uccross/open-source-autonomous-vehicle-controller/README.md

# Open Source Autonomous Vehicle Controller
