uccross/open-source-autonomous-vehicle-controller/path-finding/Readme.md

## <div align="center">Path Finding</div>

Detection of the course markers to help an autonomous vehicle find an optimal trajectory to complete the circuit. For detection of course markers(coloured cones), ML(object detection) and CV algorithms will be used.
