uccross/open-source-autonomous-vehicle-controller/documentation/docs/index.md

---
layout: home

hero:
  name: "OSAVC"
  text: "Open Source Autonomous Vehicle Controller"
  tagline:
  image:
    src: https://i.ibb.co/3Tjw3gv/OSAVC-BOARD.png
    alt: OSAVC
  actions:
    - theme: brand
      text: Getting Started
      link: /guide/introduction
    - theme: alt
      text: View on Github
      link: 'https://github.com/uccross/open-source-autonomous-vehicle-controller'

features:

  - title: Real Time Control
    details: Provides the link between real-time control and intelligent decision making.
    
  - title: OpenSource
    details: Not only an open source software project but also utilizes open source hardware solutions and technologies.

  - title: Multi-pin
    details: Convenient multi-pin wire-to-board connectors to support a wide variety of peripheral devices
---
