uccross/open-source-autonomous-vehicle-controller/documentation/docs/blog/posts/post1.md

---

date: 2023-06-28
title: 'Setting Up Hardware'
category: Tutorial
tags:
  - Hardware
  - Connections
---
> Getting Trouble Setting up the Hardware ?

---

## Connection Failure?

- Unplug PICkit from computer
- Quit MPLAB X and reopen

## PICkit configuration

## Voltage not Detected ?

J2 ICSP pins are connected incorrectly with the PICkit in-circuit debugger's pins
