uccross/open-source-autonomous-vehicle-controller/documentation/docs/projects/posts/balancingBot.md

---
Author: Carlos Espinosa
Updated: 2023-07-30
image: 
---

# Balancing Bot

> A setup with two motors ....

<!-- more -->

## Concept

it works by calculating .........
