uccross/open-source-autonomous-vehicle-controller/documentation/docs/assets/images/first_project/2.png

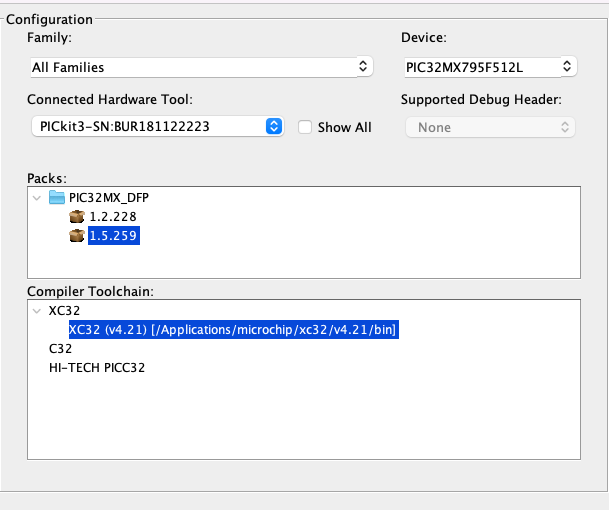
documentation/docs/assets/images/first_project/2.png
