uccross/open-source-autonomous-vehicle-controller/documentation/docs/assets/images/Hardware/OSAVC_BOARD.png

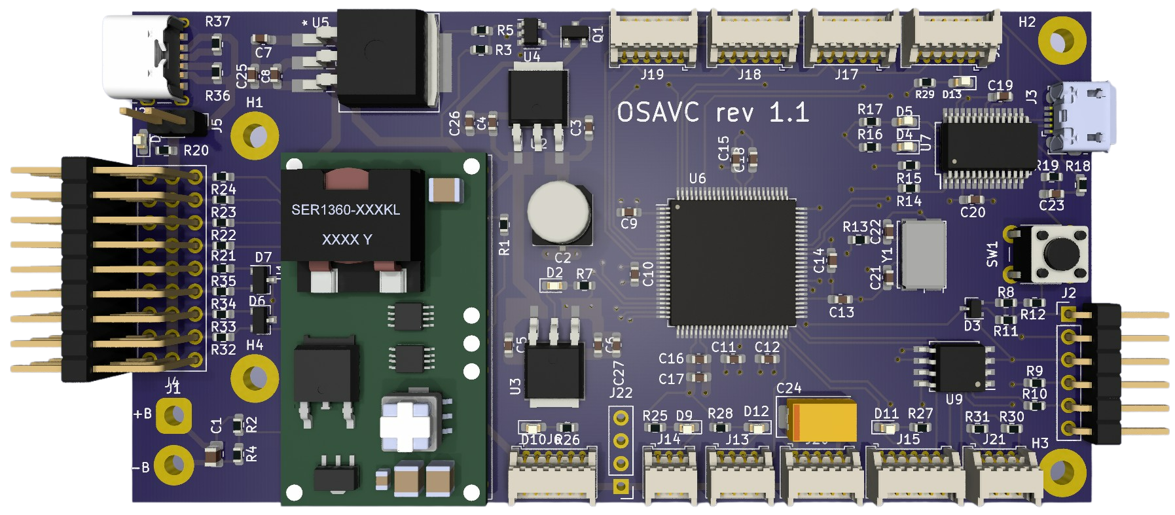
documentation/docs/assets/images/Hardware/OSAVC_BOARD.png
