uccross/open-source-autonomous-vehicle-controller/Hardware/OSAVC/OSAVC.png

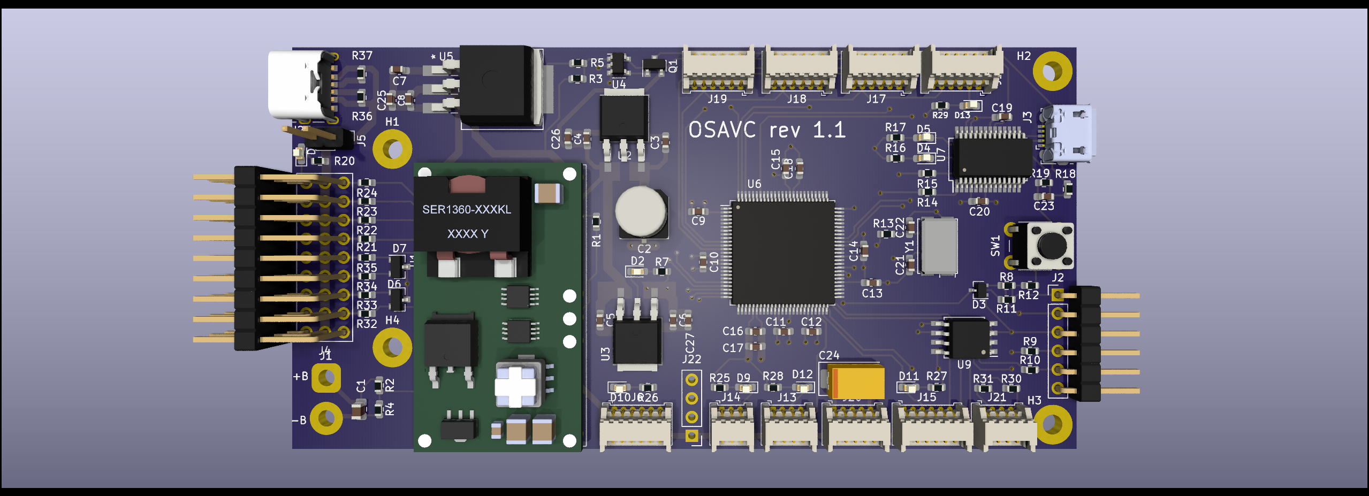
Hardware/OSAVC/OSAVC.png
