uccross/open-source-autonomous-vehicle-controller/Hardware/OSAVC/OSAVC_bottom.png

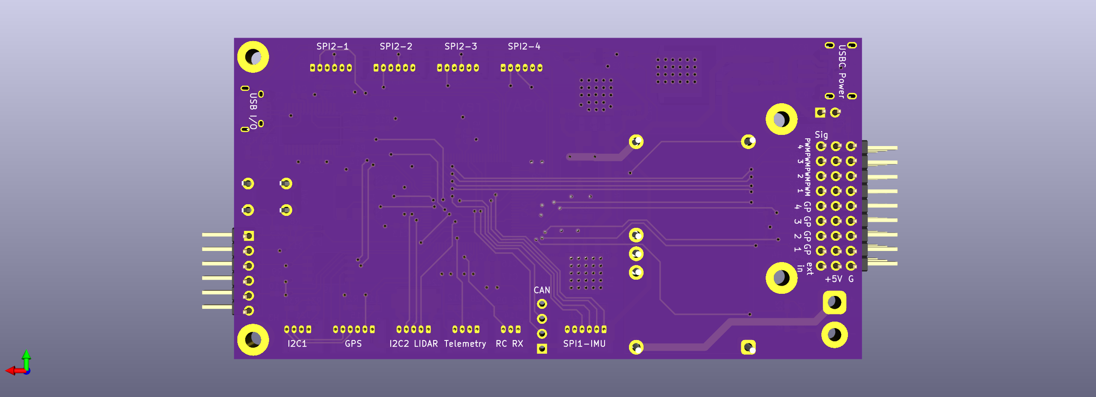
Hardware/OSAVC/OSAVC_bottom.png
