uccross/open-source-autonomous-vehicle-controller/Hardware/OSAVC/OSAVC_Iso.png

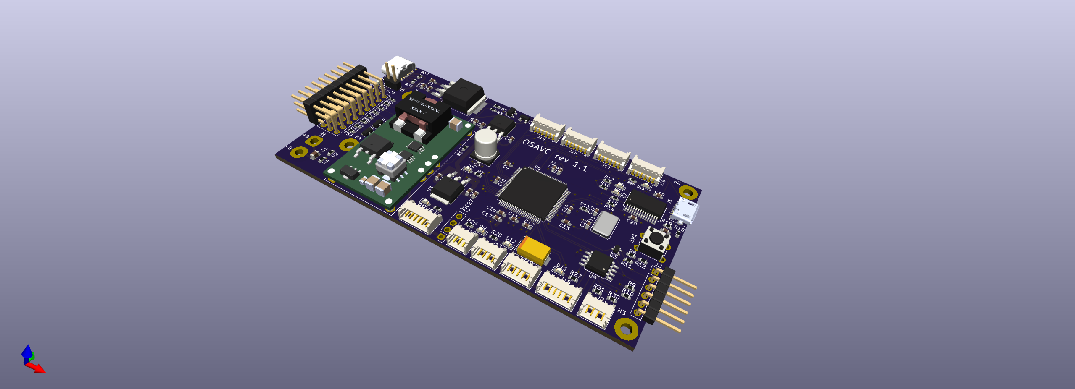
Hardware/OSAVC/OSAVC_Iso.png
