uccross/open-source-autonomous-vehicle-controller/path-finding/yolov5-coral/images/2.jpg

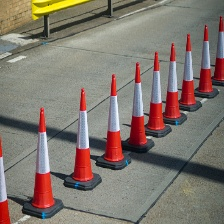
path-finding/yolov5-coral/images/2.jpg
