uccross/open-source-autonomous-vehicle-controller/path-finding/yolov5-coral/images/4.jpg

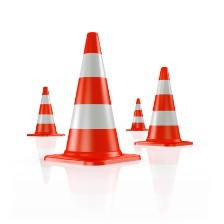
path-finding/yolov5-coral/images/4.jpg
