uccross/open-source-autonomous-vehicle-controller/python/images/bicycle_model.png

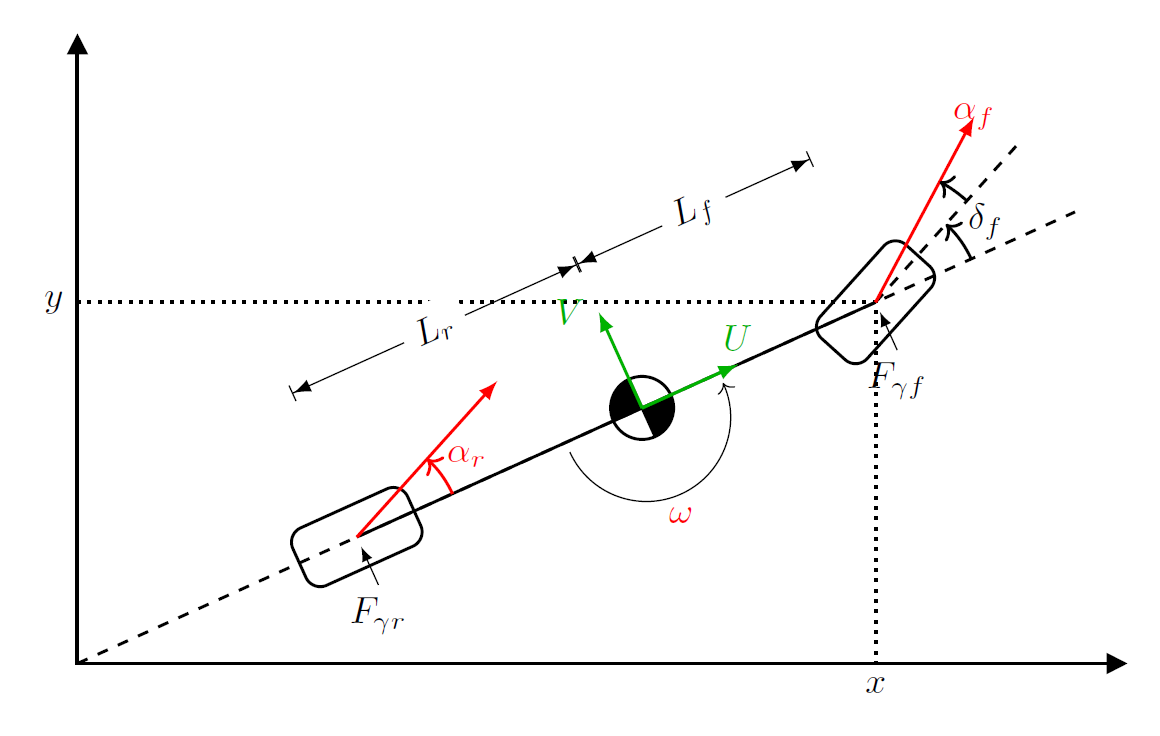
python/images/bicycle_model.png
