uccross/open-source-autonomous-vehicle-controller/Quadcopter/Mechanical/Autopilot/Daughter_Board.SLDASM

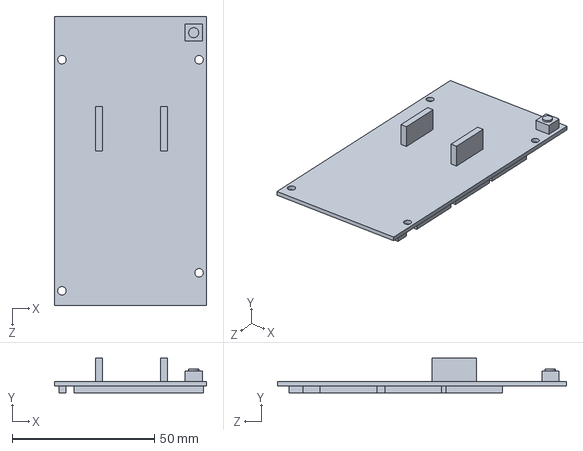
[picture p36: CAD file, 2022-08-05]
Quadcopter/Mechanical/Autopilot/Daughter_Board.SLDASM
53.5 x 12.3 x 101.7 mm
