uccross/open-source-autonomous-vehicle-controller/Quadcopter/Mechanical/Quadcopter_DJI_Flame_Wheel_F450_OSAVC_rev1.1.SLDASM

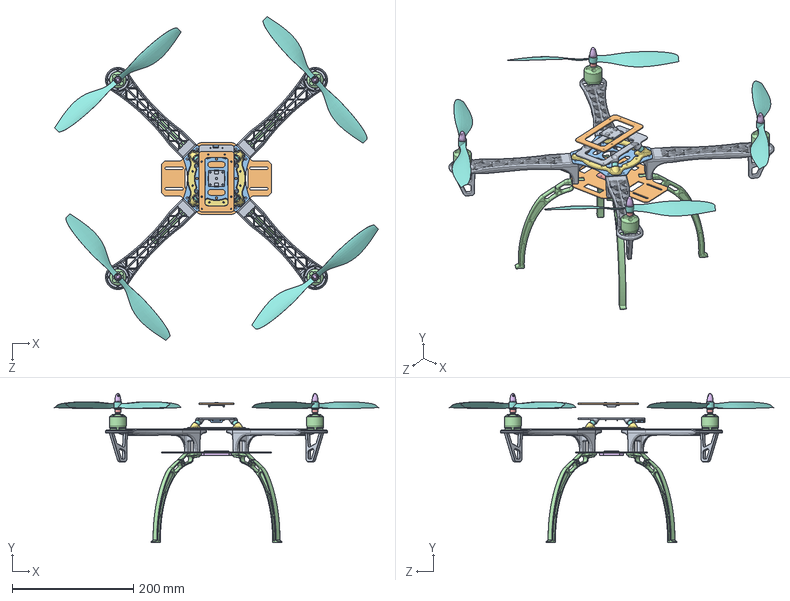
[picture p37: CAD file, 2022-12-21]
Quadcopter/Mechanical/Quadcopter_DJI_Flame_Wheel_F450_OSAVC_rev1.1.SLDASM
534.5 x 246.2 x 534.5 mm
DJI_Flame_Wheel_F450_PowerDistribution
DJI_Flame_Wheel_F450_Arm x 4
DJI_Flame_Wheel_F450_TopPCB
DJI_Flame_Wheel_F450_High_Landing_Gear x 4
Mount_Lidar_V1_fixture
Mount_Lidar_V1_base
Mount_autopilot_vibration_suppression
Rubber_vibration_isolation x 4
Mount_Controller
Mount_autopilot_fixture
Mount_FrSky_R-XSR_Tiny_16
BLDC_A2212_13T_1000KV x 4
BLDC_A2212_13T_1000KV_PropCollar x 4
BLDC_A2212_13T_1000KV_PropNut x 4
BLDC_A2212_13T_1000KV_PropThread x 4
Prop-10x4_5 x 4
Qwiic_9DoF_IMU_Sparkfun
Mount_Raspberry_Pi
