uccross/open-source-autonomous-vehicle-controller/Rover/Mechanical/Frame/MG996R SERVO/MG996R SBORKA.SLDASM

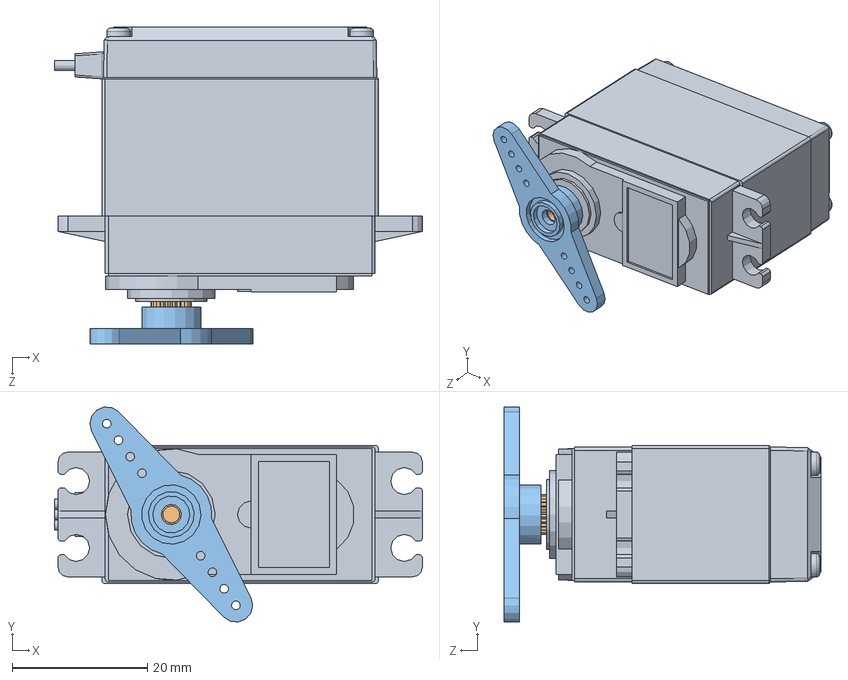
[picture p38: CAD file, 2022-12-21]
Rover/Mechanical/Frame/MG996R SERVO/MG996R SBORKA.SLDASM
54.5 x 31.8 x 47.0 mm
Servo MG996R
Servo MG996R Shaft
Servo MG996R arm01
