uccross/open-source-autonomous-vehicle-controller/Rover/Mechanical/Frame/Wheel/Wheel_RC.SLDASM

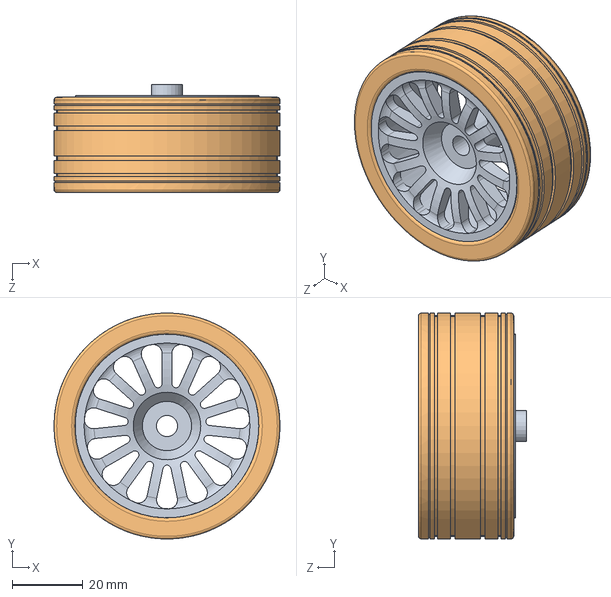
[picture p39: CAD file, 2022-12-21]
Rover/Mechanical/Frame/Wheel/Wheel_RC.SLDASM
64.0 x 64.0 x 30.6 mm
wheel_rin
Wheel
