uccross/open-source-autonomous-vehicle-controller/Rover/Mechanical/Rover_V1.SLDASM

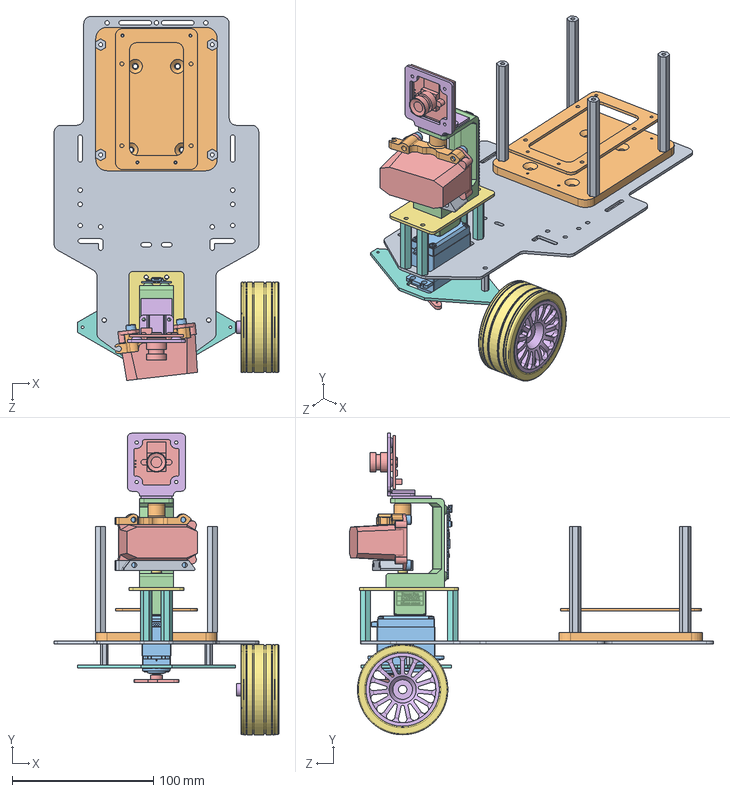
[picture p40: CAD file, 2022-12-21]
Rover/Mechanical/Rover_V1.SLDASM
159.2 x 213.5 x 257.7 mm
Chassis_upper
micro_holder
Servo MG996R
Servo MG996R Shaft
Servo MG996R arm01
wheel_rin
Wheel
Mount_Wheel_axis-Stearing_servo
Standoff_15mm x 2
Mount_Raspberry_Pi
RaspberryPi_Pico
Tower-Pro-MG90S
LIDAR-Lite_V3HP_Garmin
Board_AS5047D
Servo_lever
Magnet_AS5047D
Mount_Lidar-Servo
Mount_Lidar-Magnet
Screw_M4_Hexhead x 4
Mount_Hybrid_sensor
Arducam_B0332
Mount_Hybrid_sensor-Camera
Hybrid_sensor_Rover_mount
Hex_Standoffs x 4
Hex_standoff_75mm x 4
