uccross/open-source-autonomous-vehicle-controller/Quadcopter/Mechanical/Autopilot/Max32.SLDASM

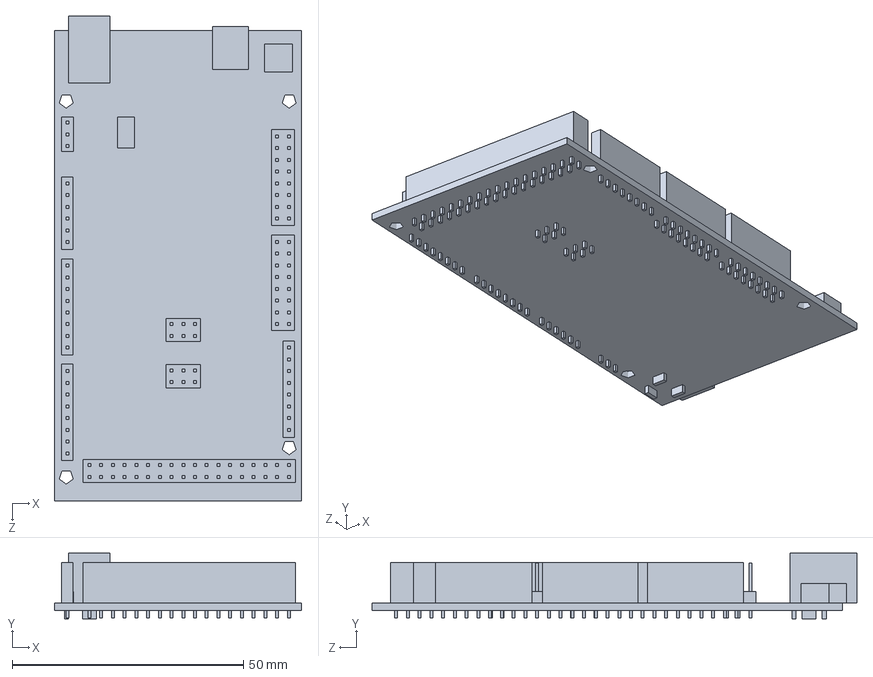
[picture p41: CAD file, 2022-08-05]
Quadcopter/Mechanical/Autopilot/Max32.SLDASM
53.5 x 14.2 x 105.0 mm
