uccross/open-source-autonomous-vehicle-controller/Quadcopter/Mechanical/Frame/DJI_Flame_Wheel_F450.SLDASM

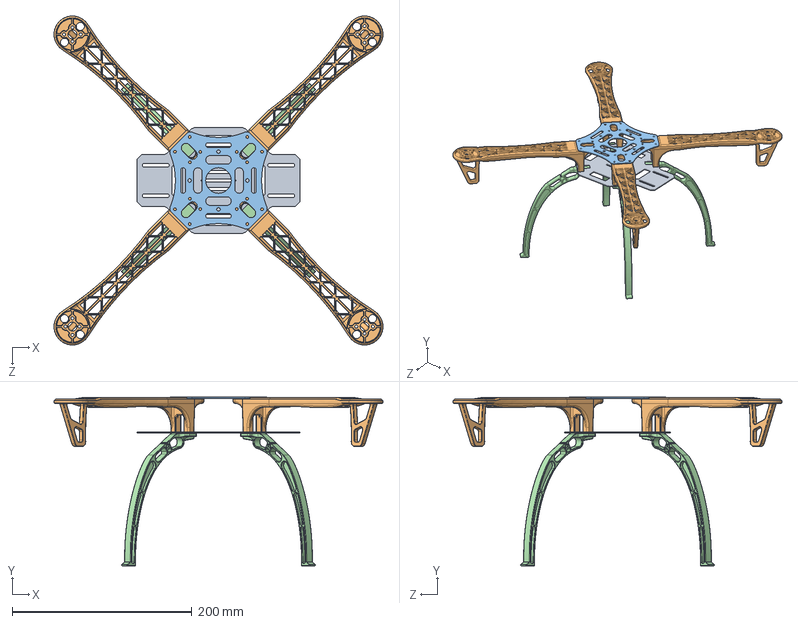
[picture p42: CAD file, 2022-08-05]
Quadcopter/Mechanical/Frame/DJI_Flame_Wheel_F450.SLDASM
366.4 x 188.2 x 366.4 mm
DJI_Flame_Wheel_F450_PowerDistribution
DJI_Flame_Wheel_F450_Arm x 4
DJI_Flame_Wheel_F450_TopPCB
DJI_Flame_Wheel_F450_High_Landing_Gear x 4
