uccross/open-source-autonomous-vehicle-controller/Self-balancing_bot/Mechanical/Main_support_front.SLDPRT

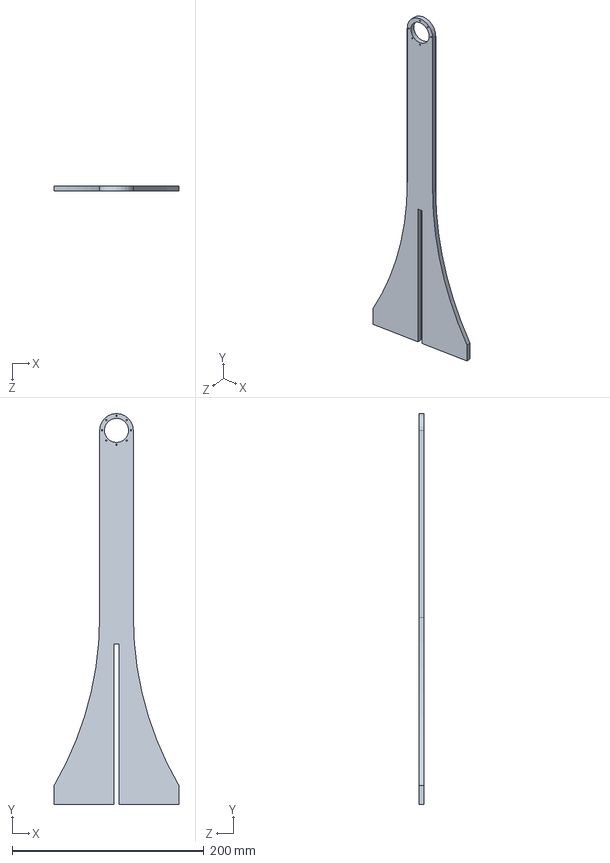
[picture p44: CAD file, 2023-08-13]
Self-balancing_bot/Mechanical/Main_support_front.SLDPRT
130.0 x 407.6 x 5.40 mm
