uccross/open-source-autonomous-vehicle-controller/Quadcopter/Mechanical/Motor/BLDC_A2212_13T_1000KV_Assemly.SLDASM

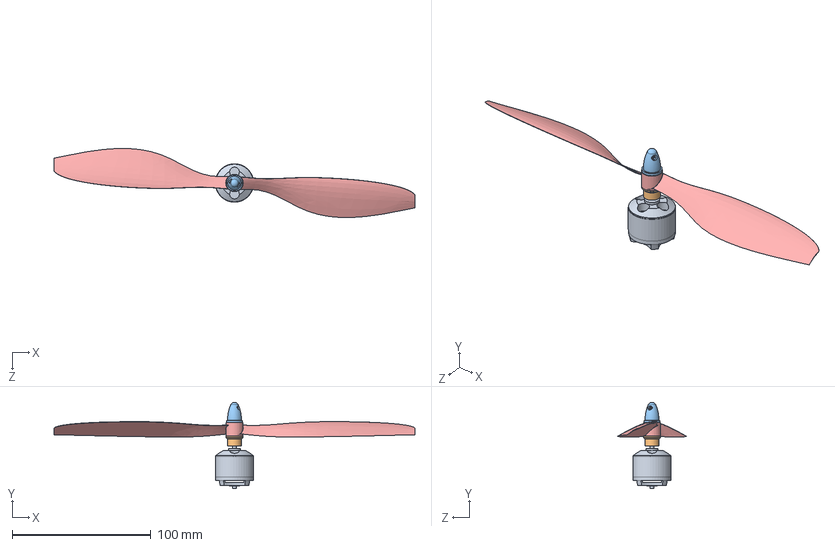
[picture p45: CAD file, 2022-08-05]
Quadcopter/Mechanical/Motor/BLDC_A2212_13T_1000KV_Assemly.SLDASM
260.0 x 62.3 x 49.7 mm
BLDC_A2212_13T_1000KV
BLDC_A2212_13T_1000KV_PropCollar
BLDC_A2212_13T_1000KV_PropNut
BLDC_A2212_13T_1000KV_PropThread
Prop-10x4_5
