uccross/open-source-autonomous-vehicle-controller/Rover/Mechanical/Frame/Rover_frame.SLDASM

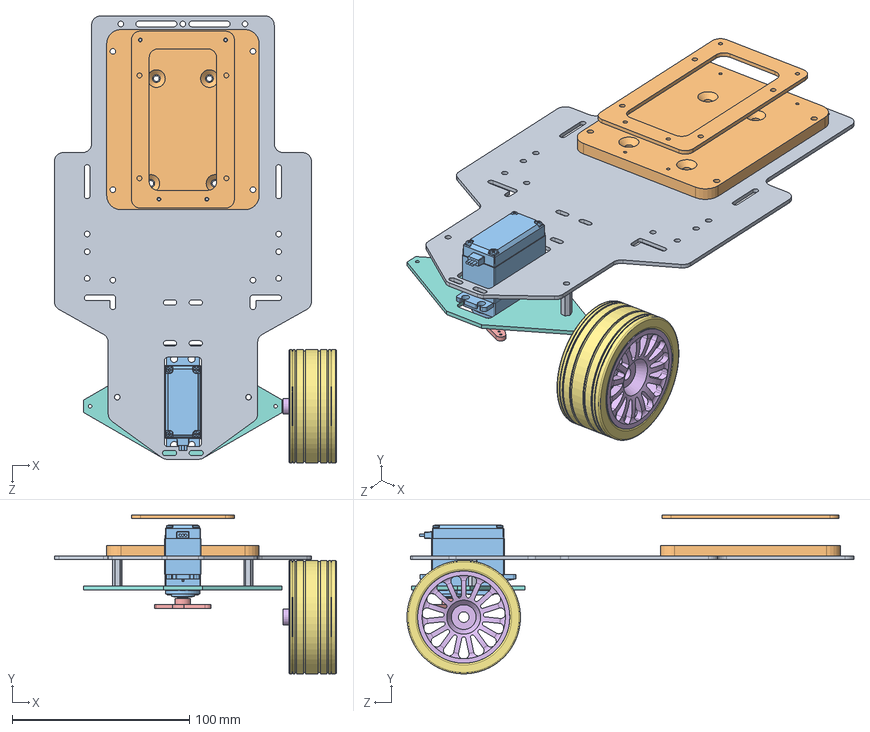
[picture p46: CAD file, 2022-12-21]
Rover/Mechanical/Frame/Rover_frame.SLDASM
159.2 x 89.5 x 252.1 mm
Chassis_upper
micro_holder
Servo MG996R
Servo MG996R Shaft
Servo MG996R arm01
wheel_rin
Wheel
Mount_Wheel_axis-Stearing_servo
Standoff_15mm x 2
Mount_Raspberry_Pi
