uccross/open-source-autonomous-vehicle-controller/Quadcopter/Mechanical/Stabilization_test/Stabilization_test_platform_T-joint_assembly.SLDASM

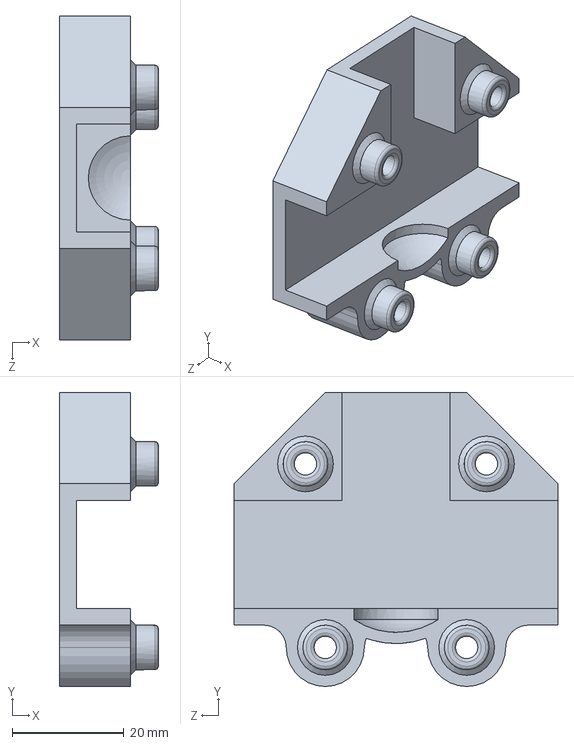
[picture p47: CAD file, 2022-12-21]
Quadcopter/Mechanical/Stabilization_test/Stabilization_test_platform_T-joint_assembly.SLDASM
17.7 x 52.7 x 58.0 mm
