uccross/open-source-autonomous-vehicle-controller/Rover/Mechanical/Hybrid_sensor/Hybrid_sensor.SLDASM

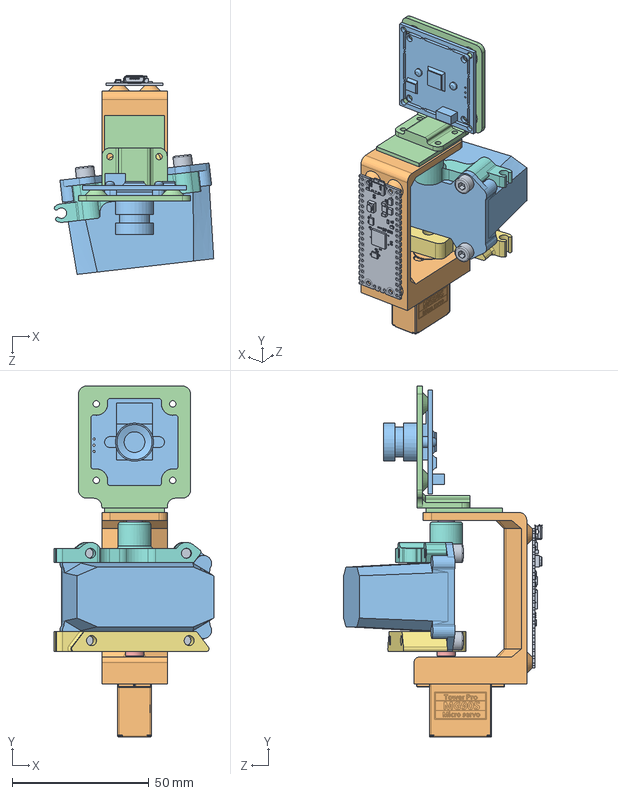
[picture p48: CAD file, 2022-12-21]
Rover/Mechanical/Hybrid_sensor/Hybrid_sensor.SLDASM
58.4 x 128.6 x 72.8 mm
RaspberryPi_Pico
Tower-Pro-MG90S
LIDAR-Lite_V3HP_Garmin
Board_AS5047D
Servo_lever
Magnet_AS5047D
Mount_Lidar-Servo
Mount_Lidar-Magnet
Screw_M4_Hexhead x 4
Mount_Hybrid_sensor
Arducam_B0332
Mount_Hybrid_sensor-Camera
