uccross/open-source-autonomous-vehicle-controller/Self-balancing_bot/Mechanical/Encoder_AS5047D.SLDASM

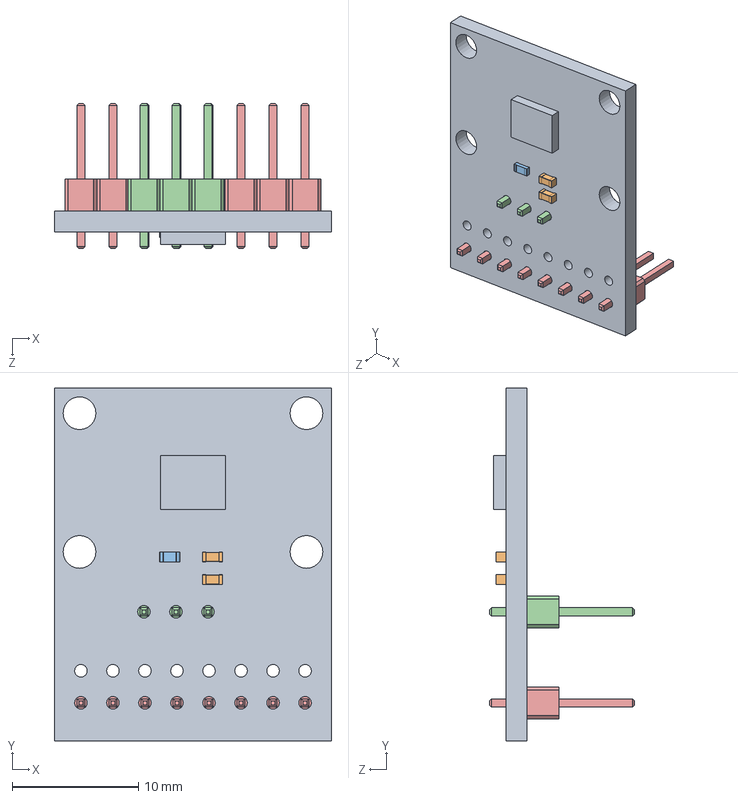
[picture p49: CAD file, 2023-08-13]
Self-balancing_bot/Mechanical/Encoder_AS5047D.SLDASM
22.0 x 28.0 x 11.5 mm
PCB_AS5047D^Encoder_AS5047D
C_0603_1608^Encoder_AS5047D x 2
R_0603_1608^Encoder_AS5047D
Header_1x03_P2.54mm_Vertical^Encoder_AS5047D
Header_1x08_P2.54mm_Vertical^Encoder_AS5047D
