uccross/open-source-autonomous-vehicle-controller/Self-balancing_bot/Mechanical/Propeller_Assembly.SLDASM

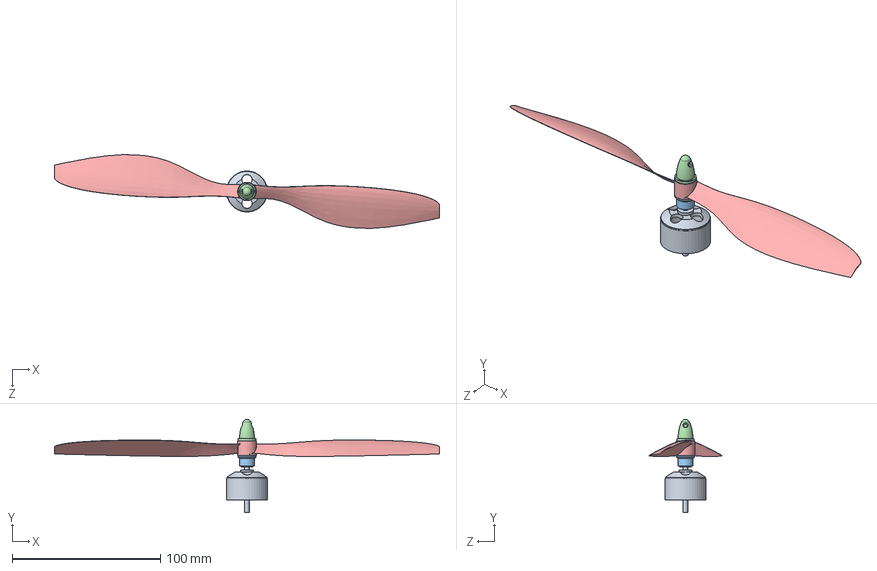
[picture p50: CAD file, 2023-08-13]
Self-balancing_bot/Mechanical/Propeller_Assembly.SLDASM
260.0 x 63.0 x 49.7 mm
BLDC_A2212_13T_1000KV_MotorRotator^Propeller_Assembly
BLDC_A2212_13T_1000KV_PropellerThread^Propeller_Assembly
BLDC_A2212_13T_1000KV_PropellerCollar^Propeller_Assembly
BLDC_A2212_13T_1000KV_PropellerNut^Propeller_Assembly
Propeller-10x4_5^Propeller_Assembly
