uccross/open-source-autonomous-vehicle-controller/Self-balancing_bot/Mechanical/Sparkfun_Qwiic_9DoF_IMU.SLDASM

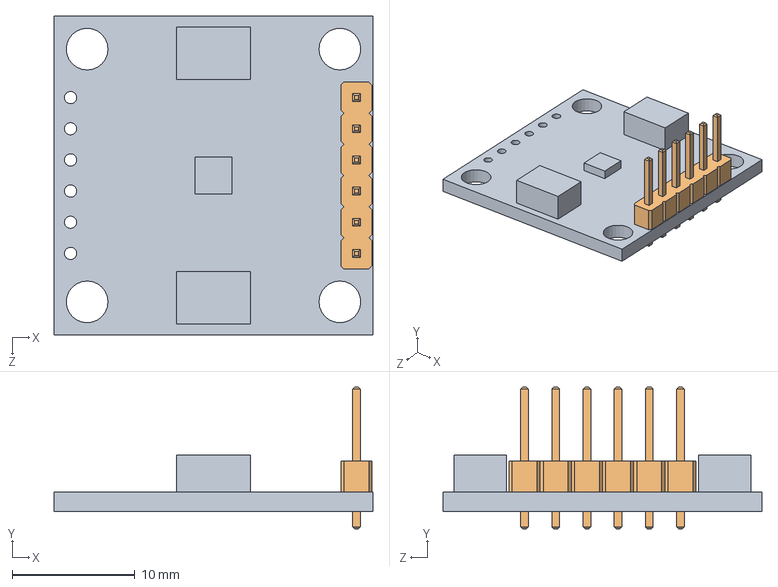
[picture p51: CAD file, 2023-08-13]
Self-balancing_bot/Mechanical/Sparkfun_Qwiic_9DoF_IMU.SLDASM
26.0 x 11.5 x 26.0 mm
Sparkfun_IMU_Qwiic_9DoF^Sparkfun_Qwiic_9DoF_IMU
Header_1x06_P2.54mm_Vertical^Sparkfun_Qwiic_9DoF_IMU
