uccross/open-source-autonomous-vehicle-controller/Self-balancing_bot/Mechanical/Main_support_back.SLDPRT

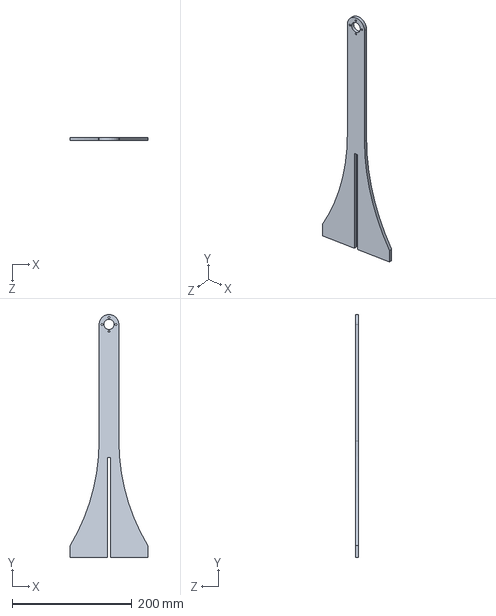
[picture p52: CAD file, 2023-08-13]
Self-balancing_bot/Mechanical/Main_support_back.SLDPRT
130.0 x 406.6 x 5.40 mm
