uccross/open-source-autonomous-vehicle-controller/Self-balancing_bot/Mechanical/Main_support_middle_stand.SLDPRT

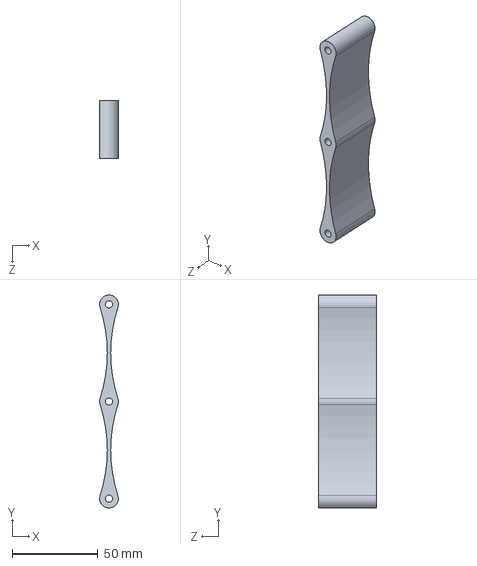
[picture p53: CAD file, 2023-08-13]
Self-balancing_bot/Mechanical/Main_support_middle_stand.SLDPRT
11.0 x 124.1 x 33.9 mm
