uccross/open-source-autonomous-vehicle-controller/Self-balancing_bot/Mechanical/Balancing_bot-Base.SLDASM

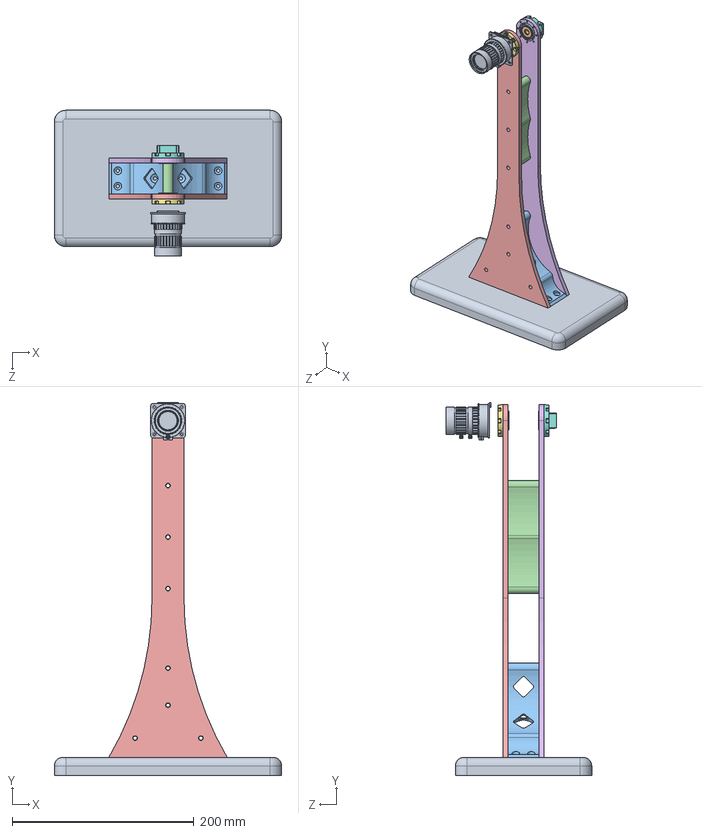
[picture p54: CAD file, 2023-08-13]
Self-balancing_bot/Mechanical/Balancing_bot-Base.SLDASM
250.0 x 410.0 x 160.0 mm
MDF_Base
Bearing_6mm x 2
Main_support_middle_holder
Main_support_middle_stand
Main_support_front
Main_support_back
Bearing_holder_front
Bearing_holder_back
PPi_HQ_Camera_with_lens
