uccross/open-source-autonomous-vehicle-controller/Self-balancing_bot/Mechanical/Main_support_middle_holder.SLDPRT

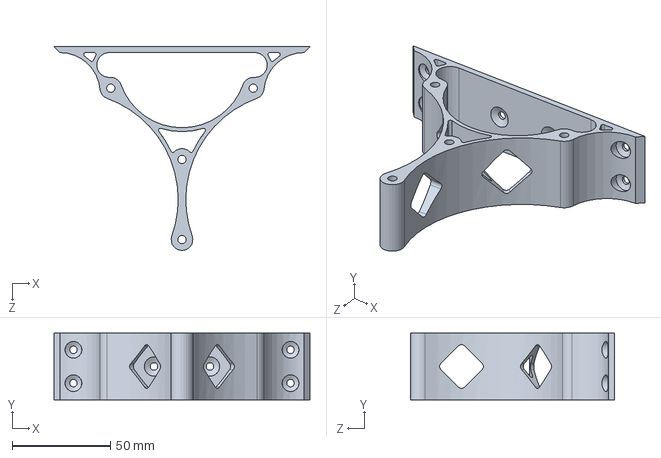
[picture p55: CAD file, 2023-08-13]
Self-balancing_bot/Mechanical/Main_support_middle_holder.SLDPRT
130.0 x 33.9 x 103.4 mm
