uccross/open-source-autonomous-vehicle-controller/Quadcopter/Mechanical/3D_Printable/Mount_IMU_CM4-IO-BASE-B.SLDPRT

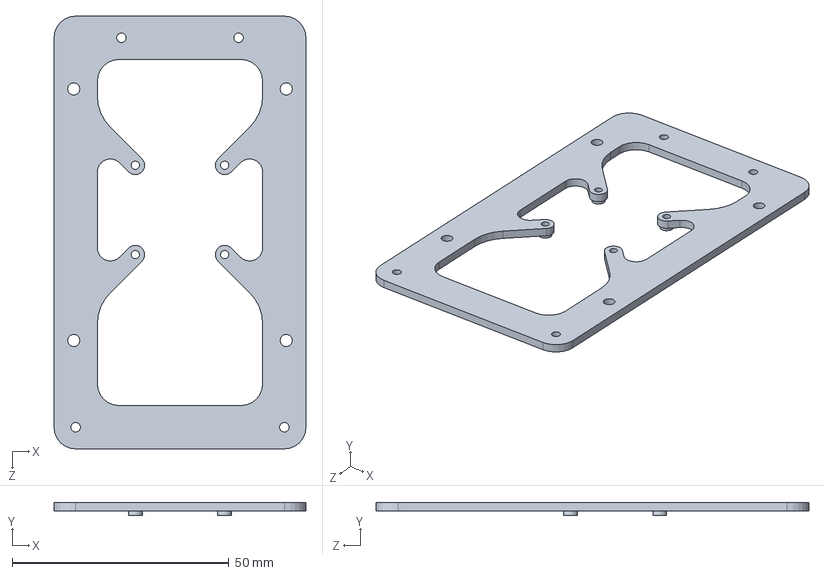
[picture p56: CAD file, 2022-12-21]
Quadcopter/Mechanical/3D_Printable/Mount_IMU_CM4-IO-BASE-B.SLDPRT
58.1 x 3.00 x 99.8 mm
