uccross/open-source-autonomous-vehicle-controller/Quadcopter/Mechanical/Frame/DJI_Flame_Wheel_F450_TopPCB.SLDPRT

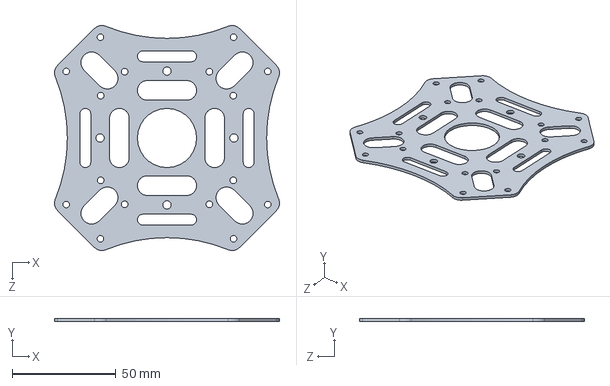
[picture p57: CAD file, 2022-08-05]
Quadcopter/Mechanical/Frame/DJI_Flame_Wheel_F450_TopPCB.SLDPRT
108.4 x 1.50 x 108.4 mm
