uccross/open-source-autonomous-vehicle-controller/Quadcopter/Mechanical/Hardware/Rubber_vibration_isolation.SLDPRT

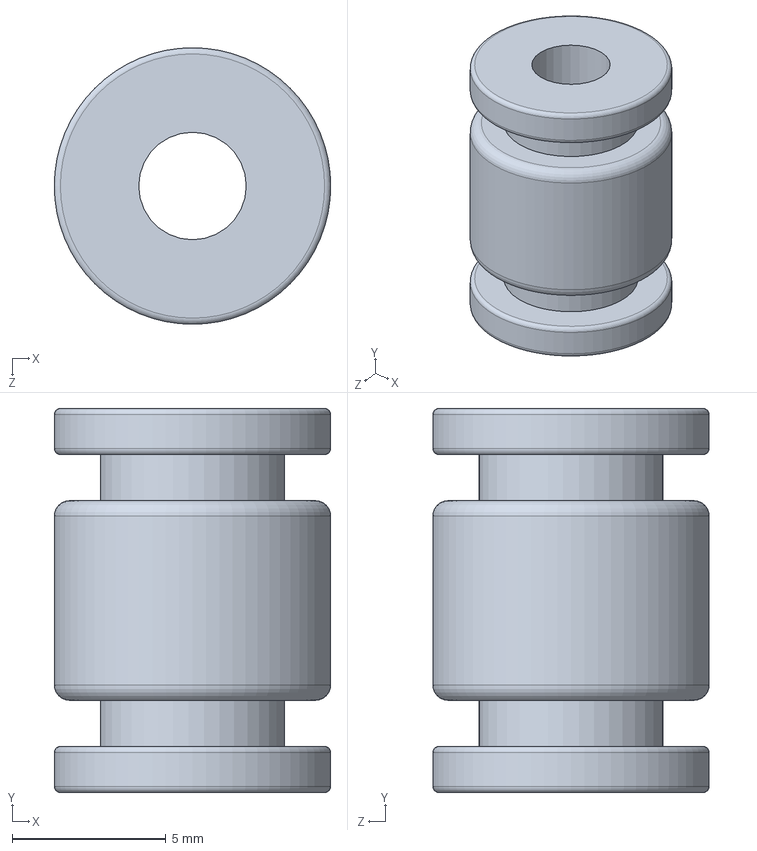
[picture p58: CAD file, 2022-08-05]
Quadcopter/Mechanical/Hardware/Rubber_vibration_isolation.SLDPRT
9.00 x 12.5 x 9.00 mm
