uccross/open-source-autonomous-vehicle-controller/Quadcopter/Mechanical/Motor/Prop-10x4_5.SLDPRT

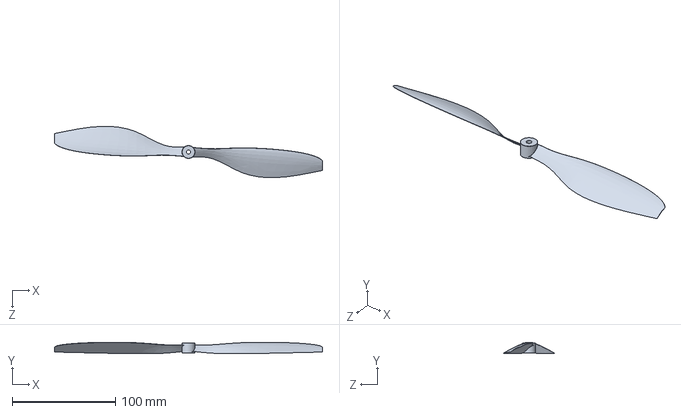
[picture p59: CAD file, 2022-08-05]
Quadcopter/Mechanical/Motor/Prop-10x4_5.SLDPRT
260.0 x 11.1 x 49.7 mm
