uccross/open-source-autonomous-vehicle-controller/Quadcopter/Mechanical/Sensors/mRo_GPS_u-Blox_Neo-M8N.sldprt

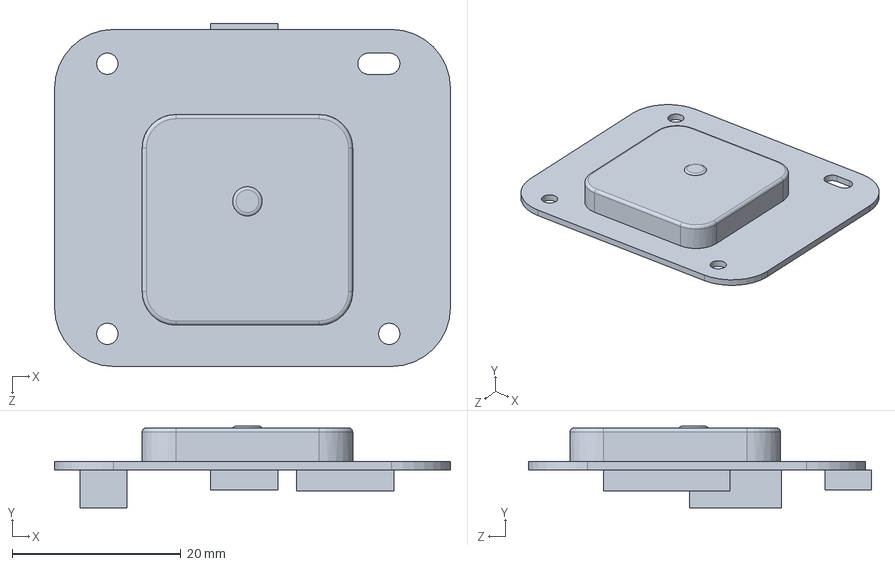
[picture p60: CAD file, 2022-08-05]
Quadcopter/Mechanical/Sensors/mRo_GPS_u-Blox_Neo-M8N.sldprt
47.0 x 9.70 x 40.7 mm
