uccross/open-source-autonomous-vehicle-controller/Quadcopter/Mechanical/Stabilization_test/Stabilization_test_mount.SLDPRT

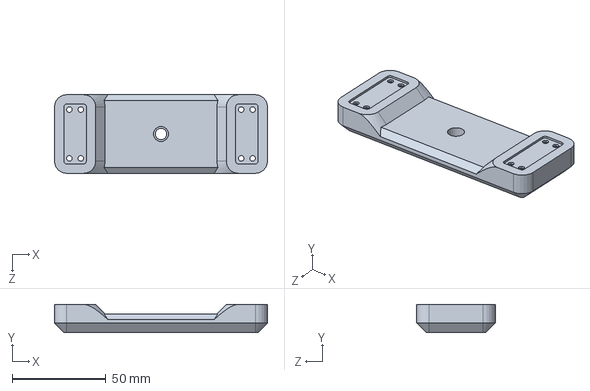
[picture p61: CAD file, 2022-12-21]
Quadcopter/Mechanical/Stabilization_test/Stabilization_test_mount.SLDPRT
113.8 x 15.0 x 42.0 mm
