uccross/open-source-autonomous-vehicle-controller/Rover/Mechanical/3D_Print/Mount_Lidar-Magnet.STEP

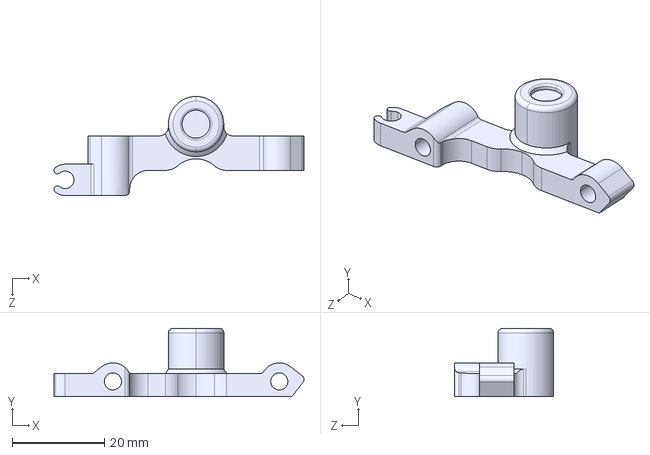
[picture p62: CAD file, 2022-12-21]
Rover/Mechanical/3D_Print/Mount_Lidar-Magnet.STEP
54.1 x 14.8 x 21.5 mm
