uccross/open-source-autonomous-vehicle-controller/Rover/Mechanical/Frame/Mount_Raspberry_Pi.SLDPRT

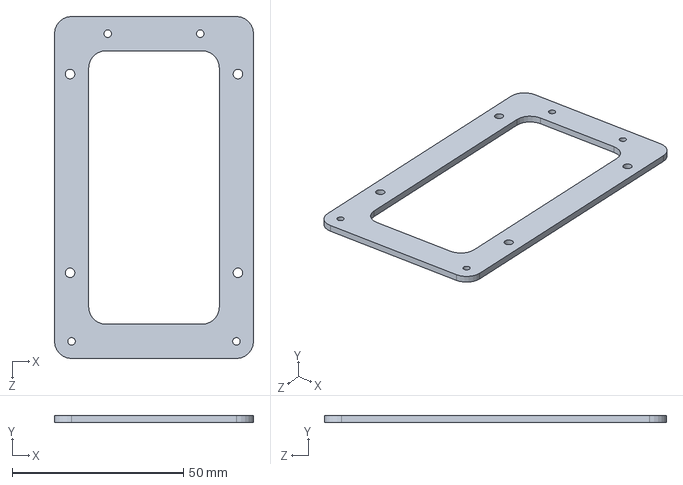
[picture p63: CAD file, 2022-12-21]
Rover/Mechanical/Frame/Mount_Raspberry_Pi.SLDPRT
58.1 x 2.00 x 99.8 mm
