uccross/open-source-autonomous-vehicle-controller/Rover/Mechanical/Hybrid_sensor/Magnet_AS5047D.SLDPRT

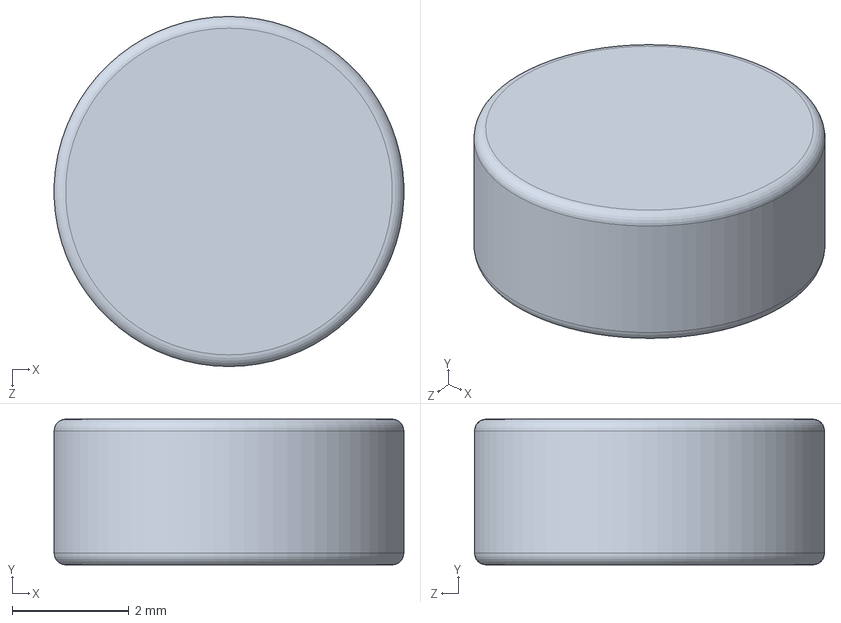
[picture p64: CAD file, 2022-12-21]
Rover/Mechanical/Hybrid_sensor/Magnet_AS5047D.SLDPRT
5.99 x 2.50 x 6.00 mm
