uccross/open-source-autonomous-vehicle-controller/Self-balancing_bot/Mechanical/MDF_Base.SLDPRT

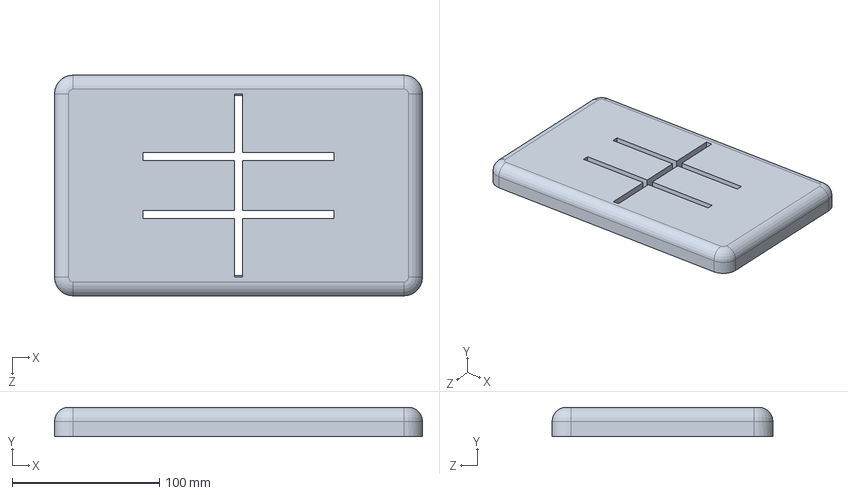
[picture p65: CAD file, 2023-08-13]
Self-balancing_bot/Mechanical/MDF_Base.SLDPRT
250.0 x 20.0 x 150.0 mm
