uccross/open-source-autonomous-vehicle-controller/Quadcopter/Mechanical/3D_Printable/Mount_autopilot_vibration_suppression.sldprt

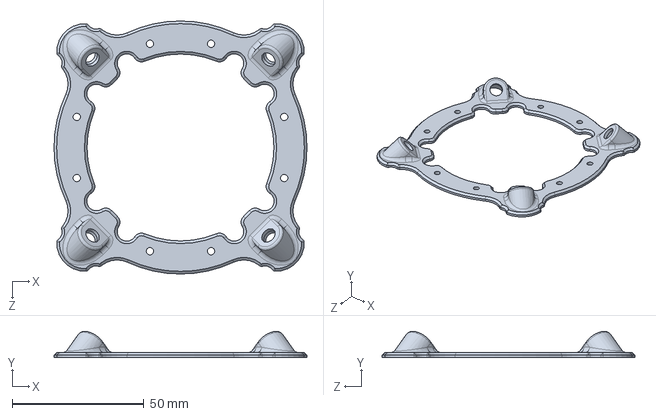
[picture p66: CAD file, 2022-08-05]
Quadcopter/Mechanical/3D_Printable/Mount_autopilot_vibration_suppression.sldprt
96.0 x 10.0 x 96.0 mm
