uccross/open-source-autonomous-vehicle-controller/Quadcopter/Mechanical/Motor/BLDC_A2212_13T_1000KV_PropThread.SLDPRT

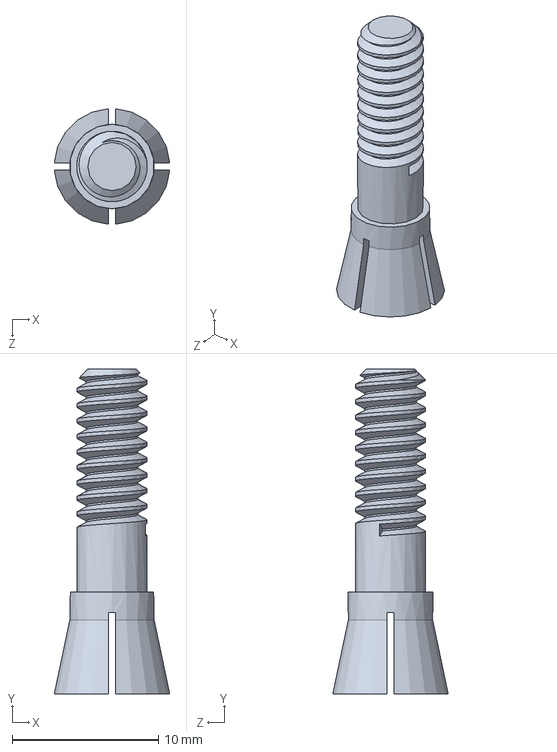
[picture p67: CAD file, 2022-08-05]
Quadcopter/Mechanical/Motor/BLDC_A2212_13T_1000KV_PropThread.SLDPRT
7.91 x 22.3 x 7.91 mm
