uccross/open-source-autonomous-vehicle-controller/Quadcopter/Mechanical/Sensors/Qwiic_9DoF_IMU_Sparkfun.SLDPRT

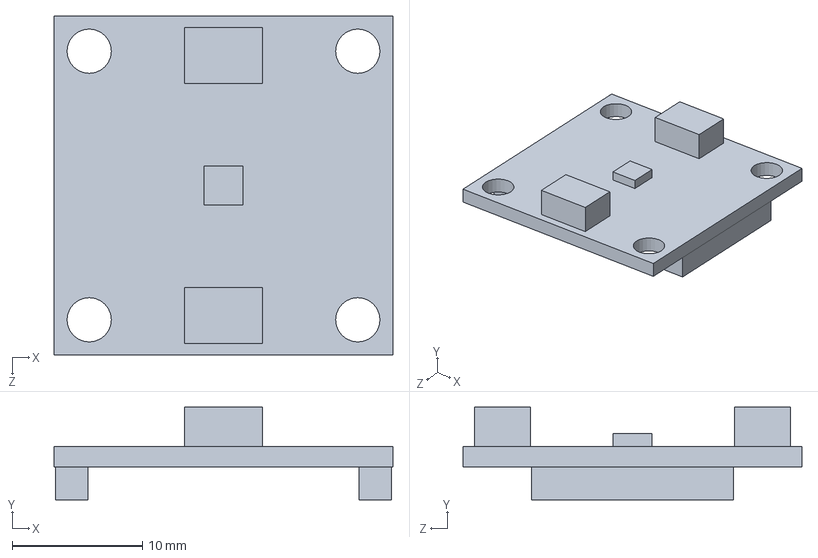
[picture p68: CAD file, 2022-08-05]
Quadcopter/Mechanical/Sensors/Qwiic_9DoF_IMU_Sparkfun.SLDPRT
26.0 x 7.10 x 26.0 mm
