uccross/open-source-autonomous-vehicle-controller/Quadcopter/Mechanical/Stabilization_test/Stabilization_test_angle_limit_ring.SLDPRT

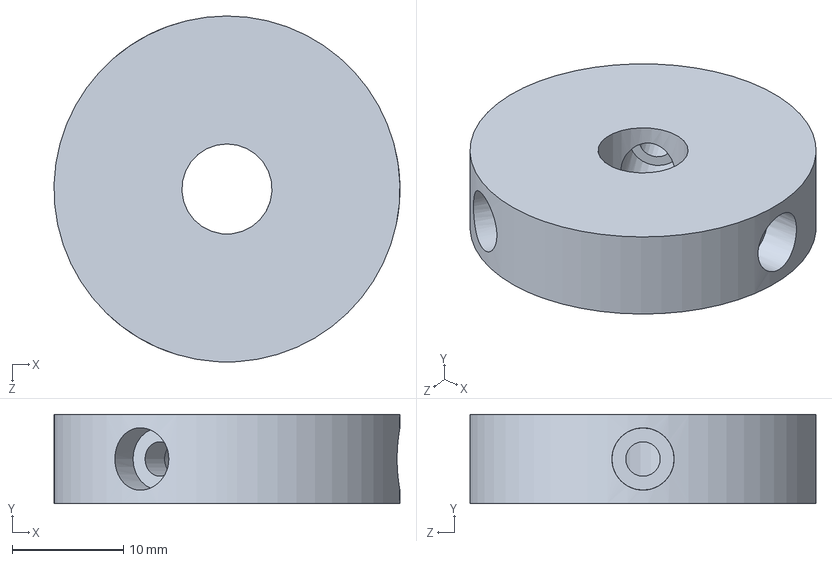
[picture p69: CAD file, 2022-12-21]
Quadcopter/Mechanical/Stabilization_test/Stabilization_test_angle_limit_ring.SLDPRT
31.1 x 8.00 x 31.1 mm
