uccross/open-source-autonomous-vehicle-controller/Rover/Mechanical/3D_Print/Mount_Lidar-Servo.STEP

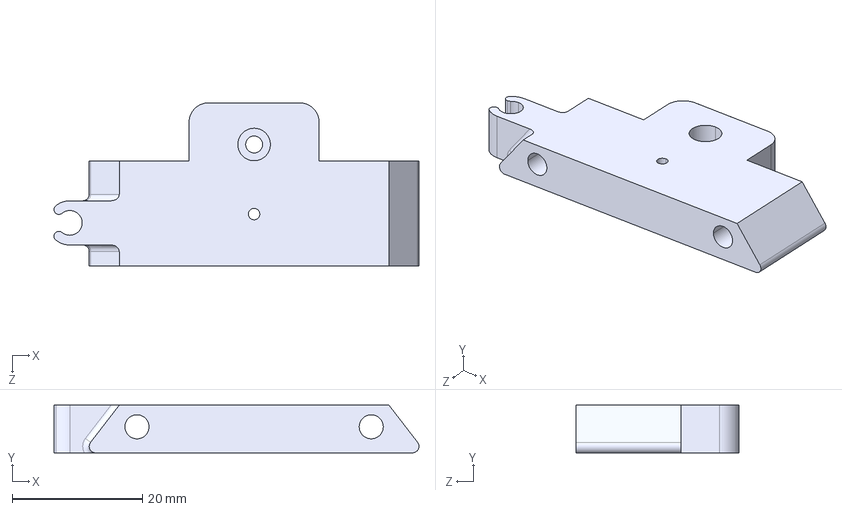
[picture p70: CAD file, 2022-12-21]
Rover/Mechanical/3D_Print/Mount_Lidar-Servo.STEP
56.1 x 7.33 x 25.1 mm
