uccross/open-source-autonomous-vehicle-controller/Rover/Mechanical/Frame/MG996R SERVO/Servo MG996R.SLDPRT

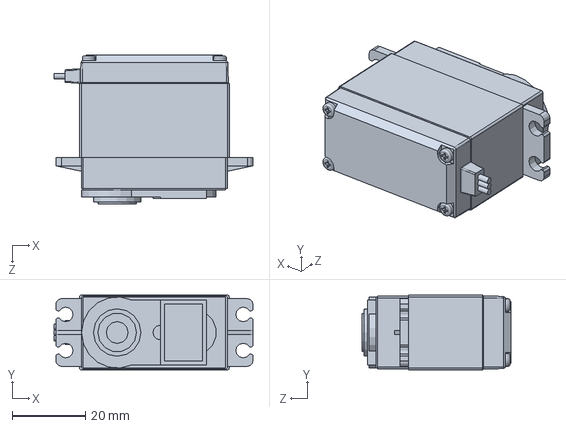
[picture p71: CAD file, 2022-12-21]
Rover/Mechanical/Frame/MG996R SERVO/Servo MG996R.SLDPRT
54.5 x 20.5 x 40.7 mm
