uccross/open-source-autonomous-vehicle-controller/Rover/Mechanical/Frame/Wheel/Wheel.SLDPRT

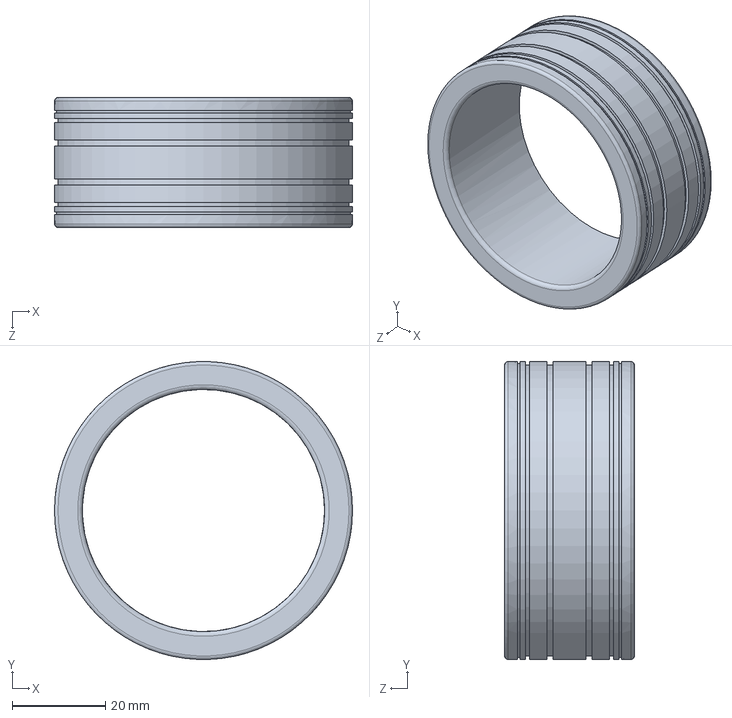
[picture p72: CAD file, 2022-12-21]
Rover/Mechanical/Frame/Wheel/Wheel.SLDPRT
64.0 x 64.0 x 27.9 mm
