uccross/open-source-autonomous-vehicle-controller/Rover/Mechanical/Hybrid_sensor/Hex_Standoffs.SLDPRT

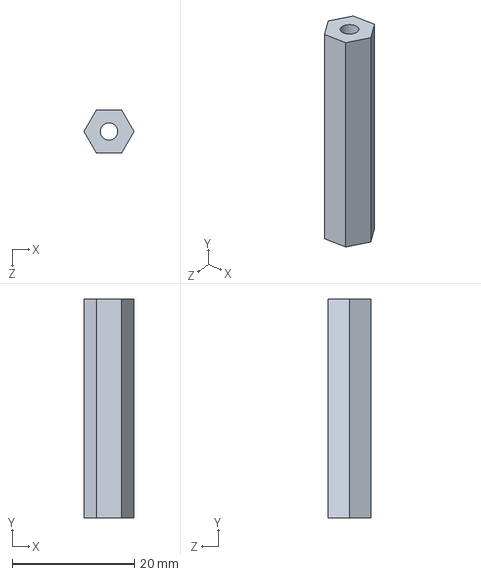
[picture p73: CAD file, 2022-12-21]
Rover/Mechanical/Hybrid_sensor/Hex_Standoffs.SLDPRT
8.21 x 35.8 x 7.11 mm
