uccross/open-source-autonomous-vehicle-controller/Quadcopter/Mechanical/3D_Printable/Mount_Controller.SLDPRT

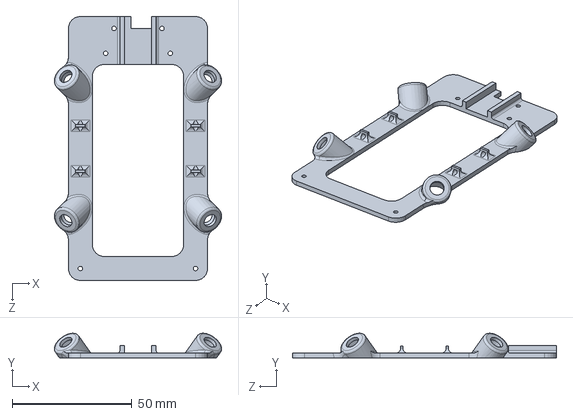
[picture p74: CAD file, 2022-08-05]
Quadcopter/Mechanical/3D_Printable/Mount_Controller.SLDPRT
69.8 x 10.3 x 110.2 mm
