uccross/open-source-autonomous-vehicle-controller/Quadcopter/Mechanical/Frame/DJI_Flame_Wheel_F450_PowerDistribution.SLDPRT

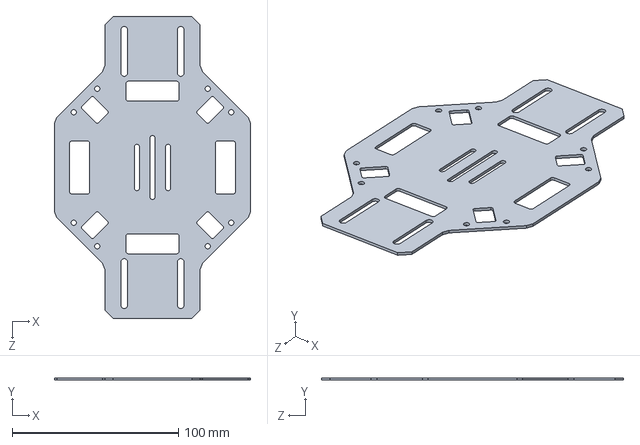
[picture p75: CAD file, 2022-08-05]
Quadcopter/Mechanical/Frame/DJI_Flame_Wheel_F450_PowerDistribution.SLDPRT
118.0 x 1.50 x 181.6 mm
