uccross/open-source-autonomous-vehicle-controller/Quadcopter/Mechanical/Stabilization_test/Stabilization_test_fixture.SLDPRT

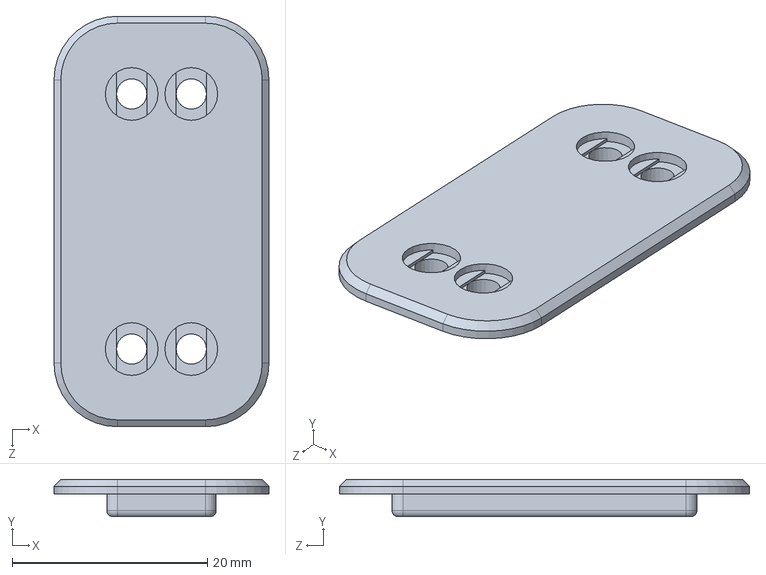
[picture p76: CAD file, 2022-12-21]
Quadcopter/Mechanical/Stabilization_test/Stabilization_test_fixture.SLDPRT
22.0 x 3.80 x 42.0 mm
