uccross/open-source-autonomous-vehicle-controller/Rover/Mechanical/3D_Print/Mount_Hybrid_sensor-Camera.STEP

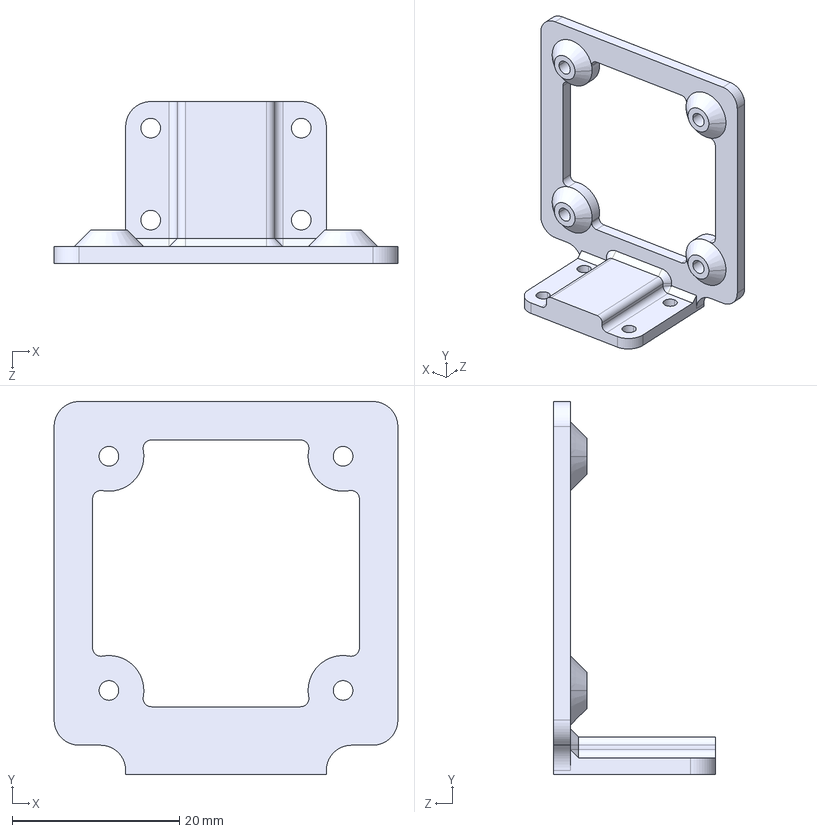
[picture p77: CAD file, 2022-12-21]
Rover/Mechanical/3D_Print/Mount_Hybrid_sensor-Camera.STEP
41.1 x 44.6 x 19.3 mm
