uccross/open-source-autonomous-vehicle-controller/Rover/Mechanical/Frame/MG996R SERVO/Servo MG996R arm01.SLDPRT

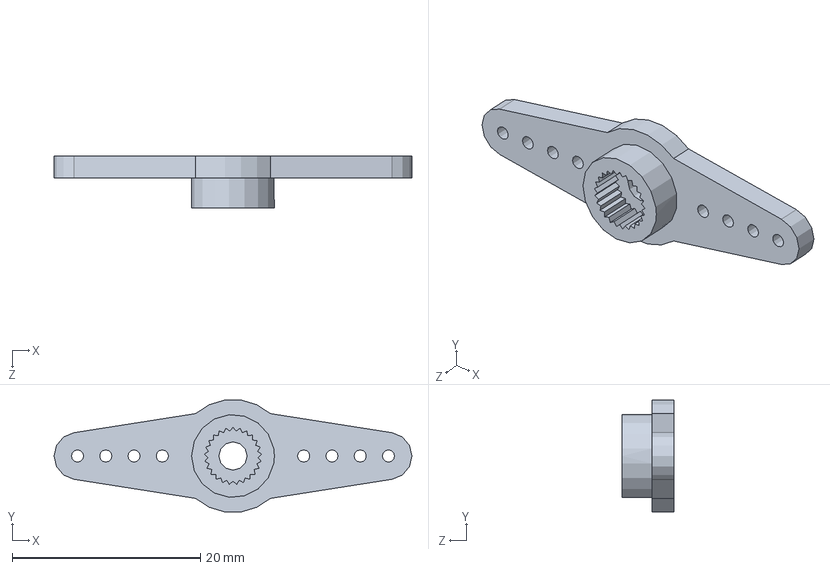
[picture p78: CAD file, 2022-12-21]
Rover/Mechanical/Frame/MG996R SERVO/Servo MG996R arm01.SLDPRT
38.0 x 11.9 x 5.50 mm
