uccross/open-source-autonomous-vehicle-controller/Rover/Mechanical/Frame/Pi_tray.stp

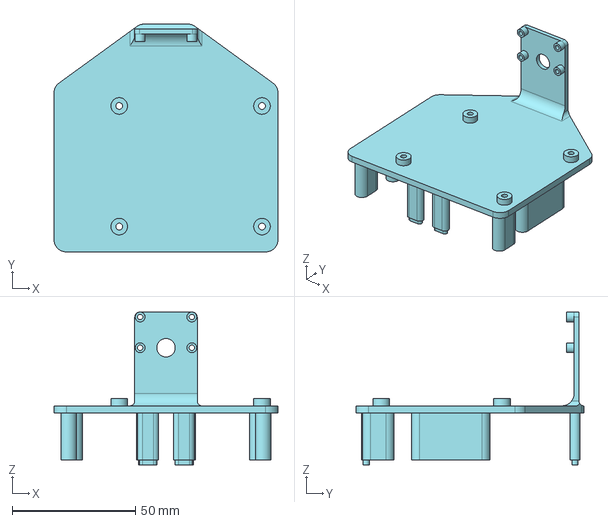
[picture p79: CAD file, 2022-12-21]
Rover/Mechanical/Frame/Pi_tray.stp
91.0 x 92.6 x 62.1 mm
