uccross/open-source-autonomous-vehicle-controller/Rover/Mechanical/Frame/Wheel/wheel_rin.SLDPRT

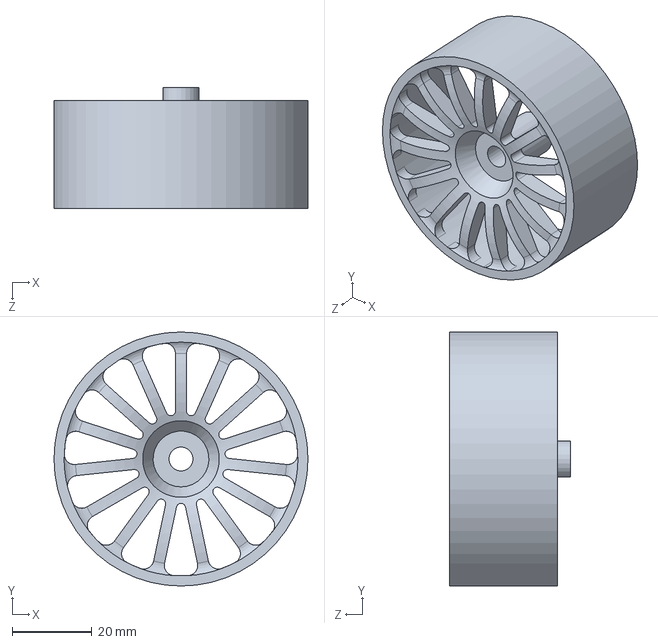
[picture p80: CAD file, 2022-12-21]
Rover/Mechanical/Frame/Wheel/wheel_rin.SLDPRT
63.5 x 63.5 x 30.2 mm
