uccross/open-source-autonomous-vehicle-controller/Rover/Mechanical/Hybrid_sensor/Hybrid_sensor_Rover_mount.SLDPRT

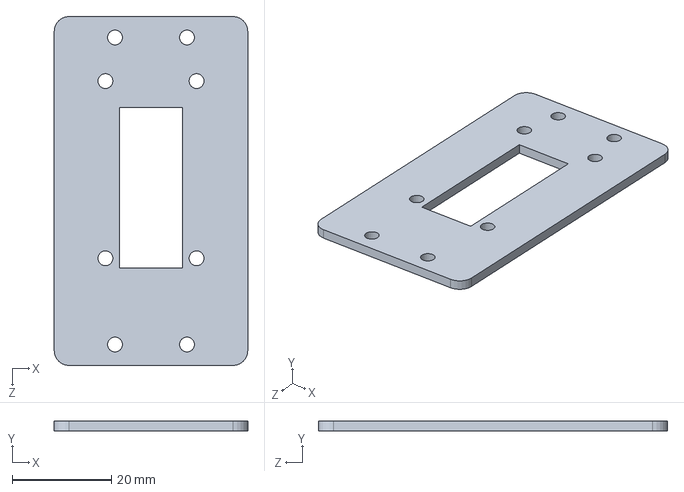
[picture p81: CAD file, 2022-12-21]
Rover/Mechanical/Hybrid_sensor/Hybrid_sensor_Rover_mount.SLDPRT
39.0 x 2.00 x 70.3 mm
