uccross/open-source-autonomous-vehicle-controller/Self-balancing_bot/Mechanical/BLDC_A2212_13T_1000KV_MountPlate.SLDPRT

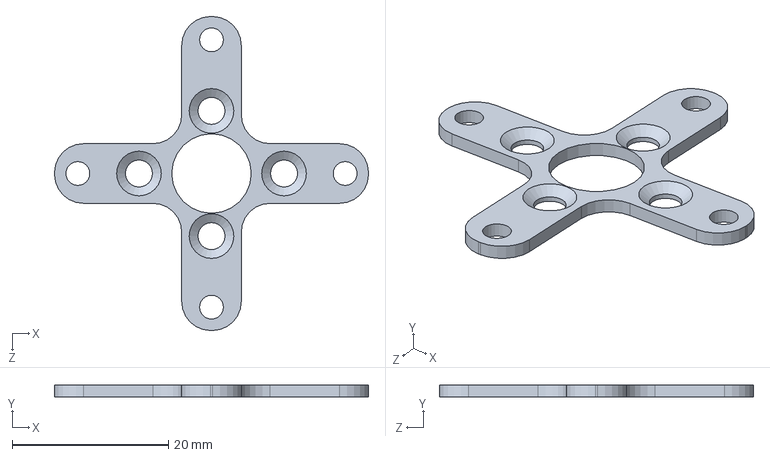
[picture p82: CAD file, 2023-08-13]
Self-balancing_bot/Mechanical/BLDC_A2212_13T_1000KV_MountPlate.SLDPRT
40.1 x 1.47 x 40.1 mm
