uccross/open-source-autonomous-vehicle-controller/Quadcopter/Mechanical/3D_Printable/Mount_Lidar_V1_fixture.sldprt

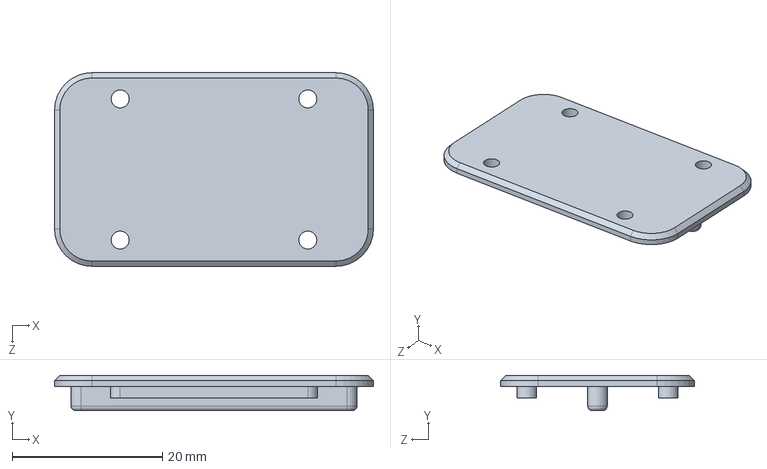
[picture p83: CAD file, 2022-08-05]
Quadcopter/Mechanical/3D_Printable/Mount_Lidar_V1_fixture.sldprt
42.5 x 4.70 x 25.8 mm
