uccross/open-source-autonomous-vehicle-controller/Quadcopter/Mechanical/Frame/DJI_Flame_Wheel_F450_Arm.SLDPRT

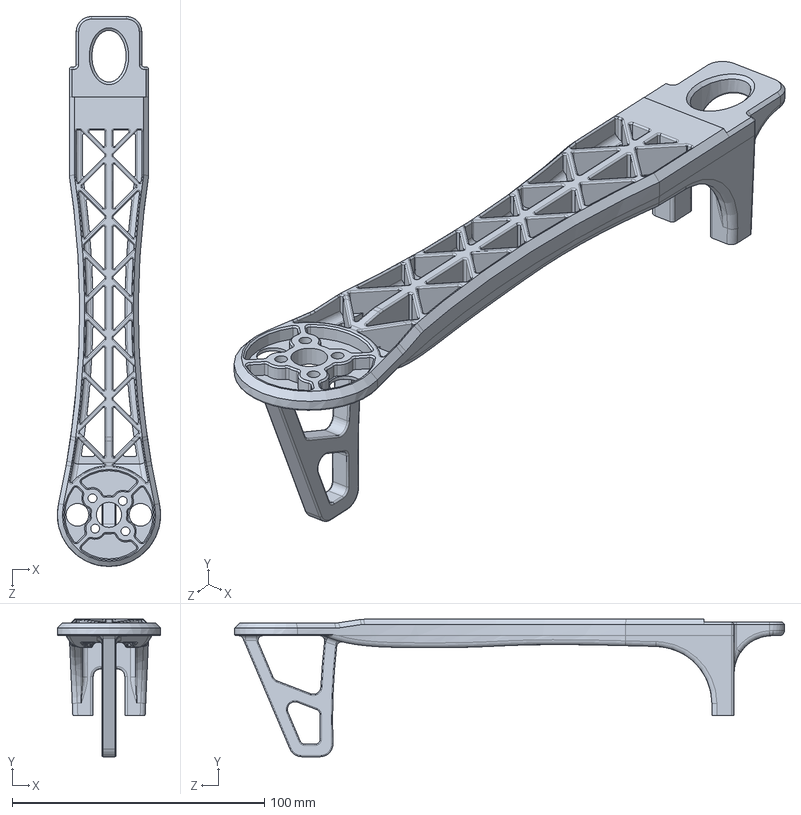
[picture p84: CAD file, 2022-08-05]
Quadcopter/Mechanical/Frame/DJI_Flame_Wheel_F450_Arm.SLDPRT
41.0 x 54.5 x 218.0 mm
