uccross/open-source-autonomous-vehicle-controller/Quadcopter/Mechanical/Motor/BLDC_A2212_13T_1000KV.SLDPRT

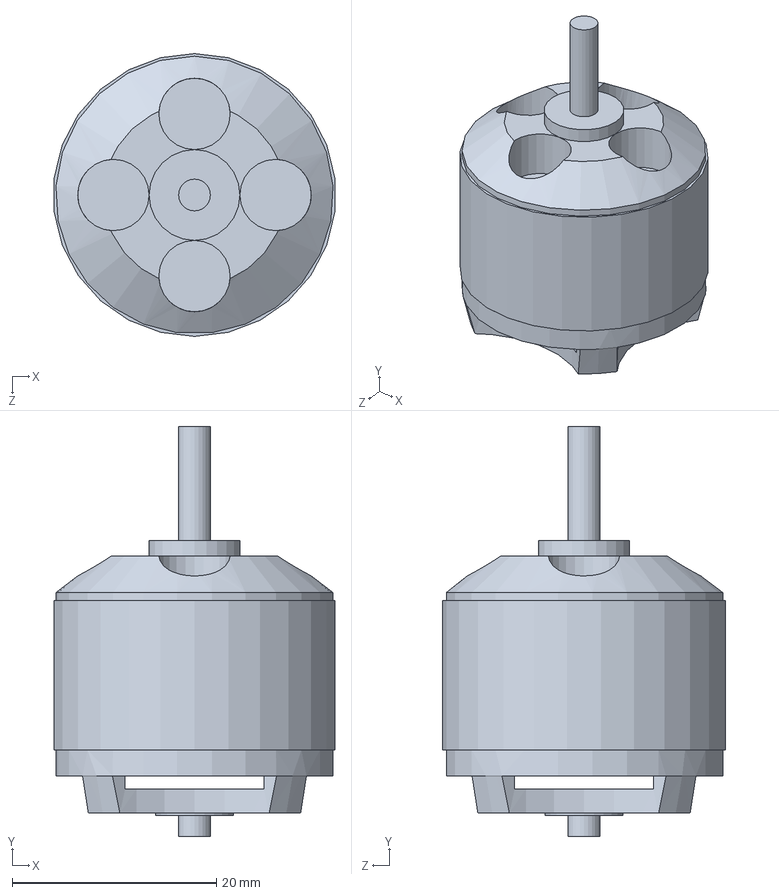
[picture p85: CAD file, 2022-08-05]
Quadcopter/Mechanical/Motor/BLDC_A2212_13T_1000KV.SLDPRT
27.5 x 40.1 x 27.7 mm
