uccross/open-source-autonomous-vehicle-controller/Rover/Mechanical/3D_Print/Mount_Hybrid_sensor.STEP

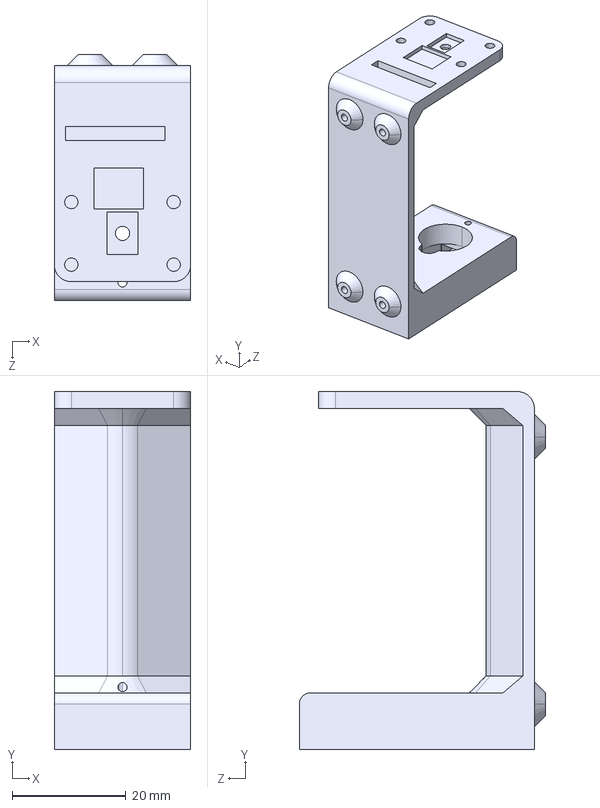
[picture p86: CAD file, 2022-12-21]
Rover/Mechanical/3D_Print/Mount_Hybrid_sensor.STEP
24.0 x 63.0 x 43.4 mm
