uccross/open-source-autonomous-vehicle-controller/Rover/Mechanical/Frame/MG996R SERVO/Servo MG996R Shaft.SLDPRT

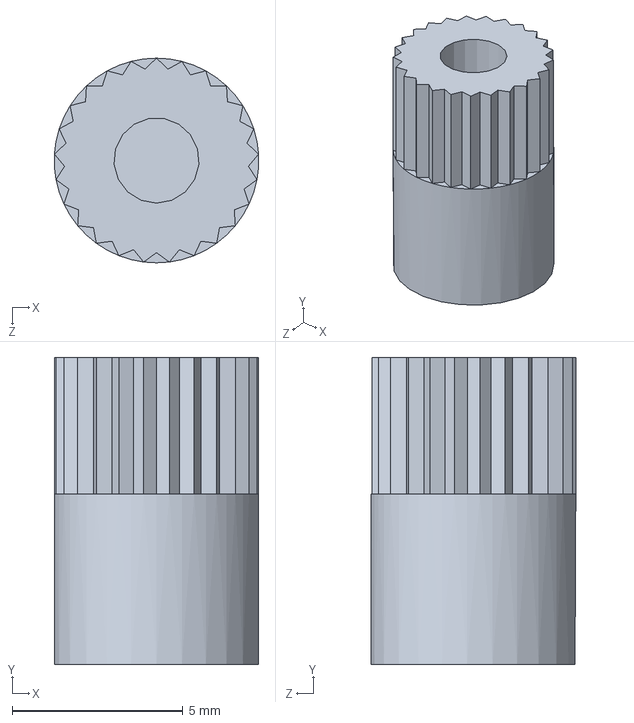
[picture p87: CAD file, 2022-12-21]
Rover/Mechanical/Frame/MG996R SERVO/Servo MG996R Shaft.SLDPRT
5.99 x 9.00 x 6.00 mm
