uccross/open-source-autonomous-vehicle-controller/Self-balancing_bot/Mechanical/Top_plate_electronics.SLDPRT

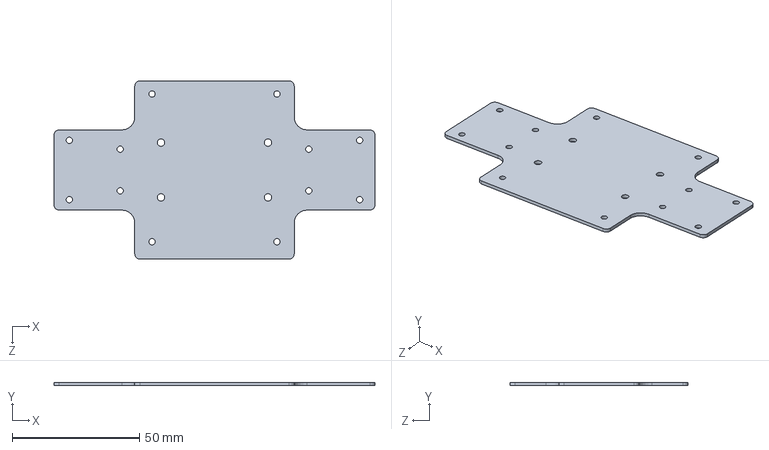
[picture p88: CAD file, 2023-08-13]
Self-balancing_bot/Mechanical/Top_plate_electronics.SLDPRT
126.0 x 1.35 x 69.9 mm
