uccross/open-source-autonomous-vehicle-controller/Quadcopter/Mechanical/3D_Printable/Mount_GPS.sldprt

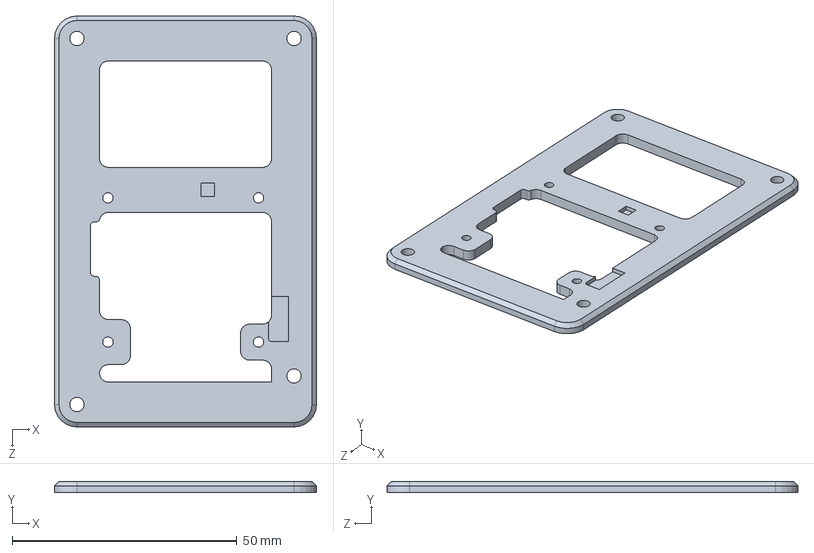
[picture p89: CAD file, 2022-08-05]
Quadcopter/Mechanical/3D_Printable/Mount_GPS.sldprt
58.2 x 2.50 x 91.3 mm
