uccross/open-source-autonomous-vehicle-controller/Quadcopter/Mechanical/Frame/DJI_Flame_Wheel_F450_High_Landing_Gear.SLDPRT

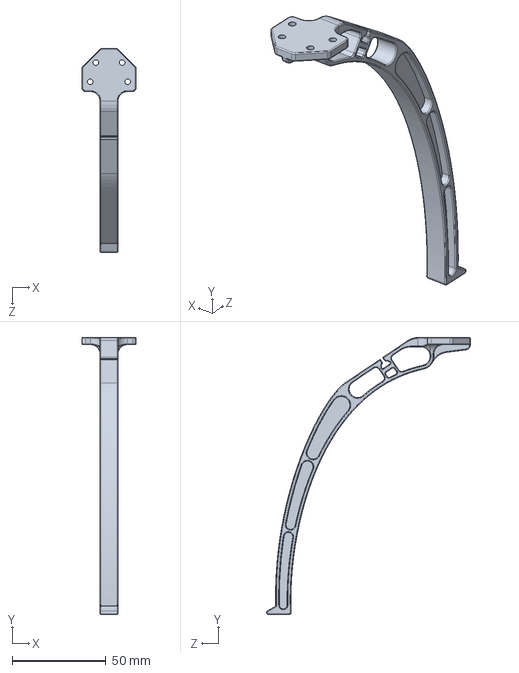
[picture p90: CAD file, 2022-08-05]
Quadcopter/Mechanical/Frame/DJI_Flame_Wheel_F450_High_Landing_Gear.SLDPRT
29.0 x 148.0 x 109.0 mm
