uccross/open-source-autonomous-vehicle-controller/Quadcopter/Mechanical/Motor/BLDC_A2212_13T_1000KV_PropCollar.SLDPRT

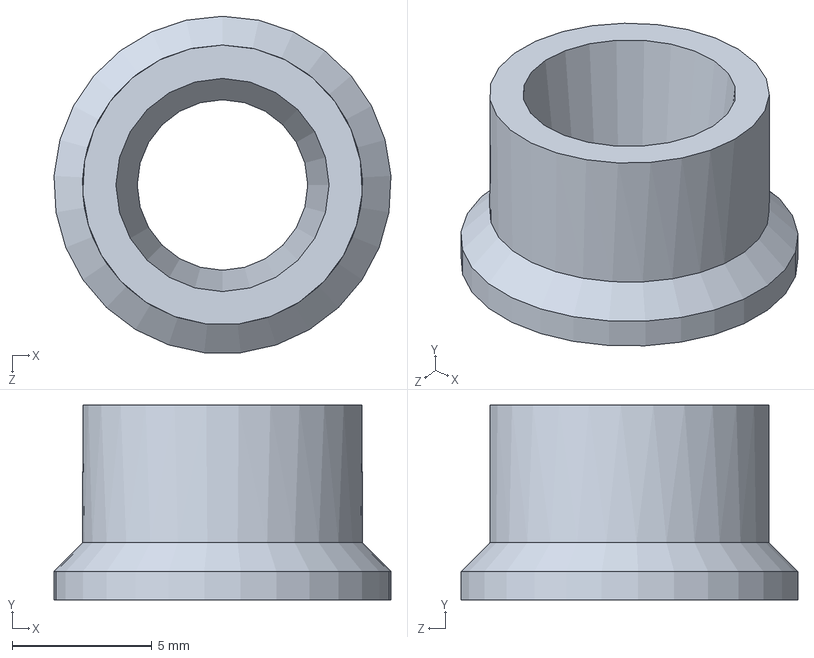
[picture p91: CAD file, 2022-08-05]
Quadcopter/Mechanical/Motor/BLDC_A2212_13T_1000KV_PropCollar.SLDPRT
12.0 x 6.96 x 12.0 mm
