uccross/open-source-autonomous-vehicle-controller/Rover/Mechanical/Frame/Hex_standoff_75mm.SLDPRT

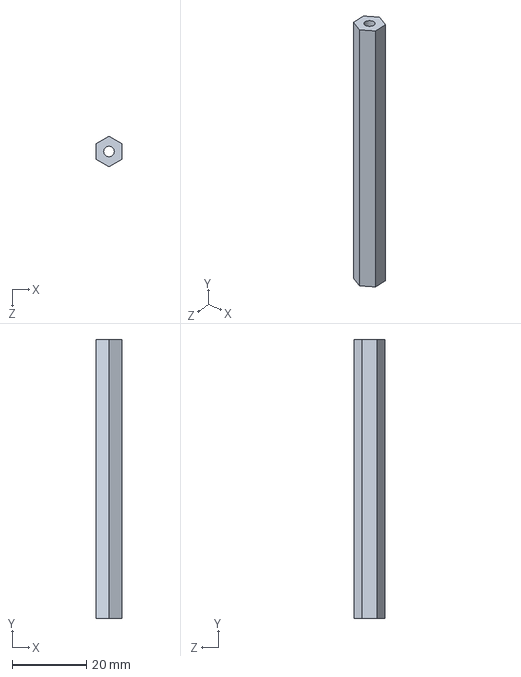
[picture p92: CAD file, 2022-12-21]
Rover/Mechanical/Frame/Hex_standoff_75mm.SLDPRT
7.11 x 75.0 x 8.21 mm
