uccross/open-source-autonomous-vehicle-controller/Rover/Mechanical/Hybrid_sensor/Arducam B0332.stp

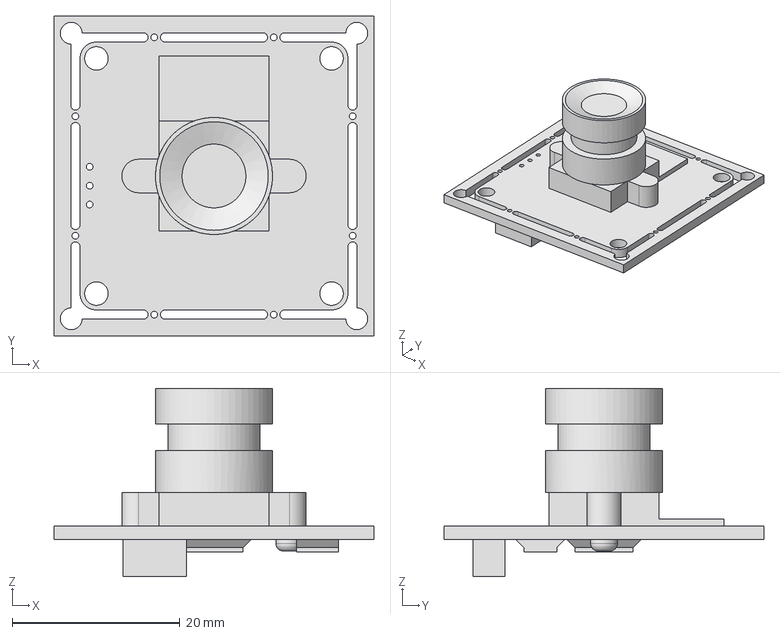
[picture p93: CAD file, 2022-12-21]
Rover/Mechanical/Hybrid_sensor/Arducam B0332.stp
38.1 x 38.1 x 22.4 mm
