uccross/open-source-autonomous-vehicle-controller/Self-balancing_bot/Mechanical/Bearing_holder_front.SLDPRT

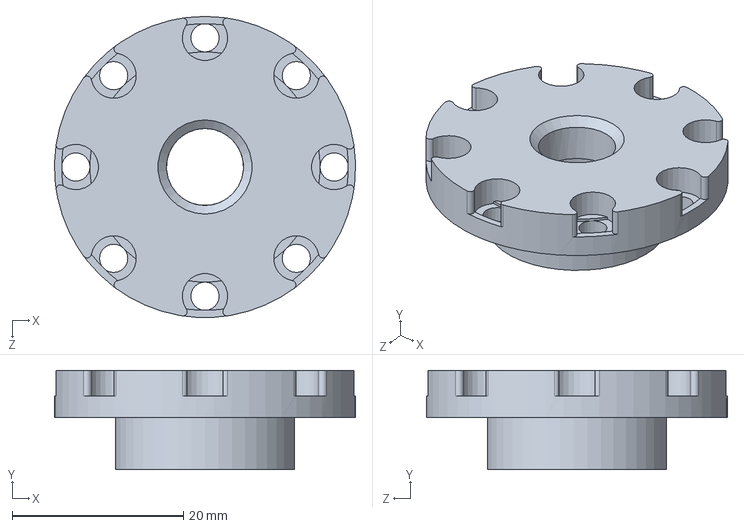
[picture p94: CAD file, 2023-08-13]
Self-balancing_bot/Mechanical/Bearing_holder_front.SLDPRT
35.2 x 11.6 x 35.2 mm
