uccross/open-source-autonomous-vehicle-controller/Quadcopter/Mechanical/3D_Printable/Mount_autopilot_fixture.sldprt

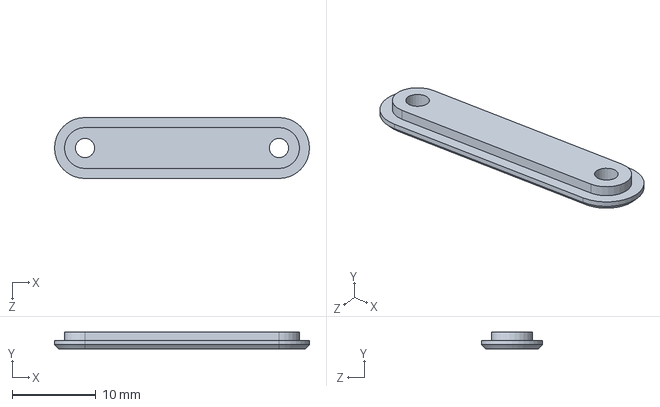
[picture p95: CAD file, 2022-08-05]
Quadcopter/Mechanical/3D_Printable/Mount_autopilot_fixture.sldprt
30.5 x 2.00 x 7.30 mm
