uccross/open-source-autonomous-vehicle-controller/Quadcopter/Mechanical/Motor/BLDC_A2212_13T_1000KV_PropNut.SLDPRT

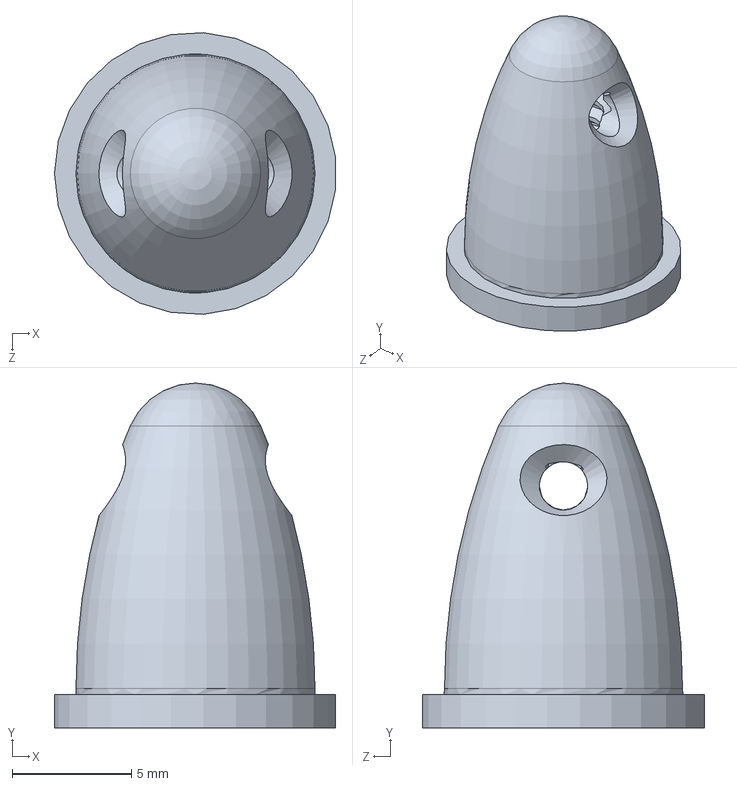
[picture p96: CAD file, 2022-08-05]
Quadcopter/Mechanical/Motor/BLDC_A2212_13T_1000KV_PropNut.SLDPRT
11.8 x 14.5 x 11.8 mm
