uccross/open-source-autonomous-vehicle-controller/Quadcopter/Mechanical/Stabilization_test/Stabilization_test_platform_T-joint_a.SLDPRT

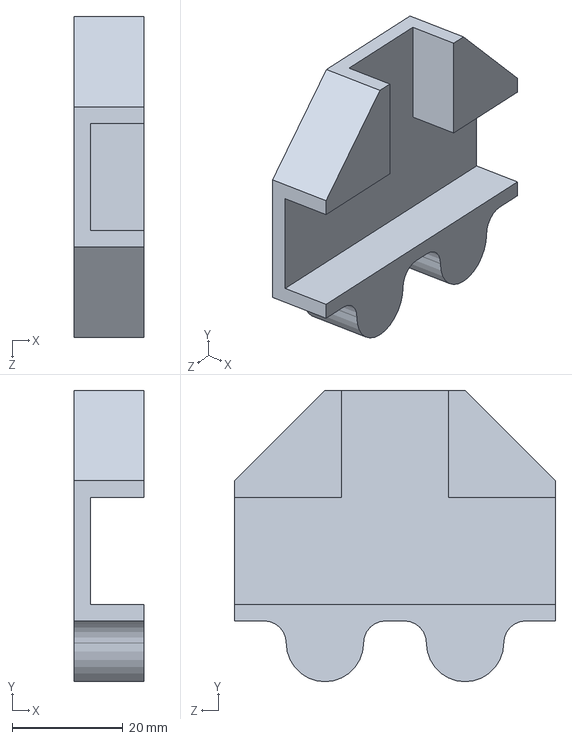
[picture p97: CAD file, 2022-12-21]
Quadcopter/Mechanical/Stabilization_test/Stabilization_test_platform_T-joint_a.SLDPRT
12.7 x 52.7 x 58.0 mm
