uccross/open-source-autonomous-vehicle-controller/Rover/Mechanical/Frame/sensor_shelf.stp

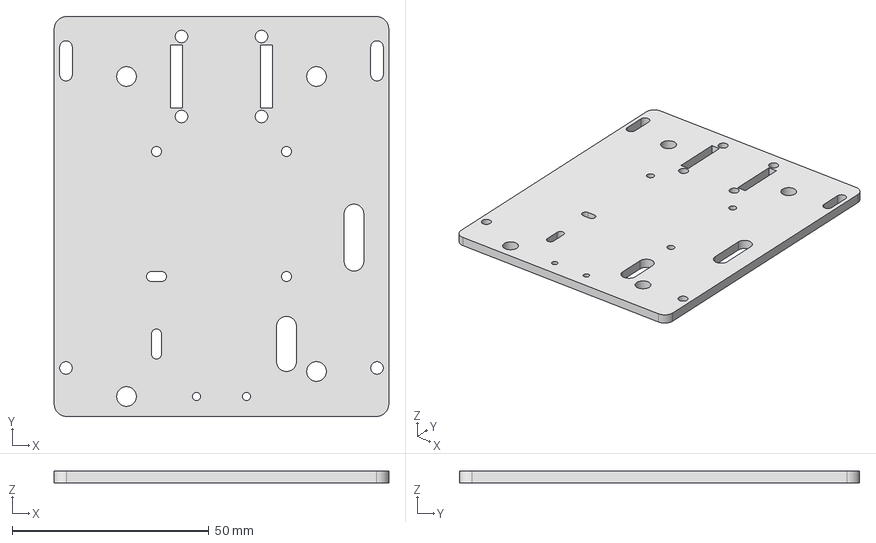
[picture p98: CAD file, 2022-12-21]
Rover/Mechanical/Frame/sensor_shelf.stp
85.0 x 101.6 x 3.00 mm
