uccross/open-source-autonomous-vehicle-controller/Quadcopter/Mechanical/3D_Printable/Mount_Lidar_V1_base.sldprt

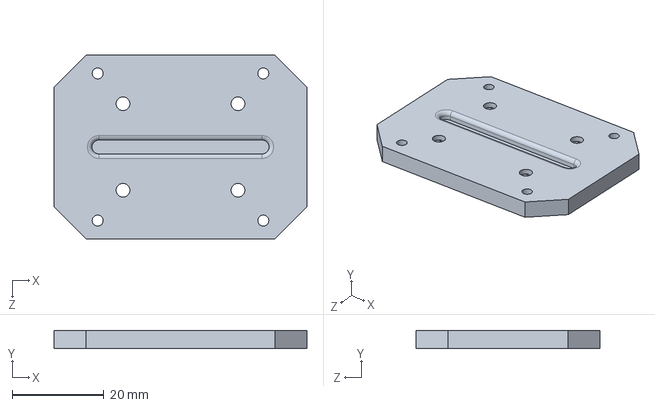
[picture p99: CAD file, 2022-08-05]
Quadcopter/Mechanical/3D_Printable/Mount_Lidar_V1_base.sldprt
55.0 x 4.00 x 40.0 mm
