uccross/open-source-autonomous-vehicle-controller/Rover/Mechanical/Frame/Chassis_upper.stp

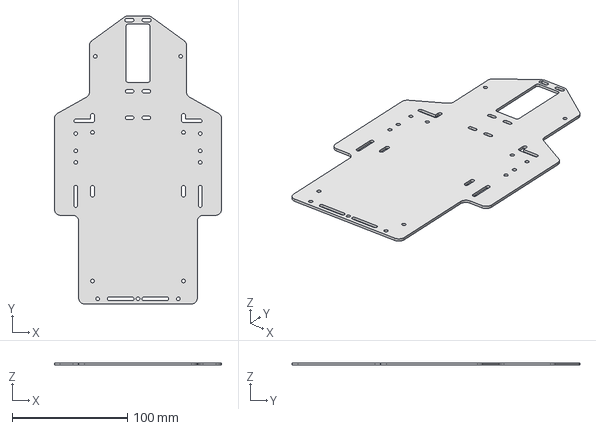
[picture p100: CAD file, 2022-12-21]
Rover/Mechanical/Frame/Chassis_upper.stp
145.0 x 250.0 x 2.00 mm
