uccross/open-source-autonomous-vehicle-controller/Rover/Mechanical/Hybrid_sensor/RaspberryPi_Pico.SLDPRT

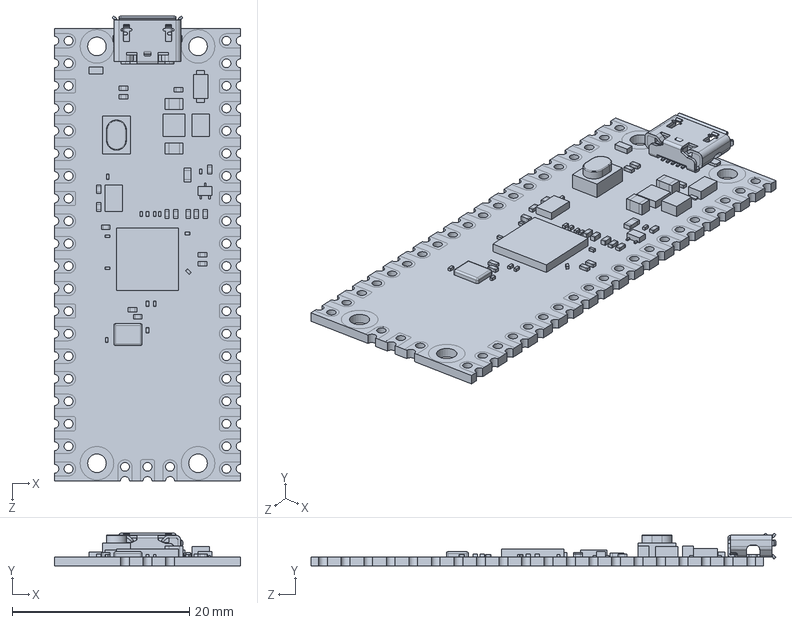
[picture p101: CAD file, 2022-12-21]
Rover/Mechanical/Hybrid_sensor/RaspberryPi_Pico.SLDPRT
21.0 x 3.69 x 52.4 mm
