uccross/open-source-autonomous-vehicle-controller/Self-balancing_bot/Mechanical/Bottom_plate.SLDPRT

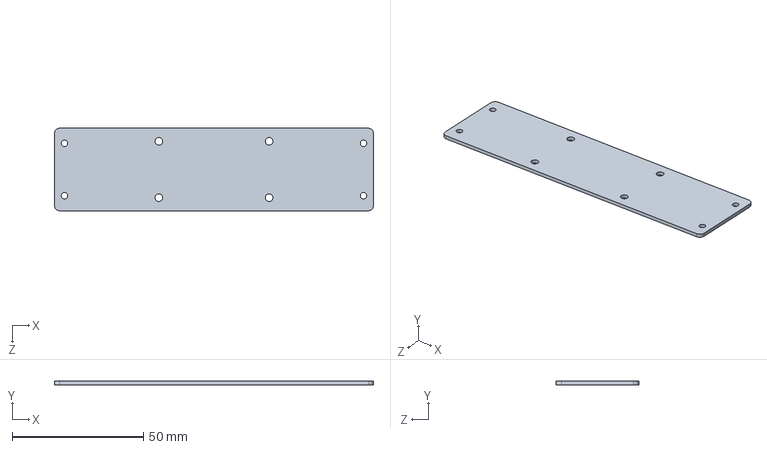
[picture p102: CAD file, 2023-08-13]
Self-balancing_bot/Mechanical/Bottom_plate.SLDPRT
121.6 x 1.35 x 31.5 mm
