uccross/open-source-autonomous-vehicle-controller/Quadcopter/Mechanical/3D_Printable/Mount_FrSky_R-XSR_Tiny_16.sldprt

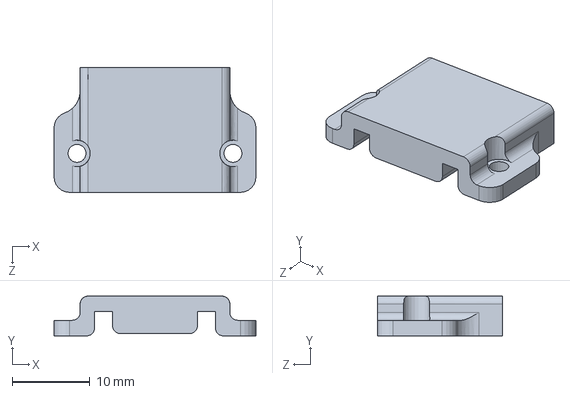
[picture p103: CAD file, 2022-08-05]
Quadcopter/Mechanical/3D_Printable/Mount_FrSky_R-XSR_Tiny_16.sldprt
25.9 x 5.10 x 16.0 mm
