uccross/open-source-autonomous-vehicle-controller/Rover/Mechanical/Frame/Standoff_15mm.SLDPRT

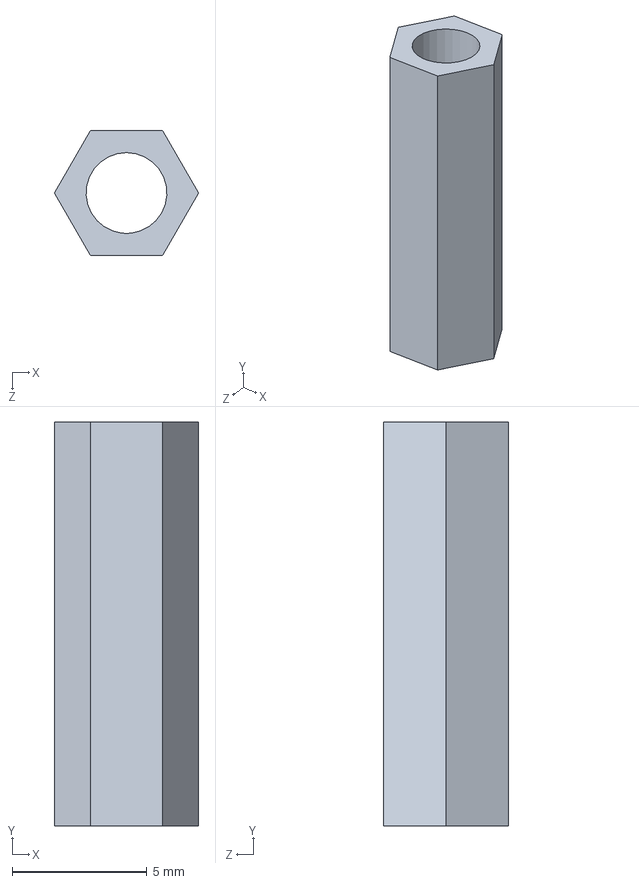
[picture p104: CAD file, 2022-12-21]
Rover/Mechanical/Frame/Standoff_15mm.SLDPRT
5.36 x 15.0 x 4.64 mm
