uccross/open-source-autonomous-vehicle-controller/Rover/Mechanical/Hybrid_sensor/Board_AS5047D.SLDPRT

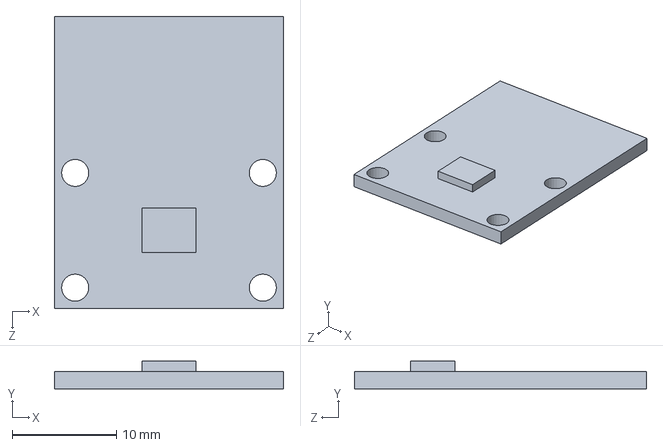
[picture p105: CAD file, 2022-12-21]
Rover/Mechanical/Hybrid_sensor/Board_AS5047D.SLDPRT
22.0 x 2.66 x 28.0 mm
