uccross/open-source-autonomous-vehicle-controller/Self-balancing_bot/Mechanical/00_Lasercut_MDF.DXF

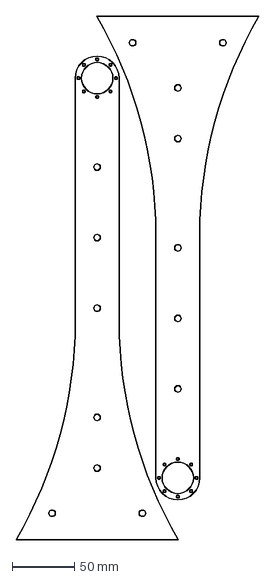
[picture p106: CAD file, 2023-08-13]
Self-balancing_bot/Mechanical/00_Lasercut_MDF.DXF
194.6 x 419.5 mm
