uccross/open-source-autonomous-vehicle-controller/Quadcopter/Mechanical/3D_Printable/Mount_Max32.sldprt

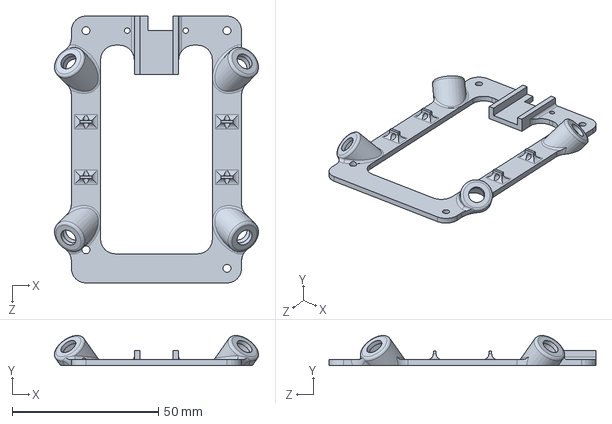
[picture p107: CAD file, 2022-08-05]
Quadcopter/Mechanical/3D_Printable/Mount_Max32.sldprt
69.8 x 10.3 x 91.3 mm
