uccross/open-source-autonomous-vehicle-controller/Rover/Mechanical/Frame/micro_holder.stp

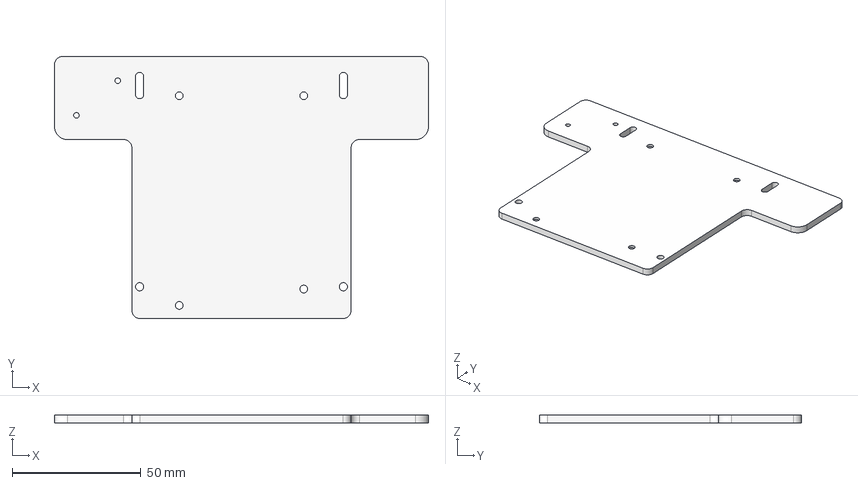
[picture p108: CAD file, 2022-12-21]
Rover/Mechanical/Frame/micro_holder.stp
145.0 x 101.6 x 3.00 mm
