uccross/open-source-autonomous-vehicle-controller/Rover/Mechanical/Frame/gps_shelf_leg.stp

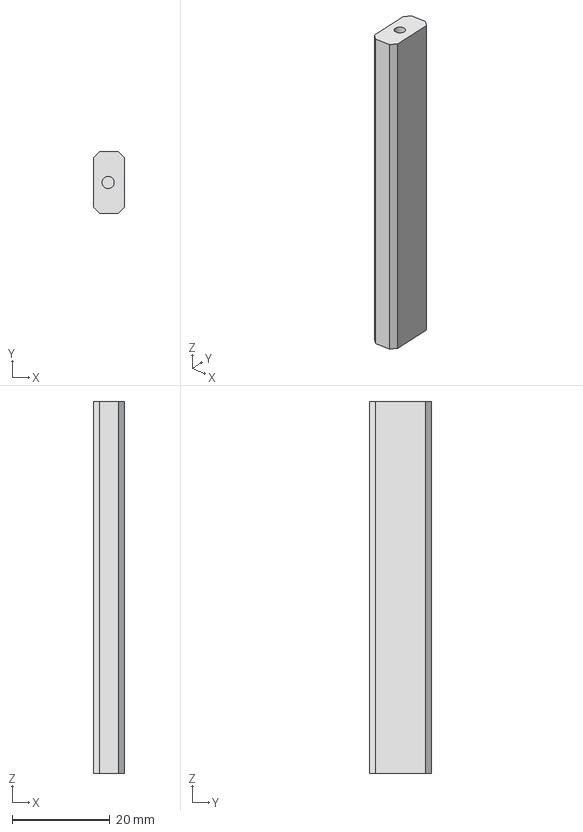
[picture p109: CAD file, 2022-12-21]
Rover/Mechanical/Frame/gps_shelf_leg.stp
6.35 x 12.7 x 76.2 mm
