uccross/open-source-autonomous-vehicle-controller/Self-balancing_bot/Mechanical/Hex_stand_20mm.SLDPRT

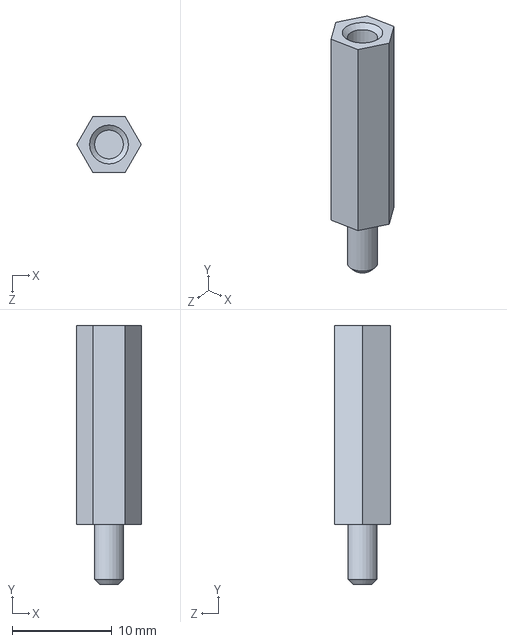
[picture p110: CAD file, 2023-08-13]
Self-balancing_bot/Mechanical/Hex_stand_20mm.SLDPRT
6.49 x 26.0 x 5.62 mm
