uccross/open-source-autonomous-vehicle-controller/Rover/Mechanical/Hybrid_sensor/Tower-Pro-MG90S.SLDPRT

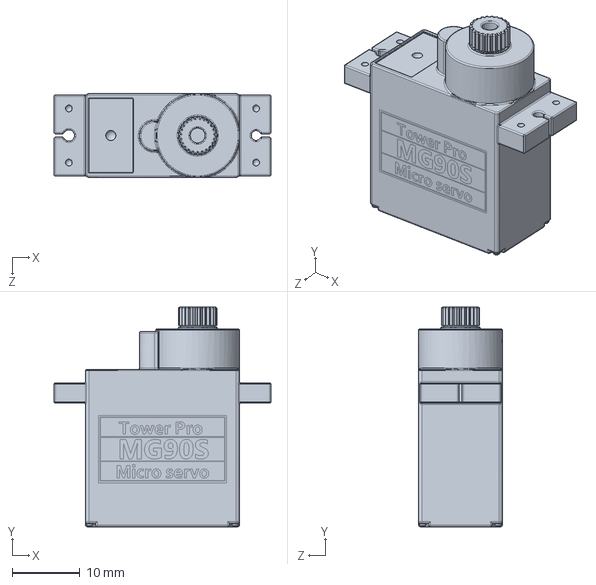
[picture p111: CAD file, 2022-12-21]
Rover/Mechanical/Hybrid_sensor/Tower-Pro-MG90S.SLDPRT
32.1 x 32.5 x 12.4 mm
