uccross/open-source-autonomous-vehicle-controller/Self-balancing_bot/Mechanical/Mount_control_stack.SLDPRT

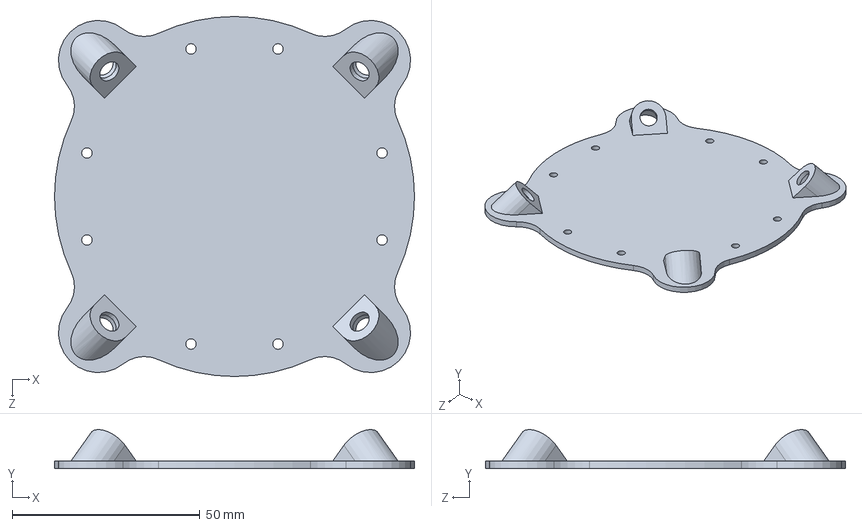
[picture p112: CAD file, 2023-08-13]
Self-balancing_bot/Mechanical/Mount_control_stack.SLDPRT
96.0 x 10.4 x 96.0 mm
