uccross/open-source-autonomous-vehicle-controller/Rover/Mechanical/Hybrid_sensor/LIDAR-Lite_V3HP_Garmin.SLDPRT

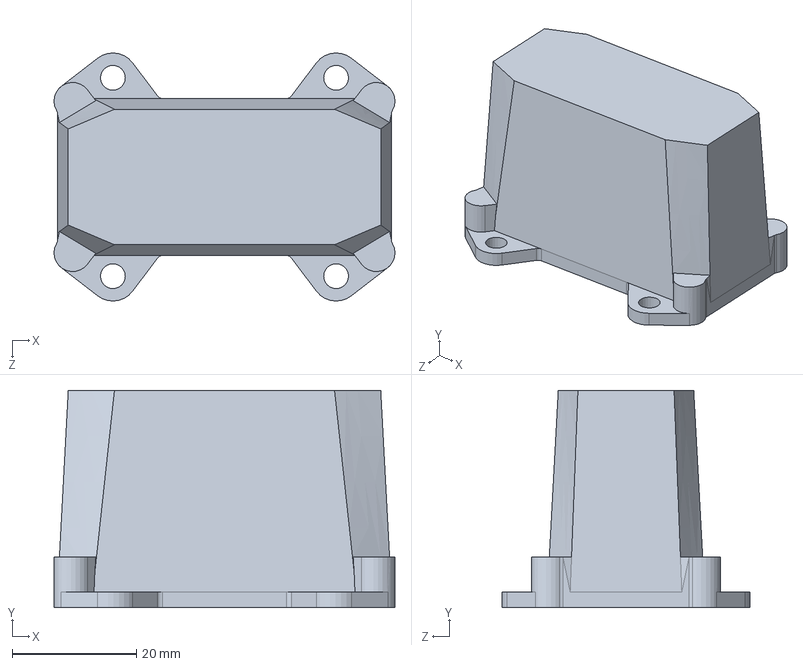
[picture p113: CAD file, 2022-12-21]
Rover/Mechanical/Hybrid_sensor/LIDAR-Lite_V3HP_Garmin.SLDPRT
55.0 x 35.0 x 40.0 mm
