uccross/open-source-autonomous-vehicle-controller/Self-balancing_bot/Mechanical/01_Lasercut_MDF.DXF

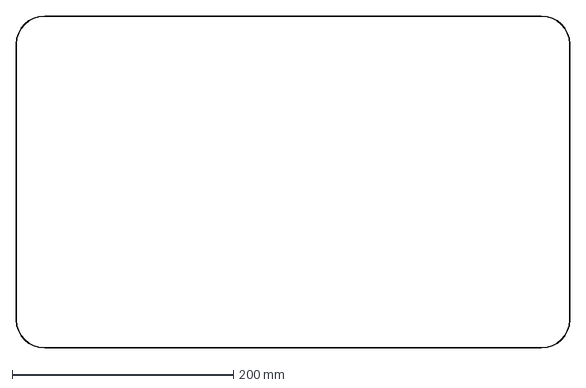
[picture p114: CAD file, 2023-08-13]
Self-balancing_bot/Mechanical/01_Lasercut_MDF.DXF
500.0 x 300.0 mm
