uccross/open-source-autonomous-vehicle-controller/Self-balancing_bot/Mechanical/M2.5_hex_stand_20mm_f-f.SLDPRT

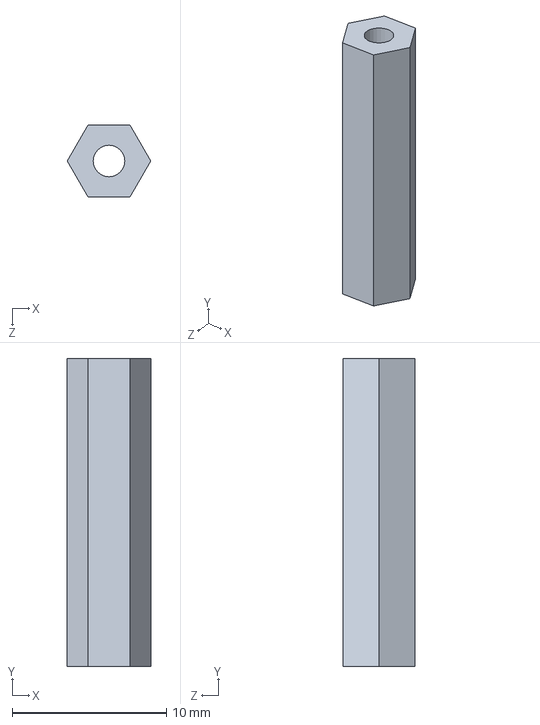
[picture p115: CAD file, 2023-08-13]
Self-balancing_bot/Mechanical/M2.5_hex_stand_20mm_f-f.SLDPRT
5.43 x 20.0 x 4.70 mm
