uccross/open-source-autonomous-vehicle-controller/Rover/Mechanical/Hybrid_sensor/Mount_Lidar-Servo.SLDPRT

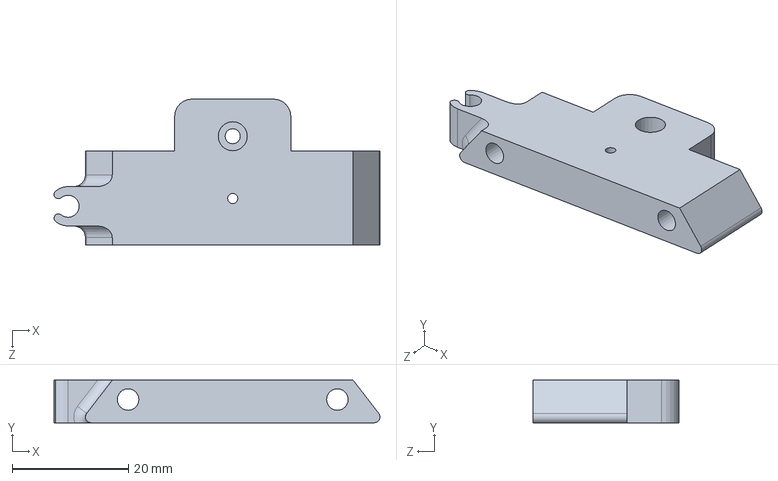
[picture p116: CAD file, 2022-12-21]
Rover/Mechanical/Hybrid_sensor/Mount_Lidar-Servo.SLDPRT
56.1 x 7.32 x 25.1 mm
