uccross/open-source-autonomous-vehicle-controller/Self-balancing_bot/Mechanical/Magnet_holder.SLDPRT

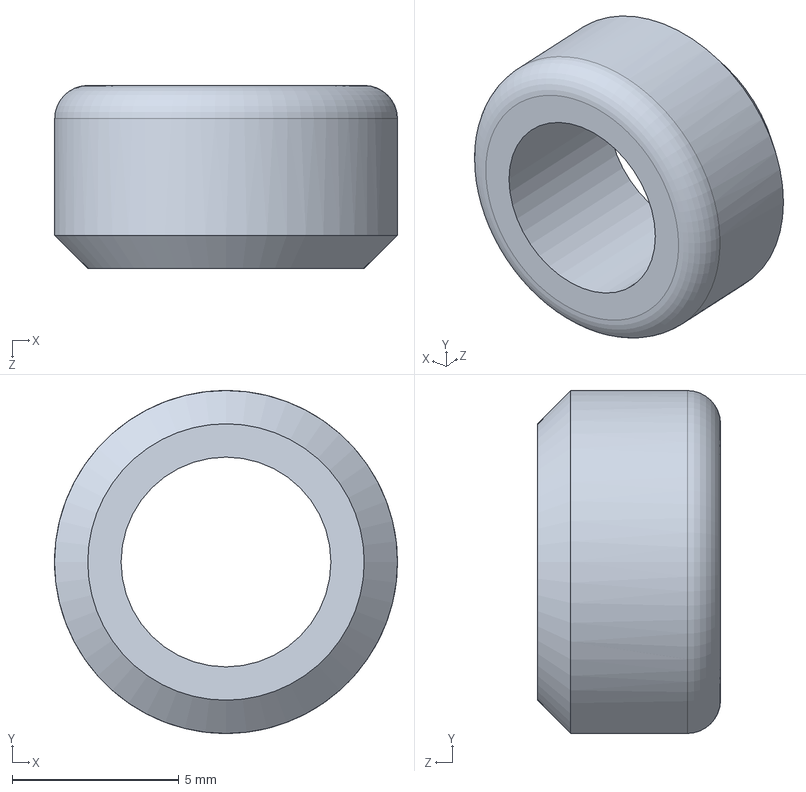
[picture p117: CAD file, 2023-08-13]
Self-balancing_bot/Mechanical/Magnet_holder.SLDPRT
10.3 x 10.3 x 5.50 mm
