uccross/open-source-autonomous-vehicle-controller/Rover/Mechanical/Hybrid_sensor/Servo_lever.SLDPRT

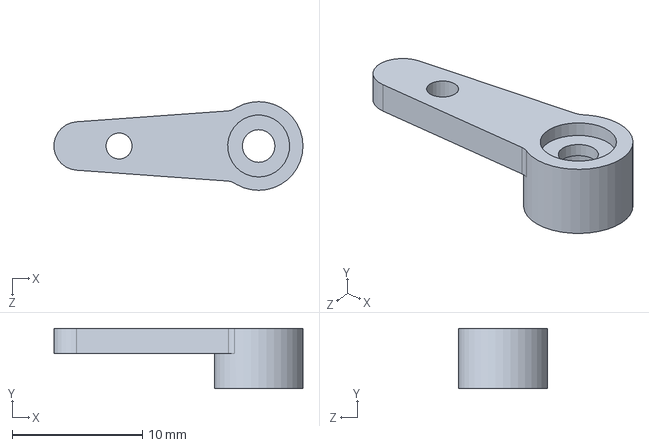
[picture p118: CAD file, 2022-12-21]
Rover/Mechanical/Hybrid_sensor/Servo_lever.SLDPRT
19.1 x 4.60 x 6.80 mm
