uccross/open-source-autonomous-vehicle-controller/Self-balancing_bot/Mechanical/Hex_stand_6mm.SLDPRT

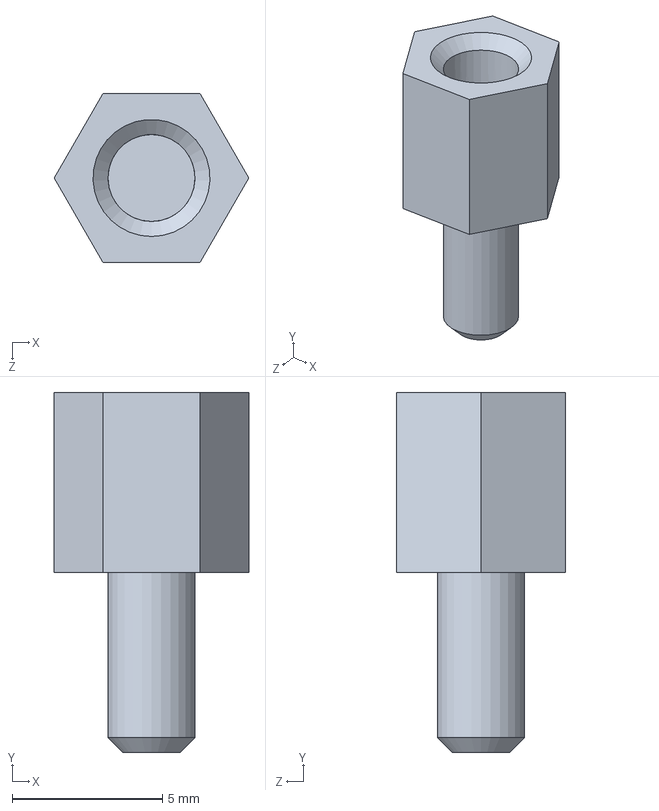
[picture p119: CAD file, 2023-08-13]
Self-balancing_bot/Mechanical/Hex_stand_6mm.SLDPRT
6.49 x 12.0 x 5.62 mm
