uccross/open-source-autonomous-vehicle-controller/Self-balancing_bot/Mechanical/M2.5_hex_stand_6mm.SLDPRT

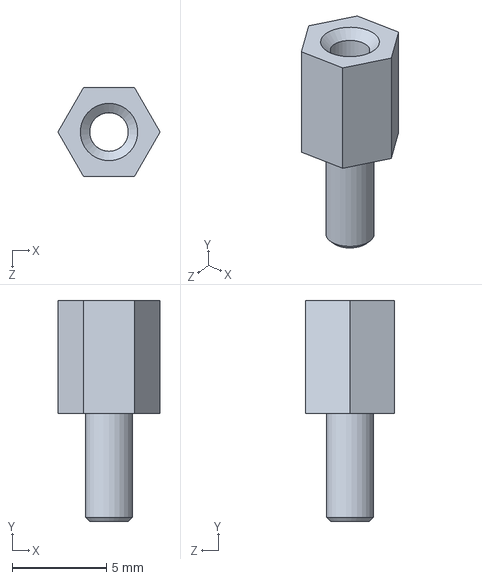
[picture p120: CAD file, 2023-08-13]
Self-balancing_bot/Mechanical/M2.5_hex_stand_6mm.SLDPRT
5.43 x 11.7 x 4.70 mm
