uccross/open-source-autonomous-vehicle-controller/Self-balancing_bot/Mechanical/Stack_plate_osavc_pi.SLDPRT

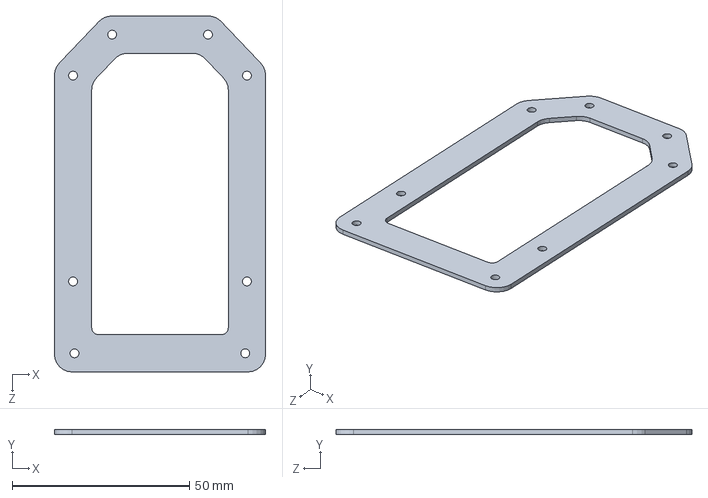
[picture p121: CAD file, 2023-08-13]
Self-balancing_bot/Mechanical/Stack_plate_osavc_pi.SLDPRT
59.5 x 1.35 x 100.3 mm
