uccross/open-source-autonomous-vehicle-controller/Self-balancing_bot/Mechanical/Stack_plate_osavc_coral.SLDPRT

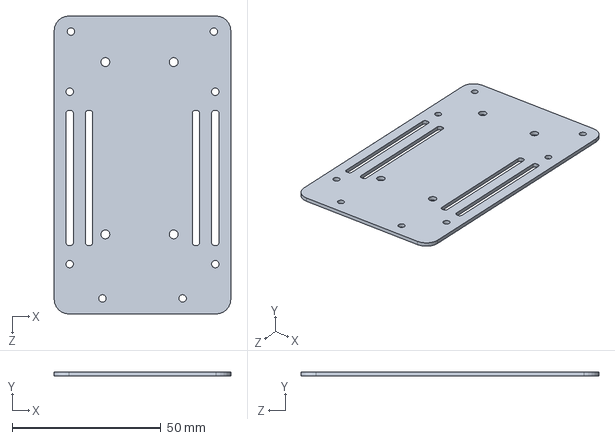
[picture p122: CAD file, 2023-08-13]
Self-balancing_bot/Mechanical/Stack_plate_osavc_coral.SLDPRT
59.5 x 1.35 x 100.3 mm
