uccross/open-source-autonomous-vehicle-controller/Self-balancing_bot/Mechanical/Lasercut_acrylic_.DXF

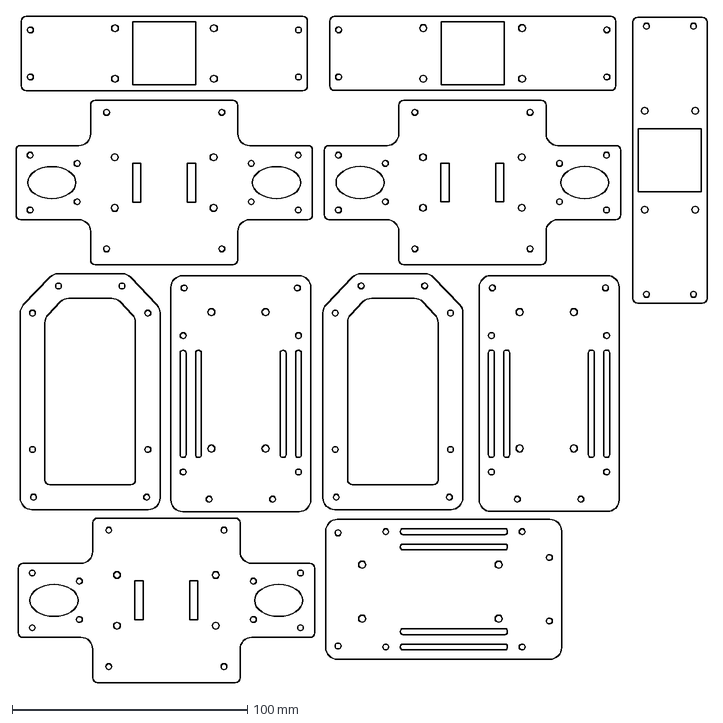
[picture p123: CAD file, 2023-08-13]
Self-balancing_bot/Mechanical/Lasercut_acrylic_.DXF
293.8 x 283.2 mm
