uccross/open-source-autonomous-vehicle-controller/Self-balancing_bot/Mechanical/Bearing_holder_back.SLDPRT

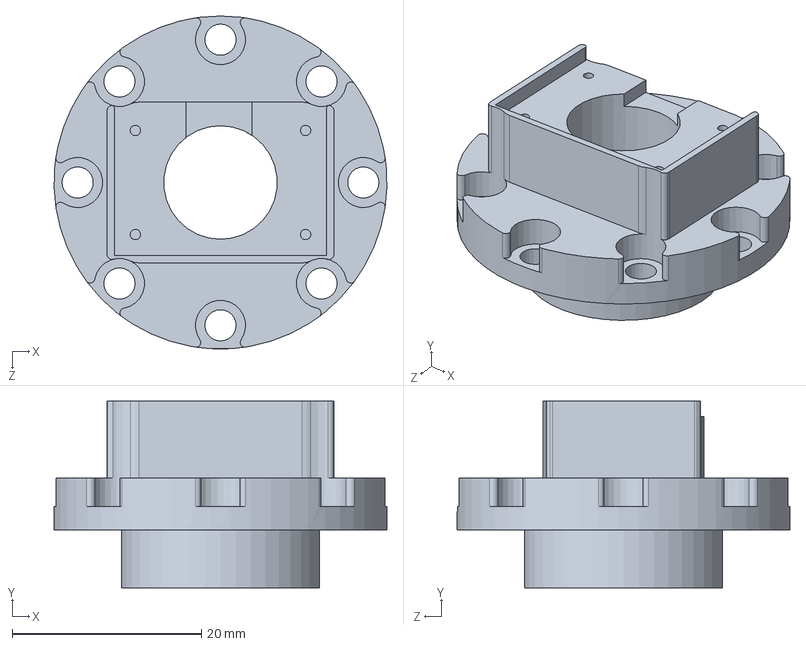
[picture p124: CAD file, 2023-08-13]
Self-balancing_bot/Mechanical/Bearing_holder_back.SLDPRT
35.2 x 19.8 x 35.2 mm
