uccross/open-source-autonomous-vehicle-controller/Self-balancing_bot/Mechanical/Middle_support.SLDPRT

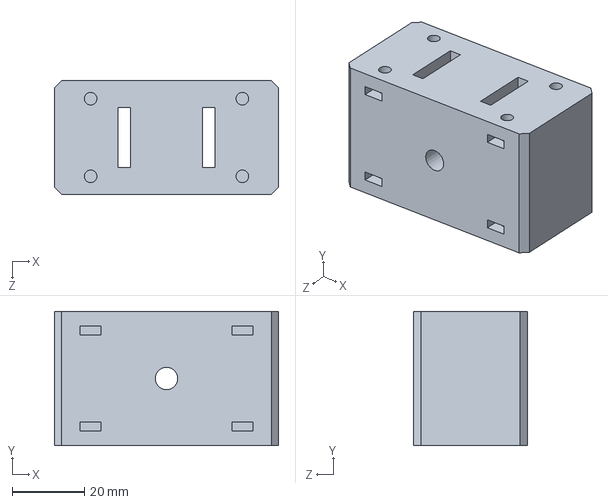
[picture p125: CAD file, 2023-08-13]
Self-balancing_bot/Mechanical/Middle_support.SLDPRT
62.0 x 37.2 x 31.5 mm
