uccross/open-source-autonomous-vehicle-controller/Self-balancing_bot/Mechanical/Axis_bar.SLDPRT

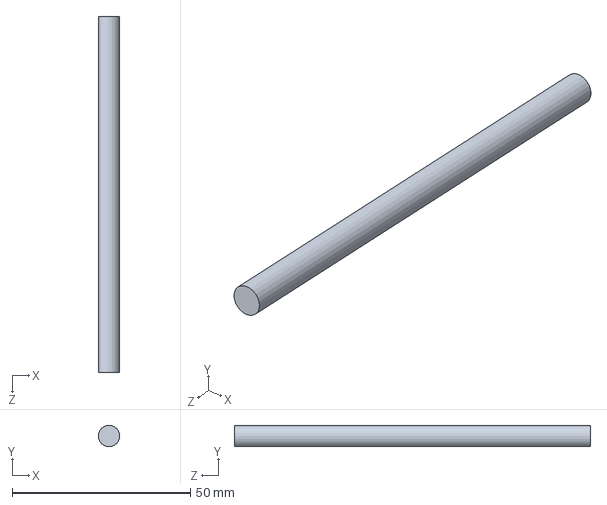
[picture p126: CAD file, 2023-08-13]
Self-balancing_bot/Mechanical/Axis_bar.SLDPRT
6.00 x 6.00 x 100.0 mm
