uccross/open-source-autonomous-vehicle-controller/Self-balancing_bot/Mechanical/M2.5_hex_stand_20mm.SLDPRT

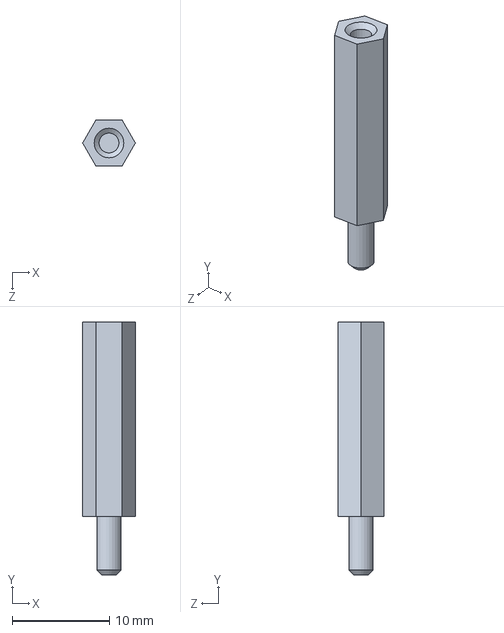
[picture p127: CAD file, 2023-08-13]
Self-balancing_bot/Mechanical/M2.5_hex_stand_20mm.SLDPRT
5.43 x 26.0 x 4.70 mm
