uccross/open-source-autonomous-vehicle-controller/Self-balancing_bot/Mechanical/M2.5_hex_stand_6mm_f-f.SLDPRT

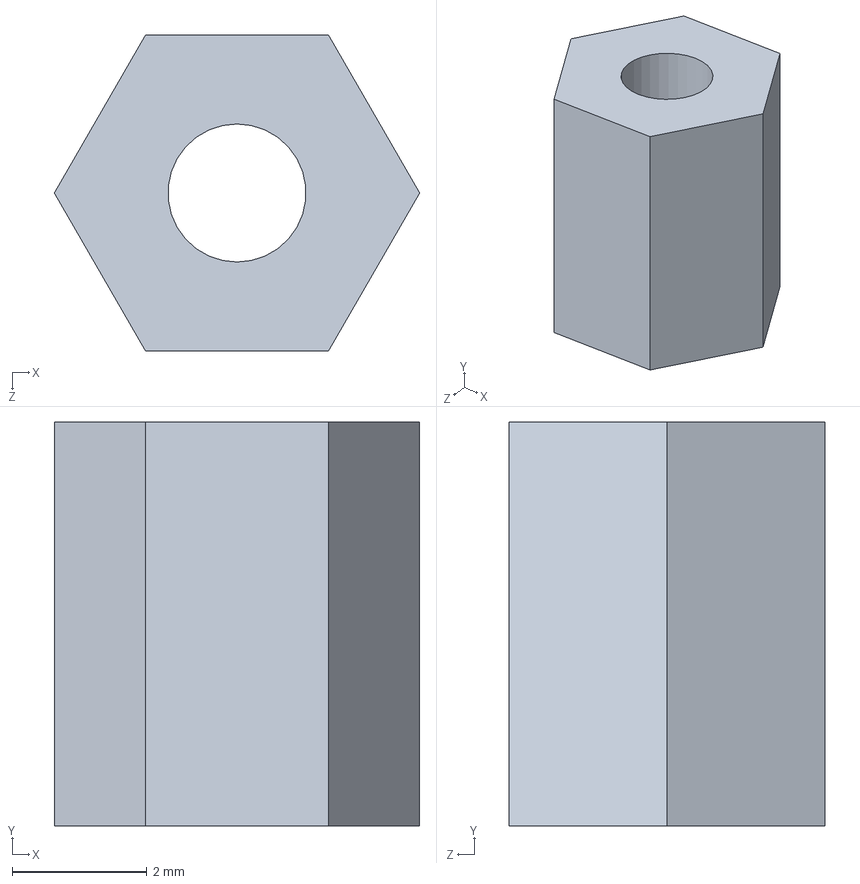
[picture p128: CAD file, 2023-08-13]
Self-balancing_bot/Mechanical/M2.5_hex_stand_6mm_f-f.SLDPRT
5.43 x 6.00 x 4.70 mm
