uccross/open-source-autonomous-vehicle-controller/Self-balancing_bot/Mechanical/Encoder_support.SLDPRT

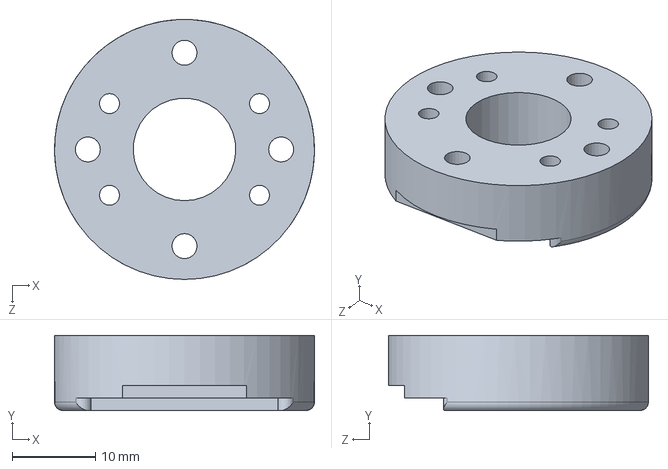
[picture p129: CAD file, 2023-08-13]
Self-balancing_bot/Mechanical/Encoder_support.SLDPRT
31.2 x 9.00 x 31.2 mm
