uccross/open-source-autonomous-vehicle-controller/Self-balancing_bot/Mechanical/Bearing_6mm.SLDPRT

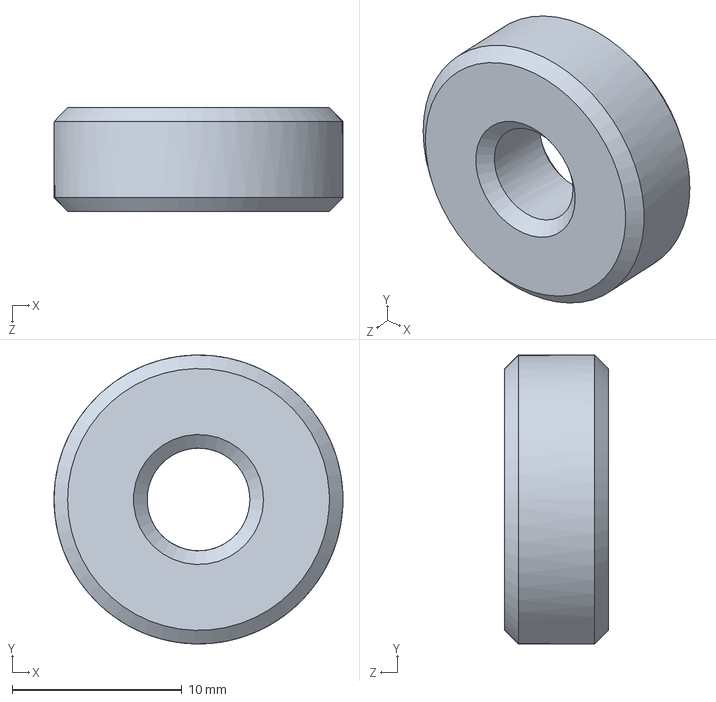
[picture p130: CAD file, 2023-08-13]
Self-balancing_bot/Mechanical/Bearing_6mm.SLDPRT
17.0 x 17.0 x 6.10 mm
