uccross/open-source-autonomous-vehicle-controller/Self-balancing_bot/Mechanical/Coral_USB_accelerator.SLDPRT

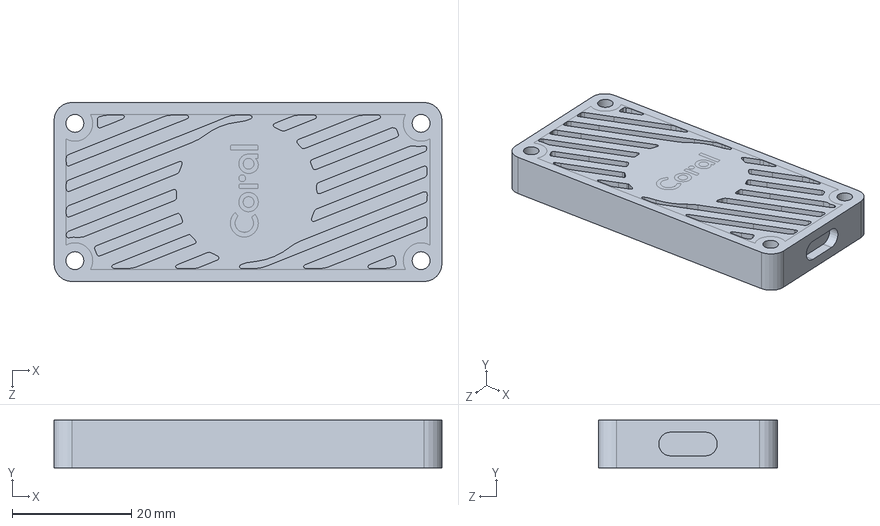
[picture p131: CAD file, 2023-08-13]
Self-balancing_bot/Mechanical/Coral_USB_accelerator.SLDPRT
65.0 x 8.00 x 30.0 mm
