uccross/open-source-autonomous-vehicle-controller/(list of files, cad)

Other CAD files:
Rover/Mechanical/Frame/Mount_Wheel_axis-Stearing_servo.SLDPRT
Quadcopter/Mechanical/Autopilot/PCB.SLDPRT
Quadcopter/Mechanical/Autopilot/Digilent-chipKitMax32.SLDPRT
Quadcopter/Mechanical/Stabilization_test/Stabilization_test_platform_T-joint.SLDPRT
Rover/Mechanical/Hybrid_sensor/Mount_Lidar-Magnet.SLDPRT
Rover/Mechanical/Hybrid_sensor/Mount_Hybrid_sensor.SLDPRT
Rover/Mechanical/Hybrid_sensor/Mount_Hybrid_sensor-Camera.SLDPRT
Self-balancing_bot/Mechanical/Magnet_AS5047D.SLDPRT
Quadcopter/Mechanical/3D_Printable/Mount_FrSky_R-XSR_Tiny_16.STL
Quadcopter/Mechanical/3D_Printable/Mount_GPS.STL
Quadcopter/Mechanical/3D_Printable/Mount_Max32.STL
Quadcopter/Mechanical/3D_Printable/Mount_autopilot_fixture.STL
Quadcopter/Mechanical/3D_Printable/Mount_autopilot_vibration_suppression.STL
Quadcopter/Mechanical/Hardware/Hex_stand_20mm.SLDPRT
Quadcopter/Mechanical/Hardware/Hex_stand_6mm.SLDPRT
Rover/Mechanical/Frame/Chassis_upper.SLDPRT
Rover/Mechanical/Frame/Pi_tray.SLDPRT
Rover/Mechanical/Frame/gps_shelf_leg.SLDPRT
Rover/Mechanical/Frame/micro_holder.SLDPRT
Rover/Mechanical/Frame/sensor_shelf.SLDPRT
Rover/Mechanical/Hybrid_sensor/Arducam_B0332.SLDPRT
Rover/Mechanical/Hybrid_sensor/Screw_M4_Hexhead.SLDPRT
Self-balancing_bot/Mechanical/Lasercut_MDF.SLDDRW
Self-balancing_bot/Mechanical/Lasercut_acrylic_.SLDDRW
