uccross/open-source-autonomous-vehicle-controller/path-finding/install-tf-on-pi.txt

$ sudo apt-get install -y libhdf5-dev libc-ares-dev libeigen3-dev gcc gfortran libgfortran5 \
                          libatlas3-base libatlas-base-dev libopenblas-dev libopenblas-base libblas-dev \
                          liblapack-dev cython3 libatlas-base-dev openmpi-bin libopenmpi-dev python3-dev
$ sudo pip3 install pip --upgrade
$ sudo pip3 install keras_applications==1.0.8 --no-deps
$ sudo pip3 install keras_preprocessing==1.1.0 --no-deps
$ sudo pip3 install numpy==1.20.3
$ sudo pip3 install h5py==3.1.0
$ sudo pip3 install pybind11
$ pip3 install -U --user six wheel mock
$ wget "https://github.com/lhelontra/tensorflow-on-arm/releases/download/v2.4.0/tensorflow-2.4.0-cp37-none-linux_armv7l.whl"
$ ./tensorflow-2.4.0-cp37-none-linux_armv7l_download.sh
$ sudo pip3 uninstall tensorflow
$ sudo -H pip3 install tensorflow-2.4.0-cp37-none-linux_armv7l.whl

【Required】 Restart the terminal.
