uccross/open-source-autonomous-vehicle-controller/documentation/docs/guide/FirstProject.md

# Building Your First Project

## Cloning the Repository

To clone the Repo just execute the following command on Gitbash or your terminal prompt.
We are making the project folder in Desktop you can clone it into directory you want.
Navigate to your desired directory

```bash
cd Desktop
```

```bash
git clone https://github.com/uccross/open-source-autonomous-vehicle-controller.git
```

Now navigate to the modules directory in the Cloned Repo

```bash
cd open-source-autonomous-vehicle-controller/modules
```

Clone the submodules in this directory

```bash
git clone https://github.com/mavlink/c_library_v2
```

## Setting up Hardware

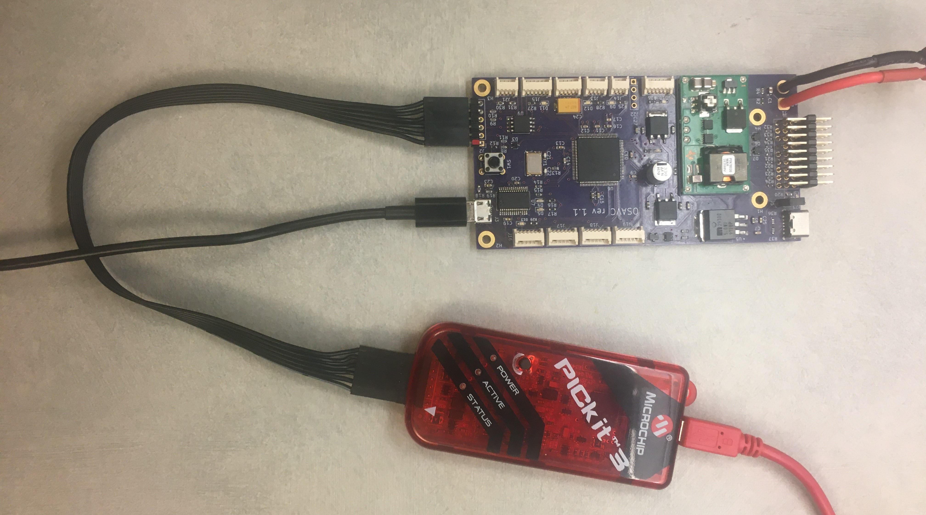
[picture p155: documentation/docs/assets/images/first_project/connection.jpg]
Connection


- Connect ICSP (in circuit serial programming) of PICKIT 3 to the OSAVC
  - Use a mini USB-b cable to connect the PICKIT 3 to your computer
- Use a micro USB cable to connect the OSAVC to your computer for power and a communications port

## Setting up Serial Terminal (CoolTerm / mobaxterm / putty)

- Open CoolTerm after connecting your PC to the OSAVC
- Choose the port at the bottom left of the application as usbserial
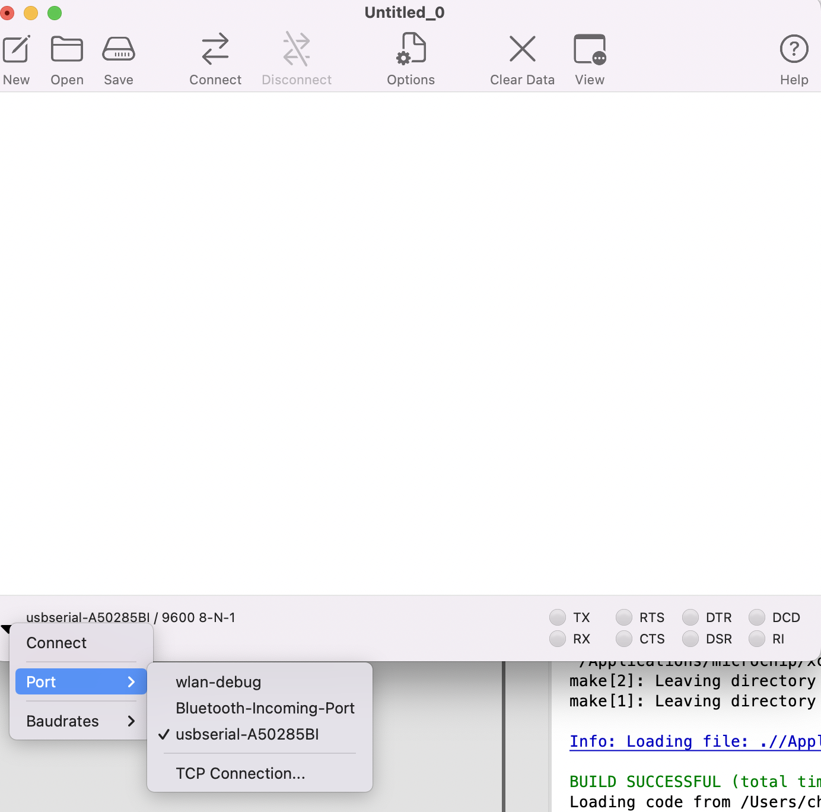
[picture p156: documentation/docs/assets/images/first_project/usbSerial.png]
usbSerial


- Click Options -> Select 115200 as the baud rate -> Click OK to save
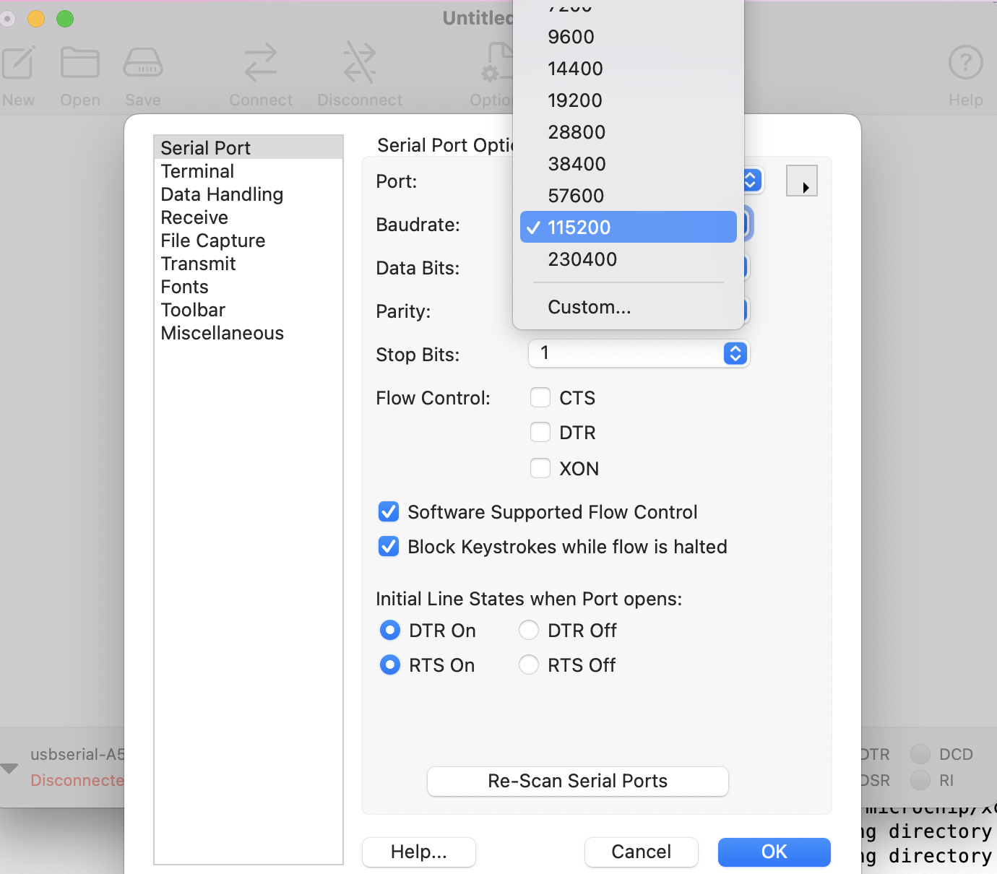
[picture p157: documentation/docs/assets/images/first_project/baudRate.png]
baudrate


- Click Connect at the top of the application

## Setting up the MPLAB X

### Follow the below given setps for running Serial.X

- File -> Open Project
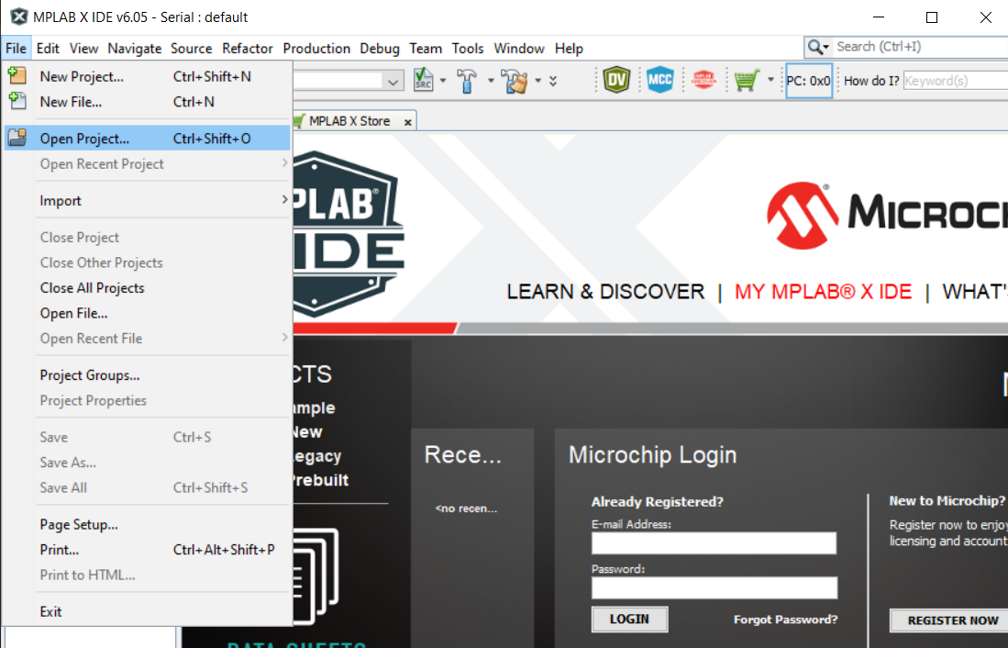
[picture p158: documentation/docs/assets/images/first_project/openProject.png]
Open Project


- Now navigate to -> open-source-autonomous-vehicle-controller -> lib -> Serial.X
you would be able to see the below window with the serial project open
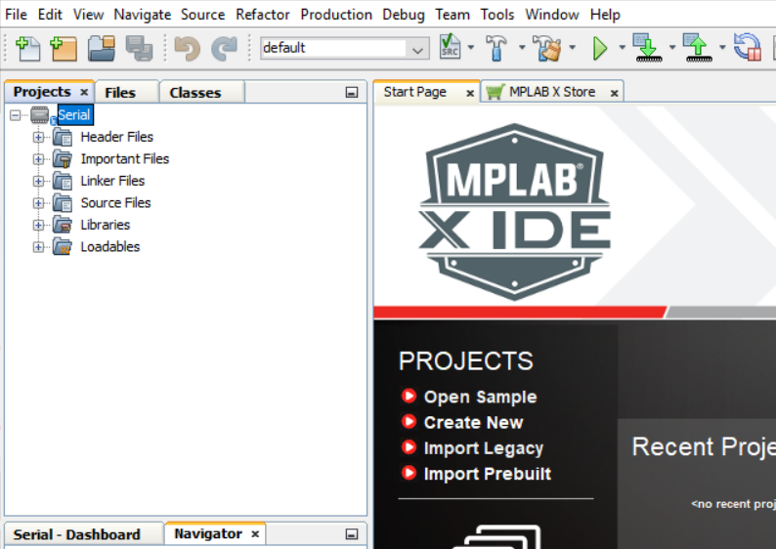
[picture p159: documentation/docs/assets/images/first_project/serial.png]
Serial Project window


- Now Open Serial.X Project Properties (File -> Project Properties)
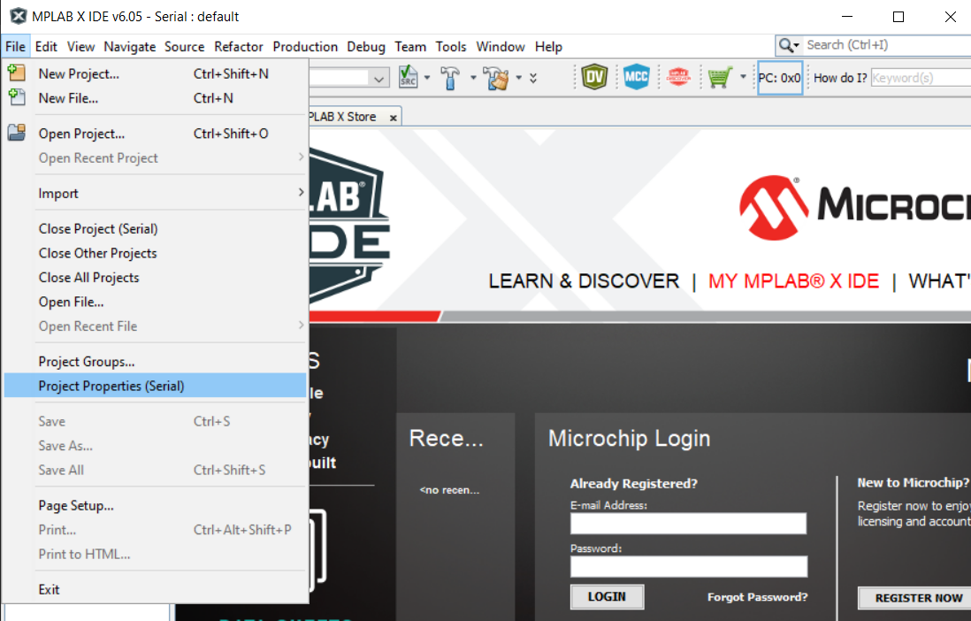
[picture p160: documentation/docs/assets/images/first_project/projectProperties.png]
Serial Project Properties


- Choose Connected Hardware Tool to PICkit3

- Navigate to xc32-ld
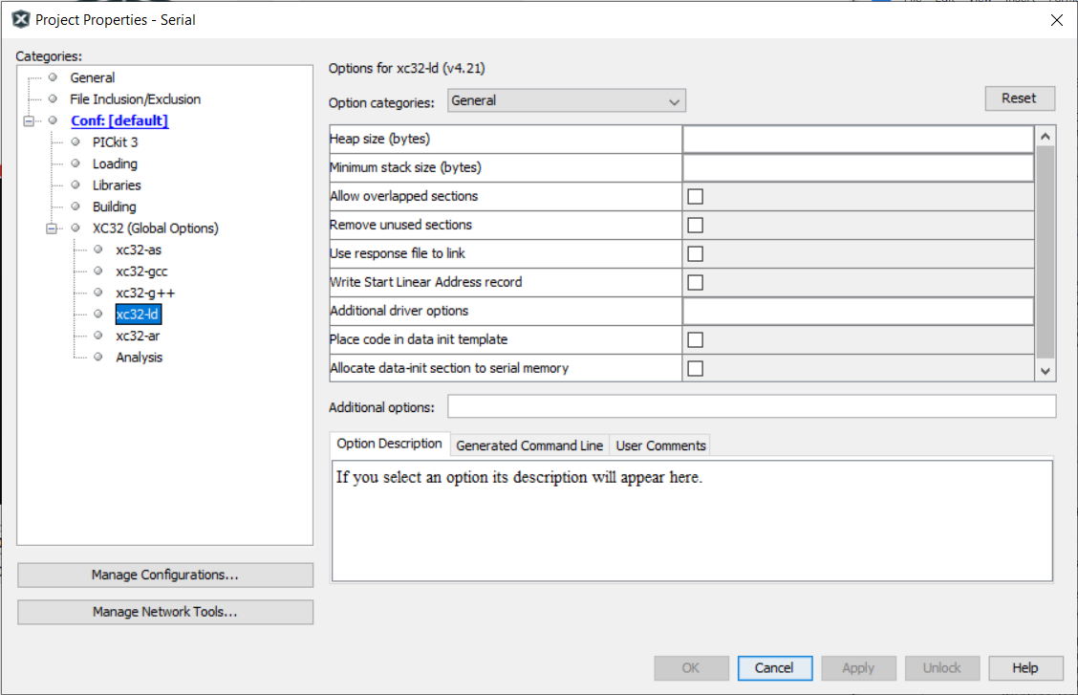
[picture p161: documentation/docs/assets/images/first_project/xc32id.png]
xc32-id


- Choose General as the option category
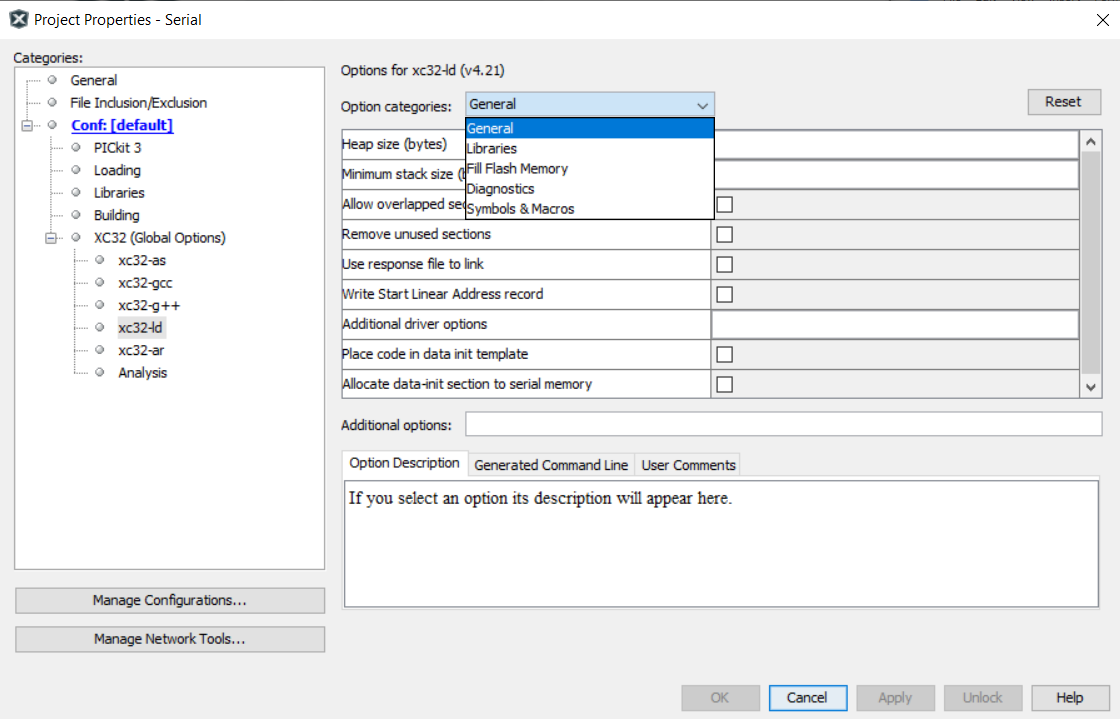
[picture p162: documentation/docs/assets/images/first_project/general.png]
General option category


- set the Heap Size (bytes) to be 8000 bytes
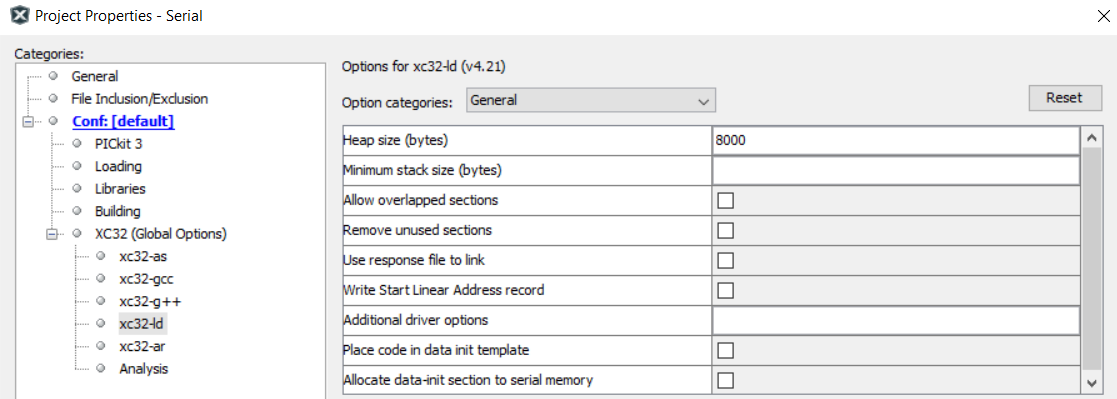
[picture p163: documentation/docs/assets/images/first_project/bytes.png]
Heap Size


- Click OK to save the modified Project Properties
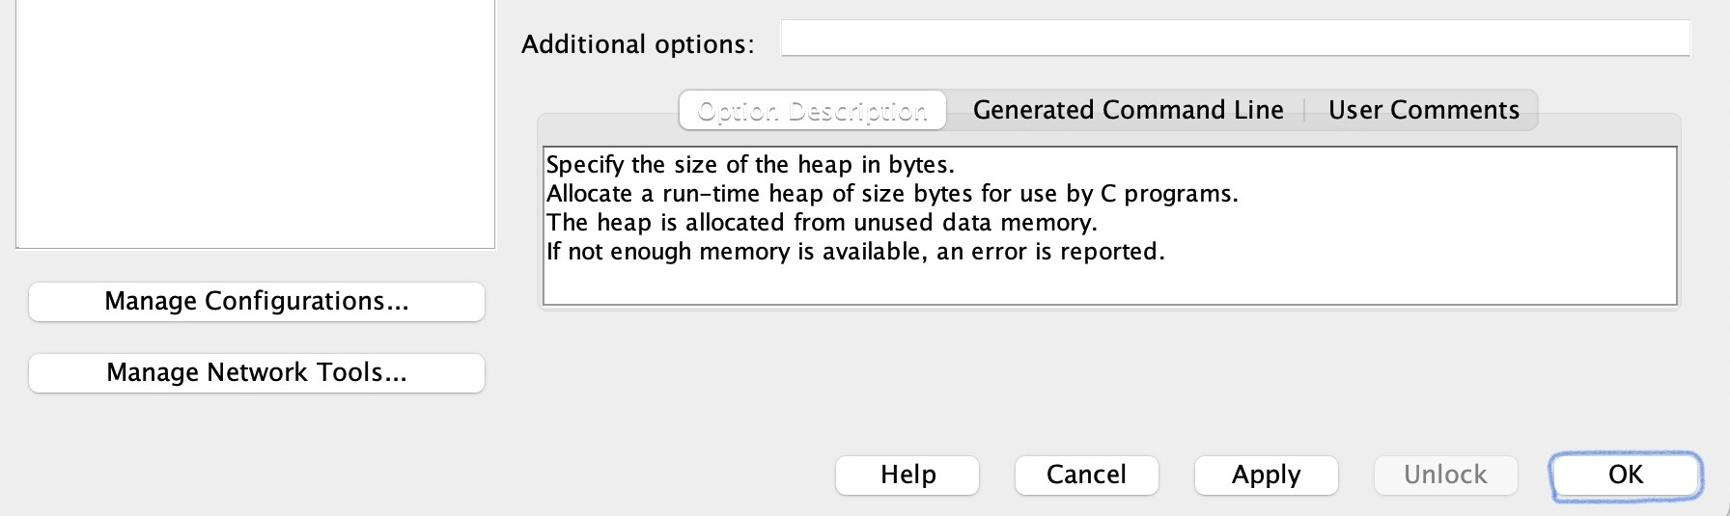
[picture p164: documentation/docs/assets/images/first_project/ok.jpg]
OK


- Click Clean and Build
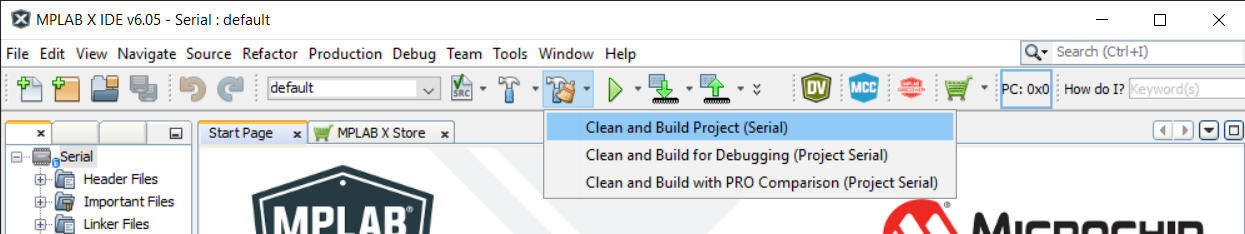
[picture p165: documentation/docs/assets/images/first_project/CleanBuild.png]
Clean and Build


- Click Make and Program Device
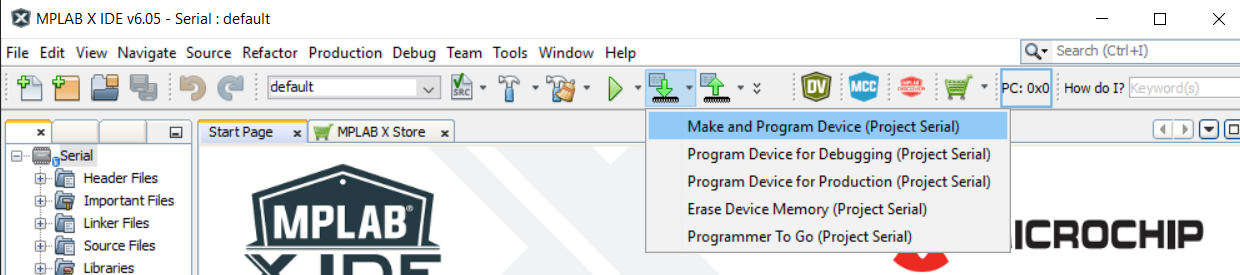
[picture p166: documentation/docs/assets/images/first_project/MakeProgram.png]
Make and Program Device


- Open your preset serial terminal application (CoolTerm)

Output should be:
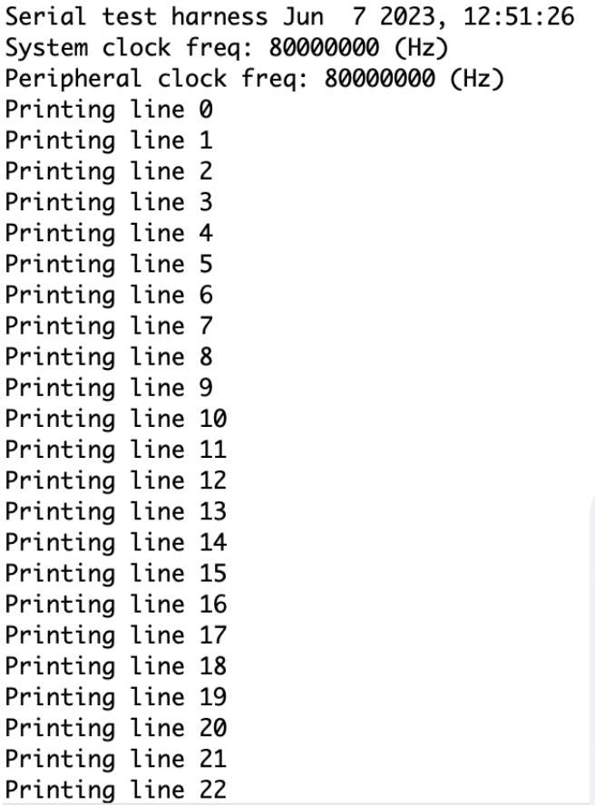
[picture p167: documentation/docs/assets/images/first_project/outputCoolterm.png]
Output from CoolTerm


- Try typing something and press Enter
Something

- What you type should now stay in the serial terminal
