uccross/open-source-autonomous-vehicle-controller/python/logfiles/log_20220222-162205_test.csv

mavpackettype | time_boot_ms | port | chan1_raw | chan2_raw | chan3_raw | chan4_raw | chan5_raw | chan6_raw | chan7_raw | chan8_raw | rssi | time_usec | xacc | yacc | zacc | xgyro | ygyro | zgyro | xmag | ymag | zmag | id | temperature | chan1_scaled | chan2_scaled | chan3_scaled | chan4_scaled | chan5_scaled | chan6_scaled | chan7_scaled | chan8_scaled | fix_type | lat | lon | alt | eph | epv | vel | cog | satellites_visible | alt_ellipsoid | h_acc | v_acc | vel_acc | hdg_acc | yaw | type | autopilot | base_mode | custom_mode | system_status | mavlink_version
RAW_IMU | 203011 | 0 | 172 | 992 | 934 | 951 | 1811 | 992 | 992 | 992 | 255 | 203011145 | 0 | 0 | 0 | 0 | 0 | 0 | 0 | 0 | 0 | 0 | 0 | 0 | 2 | 3 | 1650 | -1 | -1 | -1 | -1 | 3 | 369603405 | -1220326891 | 0 | 65535 | 65535 | 7 | 0 | 255 | 0 | 0 | 0 | 0 | 0 | 0 | 10 | 0 | 192 | 0 | 3 | 3
RC_CHANNELS_SCALED | 203011 | 1 | 172 | 992 | 934 | 951 | 1811 | 992 | 992 | 992 | 255 | 203011145 | 0 | 0 | 0 | 0 | 0 | 0 | 0 | 0 | 0 | 0 | 0 | 0 | 0 | 5 | 1652 | -1 | -1 | -1 | -1 | 3 | 369603405 | -1220326891 | 0 | 65535 | 65535 | 7 | 0 | 255 | 0 | 0 | 0 | 0 | 0 | 0 | 10 | 0 | 192 | 0 | 3 | 3
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
