uccross/open-source-autonomous-vehicle-controller/python/test_mag_motor2.csv

mavpackettype | time_boot_ms | port | chan1_raw | chan2_raw | chan3_raw | chan4_raw | chan5_raw | chan6_raw | chan7_raw | chan8_raw | rssi | time_usec | xacc | yacc | zacc | xgyro | ygyro | zgyro | xmag | ymag | zmag | id | temperature | chan1_scaled | chan2_scaled | chan3_scaled | chan4_scaled | chan5_scaled | chan6_scaled | chan7_scaled | chan8_scaled | fix_type | lat | lon | alt | eph | epv | vel | cog | satellites_visible | alt_ellipsoid | h_acc | v_acc | vel_acc | hdg_acc | yaw | type | autopilot | base_mode | custom_mode | system_status | mavlink_version
RC_CHANNELS_SCALED | 117251 | 1 | 172 | 992 | 934 | 951 | 172 | 172 | 172 | 1811 | 255 | 117251149 | 91 | 69 | 16641 | -24 | 64 | -21 | -90 | 30 | -334 | 0 | 208 | -2 | 3 | -2 | 1724 | -1 | -1 | -1 | -1 | 3 | 369603375 | -1220327196 | 0 | 65535 | 65535 | 2 | 0 | 255 | 0 | 0 | 0 | 0 | 0 | 0 | 10 | 0 | 192 | 0 | 3 | 3
RC_CHANNELS_RAW | 117271 | 0 | 172 | 992 | 934 | 952 | 172 | 172 | 172 | 1811 | 255 | 117251149 | 91 | 69 | 16641 | -24 | 64 | -21 | -90 | 30 | -334 | 0 | 208 | -2 | 3 | -2 | 1724 | -1 | -1 | -1 | -1 | 3 | 369603375 | -1220327196 | 0 | 65535 | 65535 | 2 | 0 | 255 | 0 | 0 | 0 | 0 | 0 | 0 | 10 | 0 | 192 | 0 | 3 | 3
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
