uccross/open-source-autonomous-vehicle-controller/documentation/docs/assets/images/TestHarness/Encoder1.png

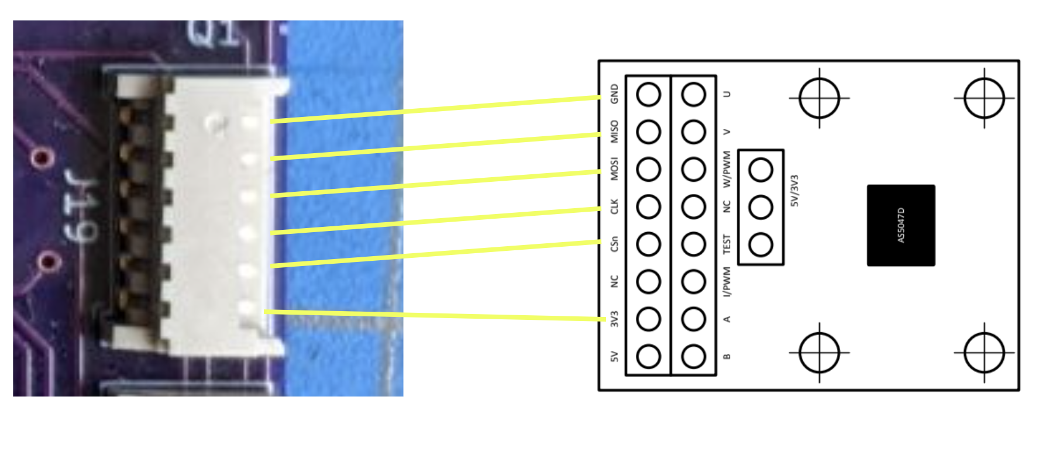
documentation/docs/assets/images/TestHarness/Encoder1.png
