uccross/open-source-autonomous-vehicle-controller/documentation/docs/assets/images/TestHarness/GPS2.png

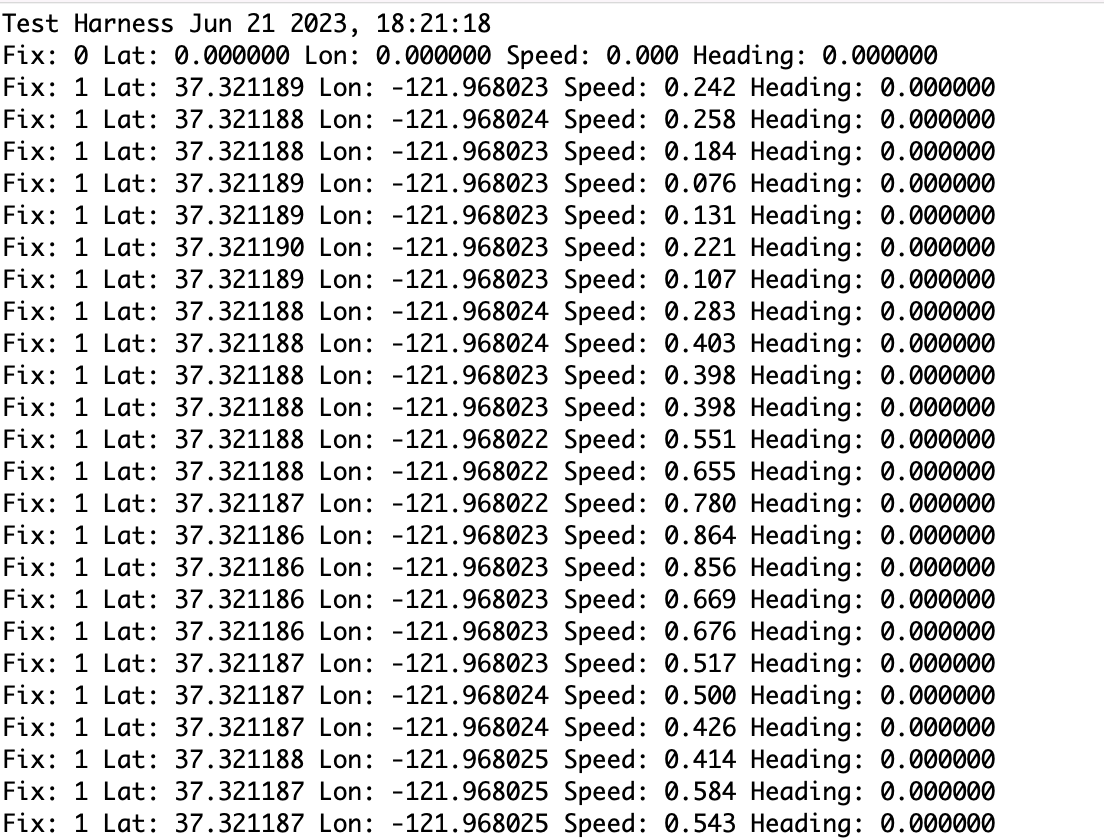
documentation/docs/assets/images/TestHarness/GPS2.png
