uccross/open-source-autonomous-vehicle-controller/documentation/docs/assets/images/TestHarness/IMU3.png

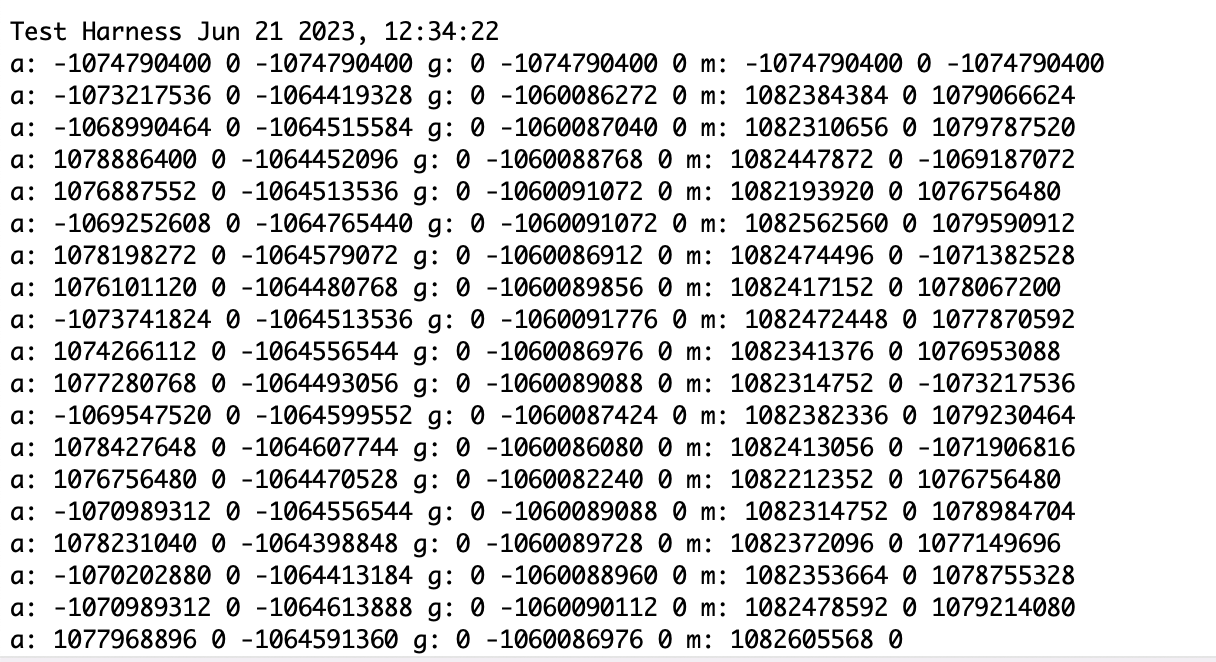
documentation/docs/assets/images/TestHarness/IMU3.png
