uccross/open-source-autonomous-vehicle-controller/documentation/docs/assets/images/TestHarness/LIDAR_1.png

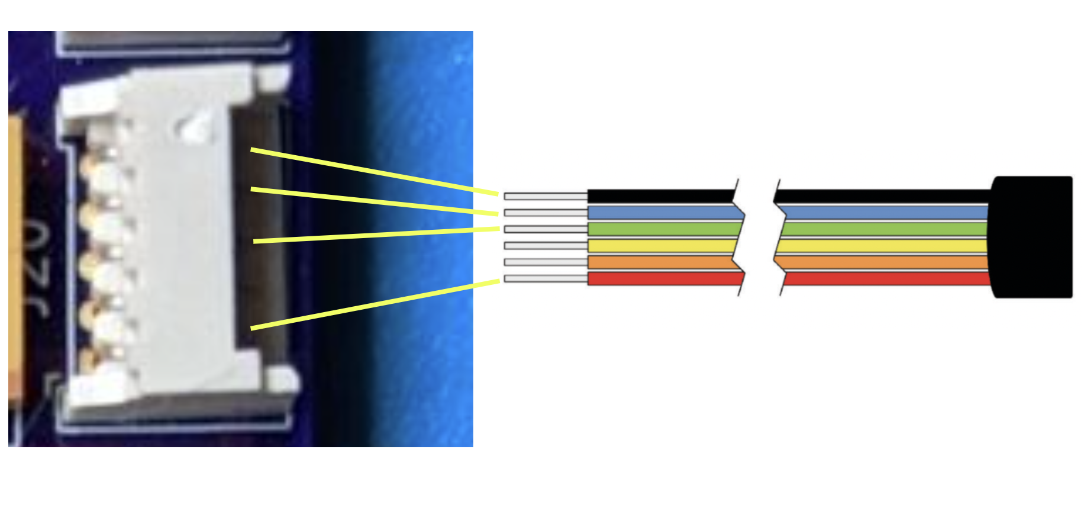
documentation/docs/assets/images/TestHarness/LIDAR_1.png
