uccross/open-source-autonomous-vehicle-controller/documentation/docs/assets/images/TestHarness/MavLink1.png

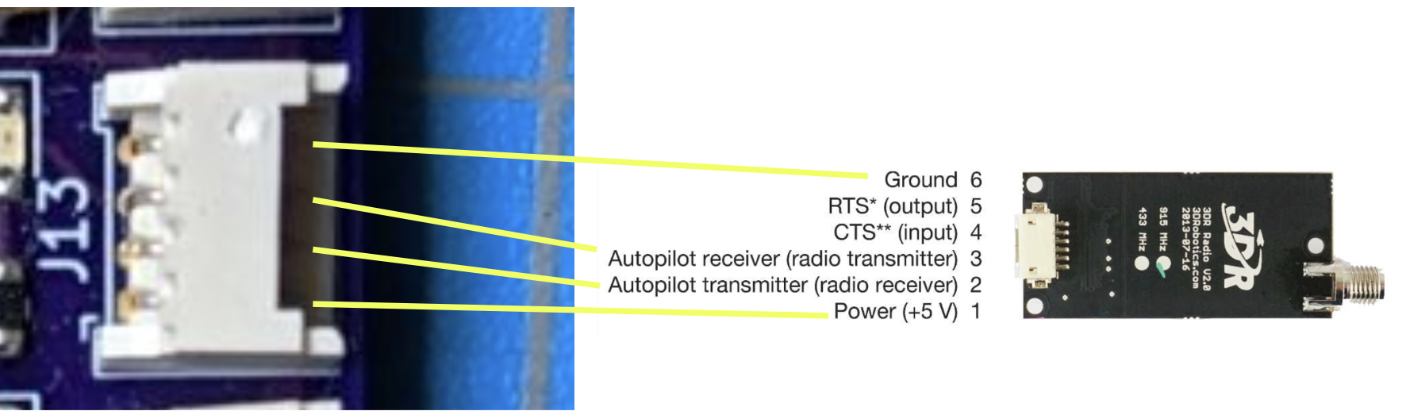
documentation/docs/assets/images/TestHarness/MavLink1.png
