uccross/open-source-autonomous-vehicle-controller/documentation/docs/assets/images/TestHarness/Mavlink4.png

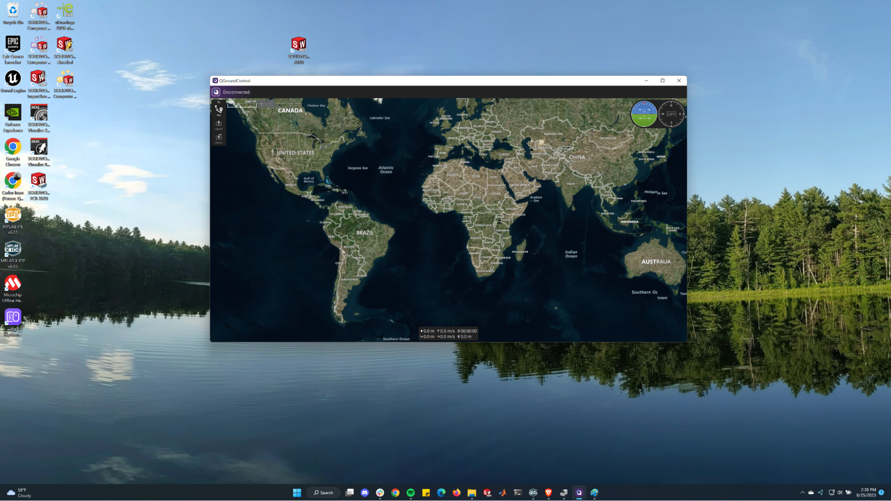
documentation/docs/assets/images/TestHarness/Mavlink4.png
