uccross/open-source-autonomous-vehicle-controller/documentation/docs/assets/images/TestHarness/MavLink5.png

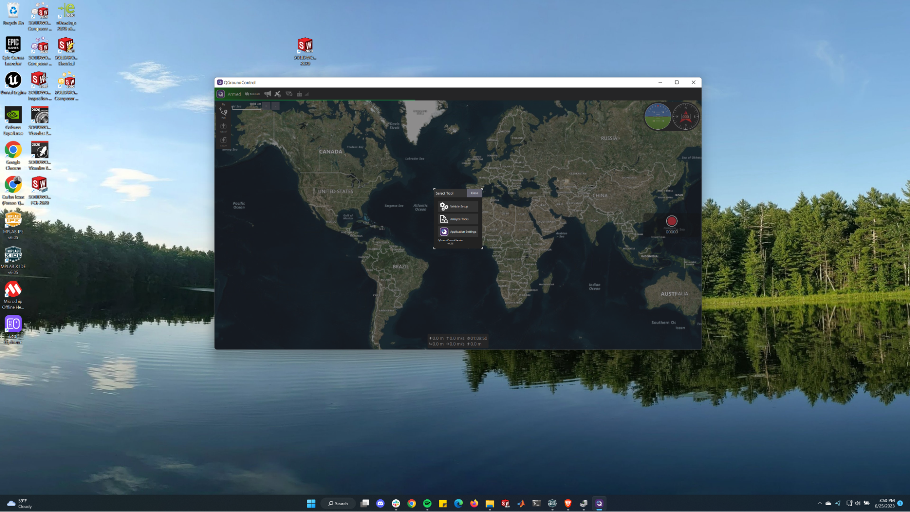
documentation/docs/assets/images/TestHarness/MavLink5.png
