uccross/open-source-autonomous-vehicle-controller/documentation/docs/assets/images/TestHarness/MavLink6.png

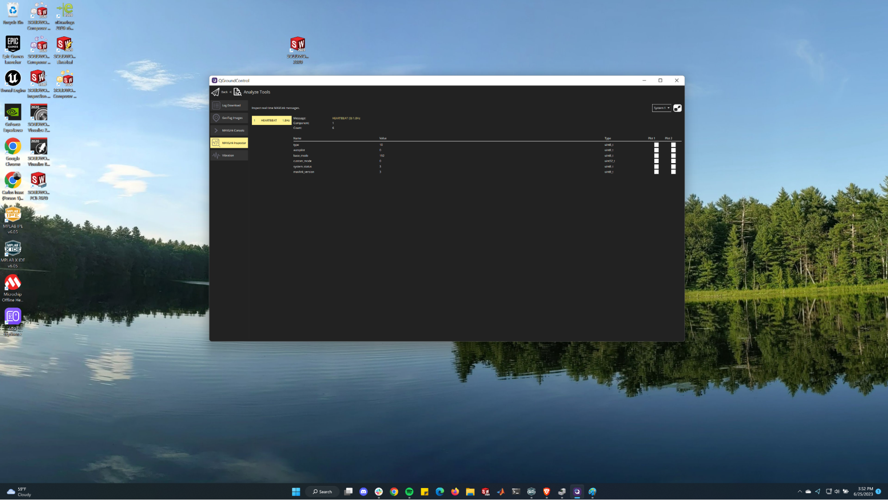
documentation/docs/assets/images/TestHarness/MavLink6.png
