uccross/open-source-autonomous-vehicle-controller/documentation/docs/assets/images/TestHarness/MotorTest1.jpg

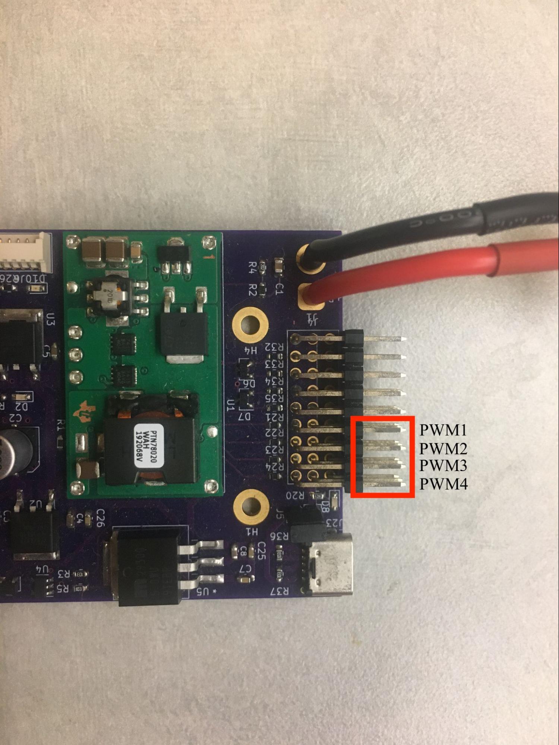
documentation/docs/assets/images/TestHarness/MotorTest1.jpg
