uccross/open-source-autonomous-vehicle-controller/documentation/docs/assets/images/TestHarness/MotorTest3.jpg

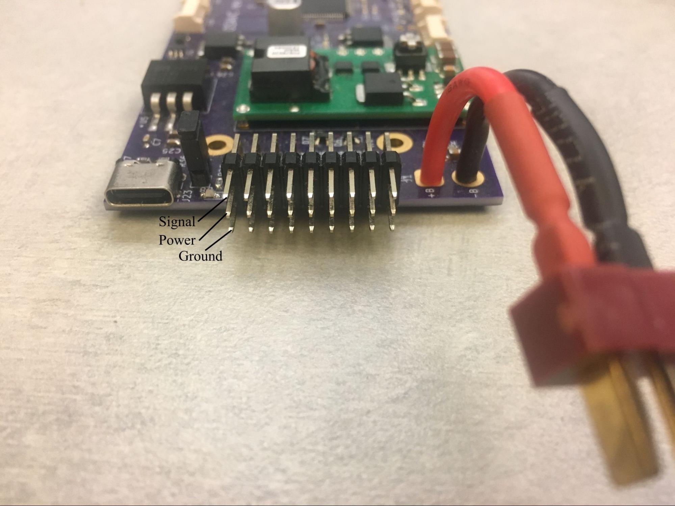
documentation/docs/assets/images/TestHarness/MotorTest3.jpg
