uccross/open-source-autonomous-vehicle-controller/documentation/docs/assets/images/TestHarness/RC_1.png

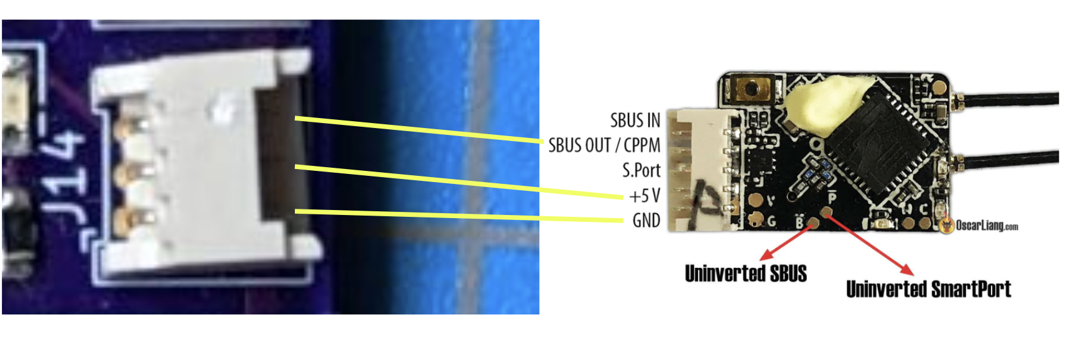
documentation/docs/assets/images/TestHarness/RC_1.png
