uccross/open-source-autonomous-vehicle-controller/path-finding/yolo-v5/data/images/test.jpg

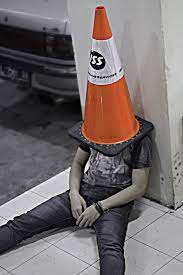
path-finding/yolo-v5/data/images/test.jpg
