uccross/open-source-autonomous-vehicle-controller/documentation/docs/assets/images/first_project/Debug.png

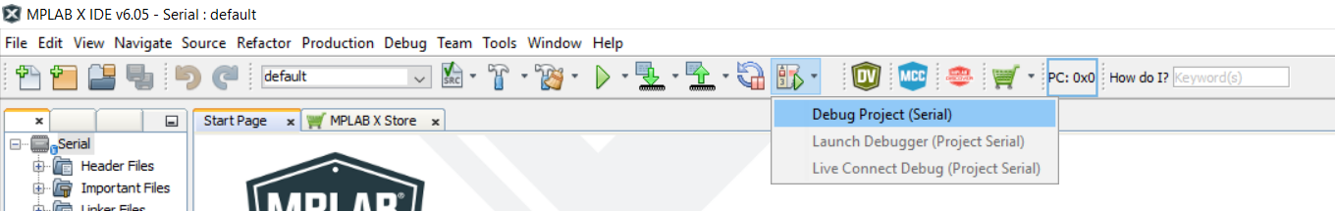
documentation/docs/assets/images/first_project/Debug.png
