uccross/open-source-autonomous-vehicle-controller/Hardware/OSAVC/OSAVC_bottom.pdf

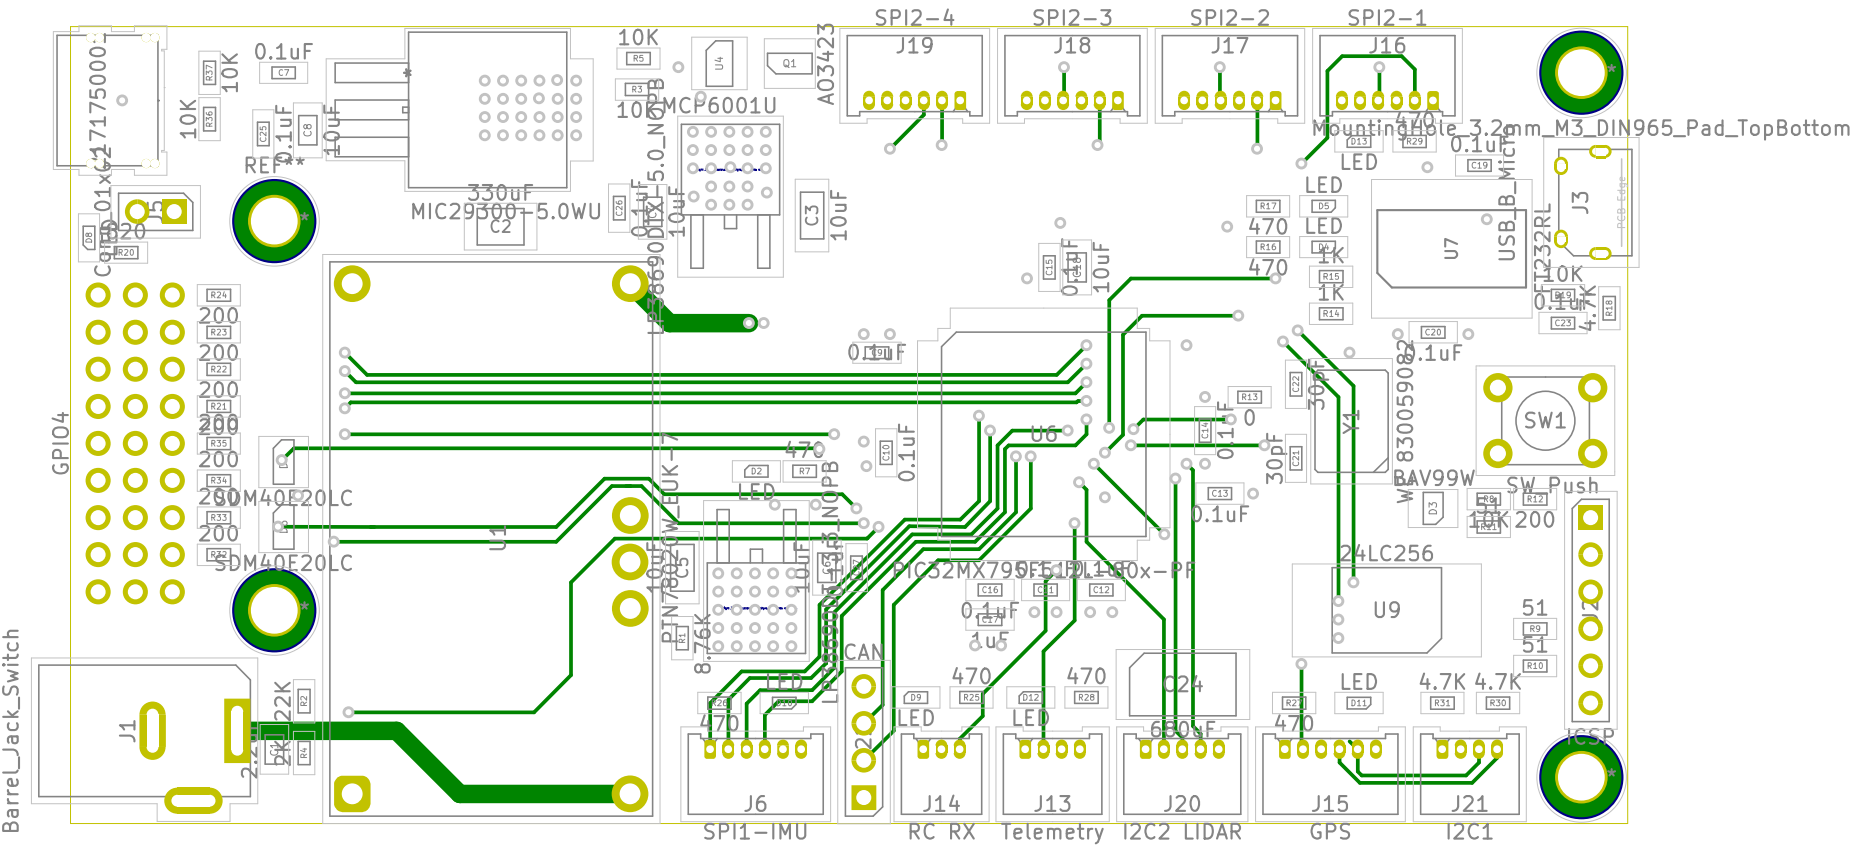
[picture p212: page 1]
