uccross/open-source-autonomous-vehicle-controller/Hardware/OSAVC/OSAVC_in_cu_1.pdf

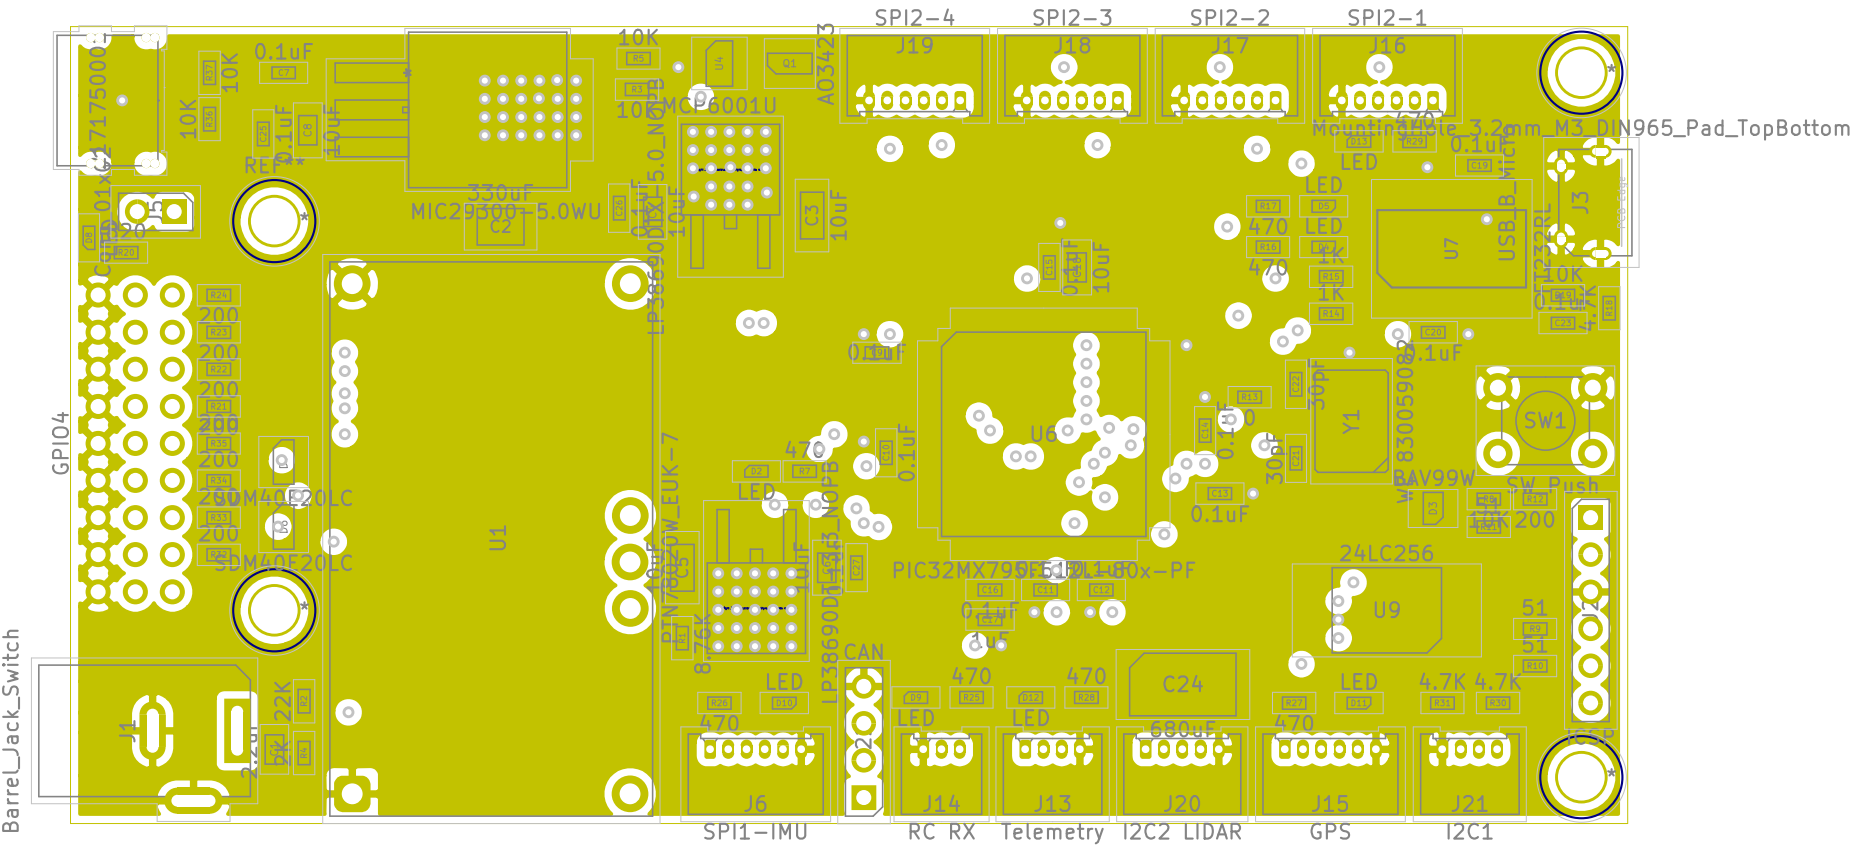
[picture p213: page 1]
