uccross/open-source-autonomous-vehicle-controller/Hardware/OSAVC/OSAVC_in_cu_2.pdf

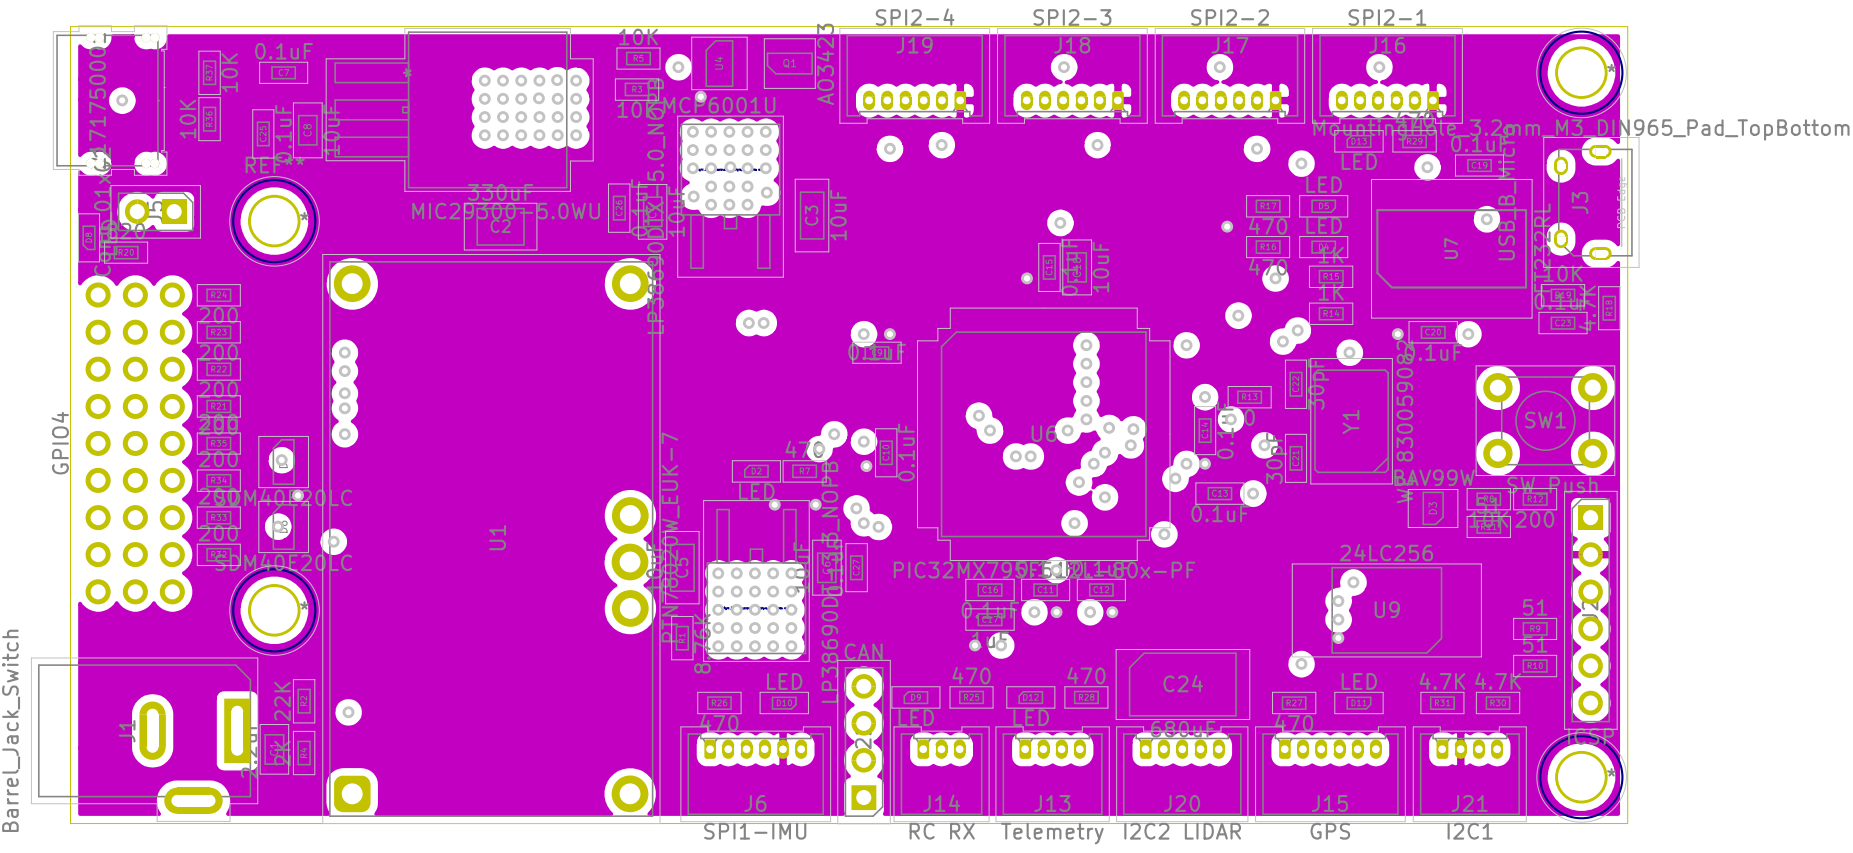
[picture p214: page 1]
