uccross/open-source-autonomous-vehicle-controller/Hardware/OSAVC/OSAVC_top.pdf

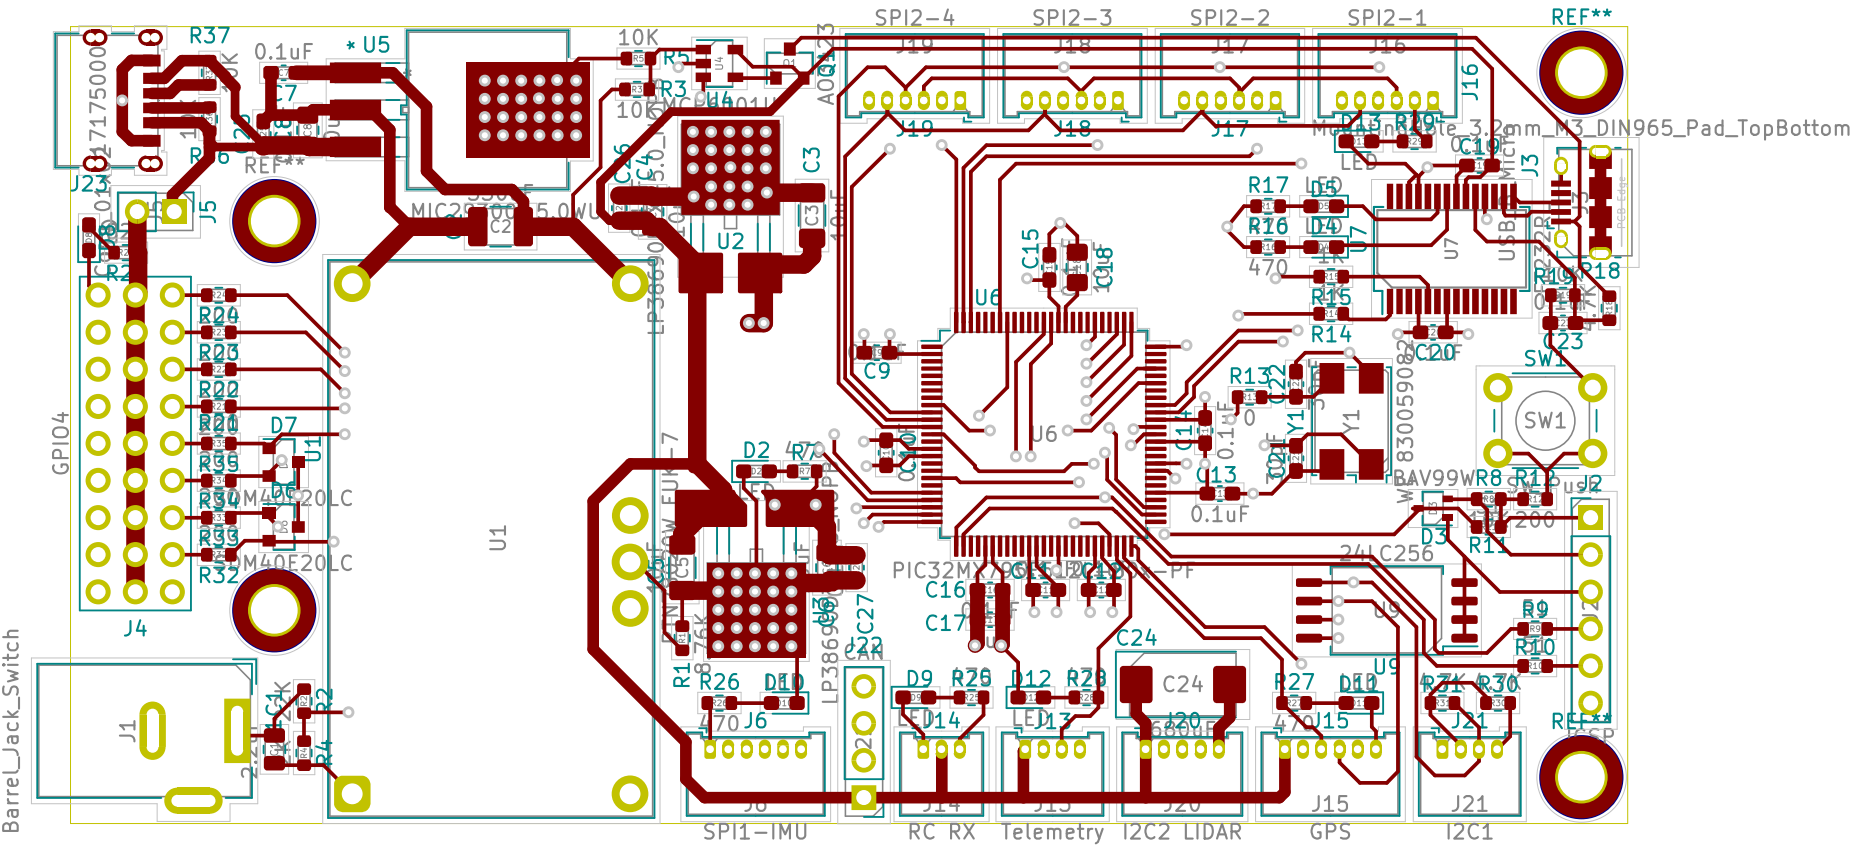
[picture p215: page 1]
