uccross/open-source-autonomous-vehicle-controller/python/images/bicycle_model.pdf

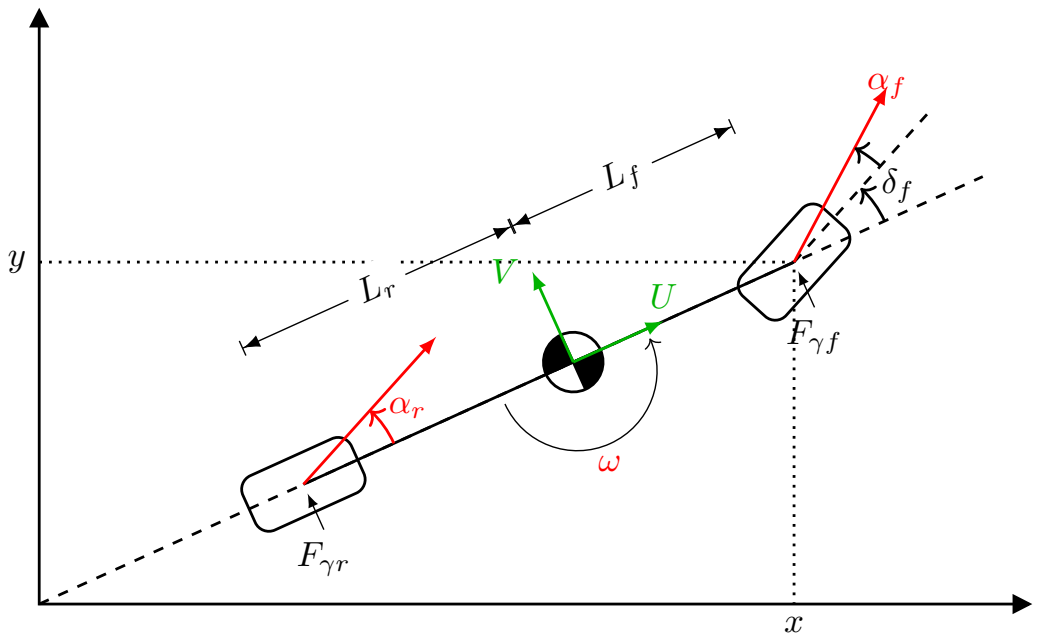
[picture p216: page 1]
Fγr; Fγf
