uccross/open-source-autonomous-vehicle-controller/Rover/Controller/Rover_GNC.X/GNC_main.c

/*
 * File:   GNC_main.c
 * Author: Aaron Hunter
 *
 * Created on December 20, 2022, 5:37 PM
 */

/*******************************************************************************
 * #INCLUDES                                                                   *
 ******************************************************************************/
#include <stdio.h>
#include <stdint.h>
#include <stdlib.h>
#include <string.h>
#include <math.h>
#include "xc.h"
#include "Board.h"
#include "SerialM32.h"
#include "System_timer.h"
#include "Radio_serial.h"
#include "common/mavlink.h"
#include "NEO_M8N.h"
#include "RC_RX.h"
#include "RC_servo.h"
#include "ICM_20948.h"
#include "AHRS.h"
#include "AS5047D.h"
#include "PID.h"

/*******************************************************************************
 * #DEFINES                                                                    *
 ******************************************************************************/
#define HEARTBEAT_PERIOD 1000 //1 sec interval for hearbeat update
#define CONTROL_PERIOD 10 //Period for control loop in msec
#define PUBLISH_PERIOD 50 // Period for publishing data (msec)
#define GPS_PERIOD 100 //10 Hz update rate
#define KNOTS_TO_MPS 0.5144444444 //1 meter/second is equal to 1.9438444924406 knots
#define UINT_16_MAX 0xffff
#define BUFFER_SIZE 1024
#define RAW 1
#define SCALED 2
#define NUM_MOTORS 4
#define DT 0.01 //integration constant
#define MSZ 3 //matrix size
#define QSZ 4 //quaternion size
#define NUM_WAYPTS 5

/*******************************************************************************
 * VARIABLES                                                                   *
 ******************************************************************************/

const uint16_t RC_raw_fs_scale = RC_RAW_TO_FS;
static int8_t RC_system_online = FALSE;


RCRX_channel_buffer RC_channels[CHANNELS] = {RC_RX_MID_COUNTS};
struct IMU_out IMU_raw = {0, 0, 0, 0, 0, 0, 0, 0, 0, 0, 0}; //container for raw IMU data
struct IMU_out IMU_scaled = {0, 0, 0, 0, 0, 0, 0, 0, 0, 0, 0}; //container for scaled IMU data
static struct GPS_data GPS_data;
/* publish signal booleans */
static uint8_t pub_RC_servo = FALSE;
static uint8_t pub_RC_signals = FALSE;
static uint8_t pub_IMU = TRUE;
static uint8_t pub_GPS = TRUE;
static uint8_t pub_encoders = TRUE;
static uint8_t pub_attitude = TRUE;
static uint8_t pub_position = TRUE;

/*conversions*/
const float knots_to_mps = KNOTS_TO_MPS;
const float dt = DT;
const float dt_inv = 1 / DT;
const float deg2rad = M_PI / 180.0;
const float rad2deg = 180.0 / M_PI;
const float enc_ticks2radians = 2.0 * M_PI / 16384.0;
const float TWO_PI = 2 * M_PI;


/*Complementary filter gains*/
float kp_a = 2.5; //accelerometer proportional gain
float ki_a = 0.05; // accelerometer integral gain
float kp_m = 2.5; // magnetometer proportional gain
float ki_m = 0.05; //magnetometer integral gain

/* Calibration matrices and offset vectors */
/* Rover IMU calibration */
float A_acc[MSZ][MSZ] = {
    6.01180201773358e-05, -6.28352073406424e-07, -3.91326747595870e-07,
    -1.18653342135860e-06, 6.01268083773005e-05, -2.97010157797952e-07,
    -3.19011230800348e-07, -3.62174516629958e-08, 6.04564465269327e-05
};
float A_mag[MSZ][MSZ] = {
    0.00351413733554131, -1.74599042407869e-06, -1.62761272908763e-05,
    6.73767225208446e-06, 0.00334531206332366, -1.35302929502152e-05,
    -3.28233797524166e-05, 9.29337701972177e-06, 0.00343350080131375
};
float b_acc[MSZ] = {-0.0156750747576770, -0.0118720194488050, -0.0240128301624044};
float b_mag[MSZ] = {-0.809679246097106, 0.700742334522691, -0.571694648765172};

// gravity inertial vector
float a_i[MSZ] = {0, 0, 1.0};
// Earth's magnetic field inertial vector, normalized 
// North 22,680.8 nT	East 5,217.6 nT	Down 41,324.7 nT, value from NOAA
// converted into ENU format and normalized:
float m_i[MSZ] = {0.110011998753301, 0.478219898291142, -0.871322609031072};

/*attitude*/
float q[QSZ] = {1, 0, 0, 0};
/*gyro bias*/
float gyro_bias[MSZ] = {0, 0, 0};
/*euler angles (yaw, pitch, roll) */
float euler[MSZ] = {0, 0, 0};

/* IMU data arrays */
float gyro_cal[MSZ] = {0, 0, 0};
float acc_cal[MSZ] = {0, 0, 0};
float mag_cal[MSZ] = {0, 0, 0};

/* Rover state */
struct state {
    float x; //meters
    float y;
    float psi; //radians
    float vx; //m/s
    float vy;
    float v;
    float delta; //radians
};
struct state X_new = {.x = 0.0, .y = 0.0, .psi = 0.0, .vx = 0, .vy = 0, .v = 0.0, .delta = 0.0};
struct state X_old = {.x = 0.0, .y = 0.0, .psi = 0.0, .vx = 0, .vy = 0, .v = 0.0, .delta = 0.0};

/* Encoder structs for motors and servo */
encoder_t enc[] = {
    {.last_theta = 0, .next_theta = 0, .omega = 0},
    {.last_theta = 0, .next_theta = 0, .omega = 0},
    {.last_theta = 0, .next_theta = 0, .omega = 0}
};

/* steering servo zero position*/
uint16_t heading_0 = 1805;
/*******************************************************************************
 * CONTROLLERS                                                                 *
 ******************************************************************************/
/* velocity controller PID*/
PID_controller v_PID = {
    .dt = DT,
    .kp = 80.0,
    .ki = 80.0,
    .kd = 0.0,
    .u_max = 500,
    .u_min = -500
};

PID_controller heading_PID = {
    .dt = DT,
    .kp = 10.0,
    .ki = 0.0,
    .kd = 0.0,
    .u_max = 500.0,
    .u_min = -500.0
};

/*******************************************************************************
 * GUIDANCE                                                                    *
 ******************************************************************************/

float waypt[NUM_WAYPTS][MSZ] = {
    3.0, 3.0, 0.0,
    3.0, -3.0, 0.0,
    -3.0, 3.0, 0.0,
    -3.0, -3.0, 0.0,
    0.0, 0.0, 0.0
};

double home[] = {0.0, 0.0, 0.0}; // home position in {lon, lat, alt}
double home_tp[] = {0.0, 0.0, 0.0}; // home in tangent plane (meters)
double X_tp[] = {0.0, 0.0, 0.0}; // current position in tangent plane
float X_ltp[] = {0.0, 0.0, 0.0}; // current position in local tangent plane
/*geodetic constants*/
static const double Geo_a = 6378137.0; // semimajor ellipsoid axis in meters
static const double Geo_b = 6356752.3142; // semiminor ellipsoid axis in meters
static const double Geo_f = 0.00335281067183099; // flatness
static const double Geo_e = 0.0818191909289064; // eccentricity
/*******************************************************************************
 * TYPEDEFS AND ENUMS                                                          *
 ******************************************************************************/
mavlink_system_t mavlink_system = {
    1, // System ID (1-255)
    MAV_COMP_ID_AUTOPILOT1 // Component ID (a MAV_COMPONENT value)
};

enum mission {
    MANUAL = 0, CRUISE, AUTO, BADRCVAL
};

enum RC_channels {
    THR,
    AIL,
    ELE,
    RUD,
    HASH,
    SWITCH_A,
    SWITCH_B,
    SWITCH_C,
    SWITCH_D,
    SWITCH_E
}; //map to the car controls from the RC receiver

enum motors {
    MOTOR_LEFT,
    MOTOR_RIGHT,
    STEERING_SERVO,
    LIDAR_SERVO
};

enum mav_output_type {
    USB,
    RADIO
};

/*******************************************************************************
 * FUNCTION PROTOTYPES                                                         *
 ******************************************************************************/
/**
 * @function check_GPS_events(void)
 * @param none
 * @brief checks for GPS messages, parses, and stores data in module gps variable
 * @author Aaron Hunter
 */
void check_GPS_events(void);

/**
 * @function check_IMU_events(void)
 * @param none
 * @brief detects when IMU SPI transaction completes and then publishes data over Mavlink
 * @author Aaron Hunter
 */
void check_IMU_events(void);
/**
 * @function RC_channels_init(void)
 * @param none
 * @brief set all RC channels to RC_RX_MID_COUNTS
 * @author Aaron Hunter
 */
void check_RC_events();
/**
 * @function check_radio_events(void)
 * @param none
 * @brief looks for messages sent over the radio serial port to OSAVC, parses
 * them and provides responses, if needed
 * @note currently only pushing information to usb-serial port
 * @author Aaron Hunter
 */
void check_radio_events(void);
/**
 * @function check_encoder_events(void)
 * @param none
 * @brief looks for finished data acquisition from the encoders
 * @note 
 * @author Aaron Hunter
 */
void check_encoder_events(void);
/**
 * @function publish_GPS(void)
 * @param none
 * @brief invokes mavlink helper function to generate GPS message and sends to
 * radio serial port
 * @author aaron hunter
 */
void publish_GPS(uint8_t dest);
/**
 * @function publish_IMU_data()
 * @param data_type RAW or SCALED
 * @brief reads module level IMU data and publishes over radio serial in Mavlink
 * @author Aaron Hunter
 */

void publish_IMU_data(uint8_t data_type, uint8_t dest);
/**
 * @function publish_RC_signals_raw(void)
 * @param none
 * @brief scales raw RC signals
 * @author Aaron Hunter
 */
void publish_RC_signals_raw(void);

/**
 * @function publish_encoder_data(void)
 * @brief publish left and right encoder data as "RPM"
 * @note: uses index 0 = LEFT_MOTOR, 1 = RIGHT_MOTOR, 2 = HEADING
 * @note for steering servo (heading) we use the absolute position in radians,
 * velocities are published as raw differences in angles (radians)
 */
void publish_encoder_data(void);

/**
 * @function publish_attitude(void)
 * @brief publishes the quaternion attitude in ENU format
 */
void publish_attitude(void);

/**
 * @function publish_position(void)
 * @brief publishes the rover state variables in local coordinates
 */
void publish_position(void);

/**
 * @Function publish_heartbeat(uint8_t dest)
 * @param dest, either USB or RADIO
 * @brief publishes heartbeat message 
 * @return none
 * @author Aaron Hunter
 */
void publish_heartbeat(uint8_t dest);

/**
 * @Function publish_h(uint8_t param_id[16], uint8_t dest)
 * @param parameter ID
 * @param dest, USB or RADIO
 * @brief invokes mavlink helper to send out stored parameter 
 * @author aaron hunter
 */
void publish_parameter(uint8_t param_id[16], uint8_t dest);
/**
 * @Function mavprint(char msg_buffer[], int8_t msg_length, int8_t output);
 * @param msg_buffer, string of bytes to send to receiver
 * @param msg_length, length of msg_buffer
 * @param output, either USB or RADIO, which peripheral to send the message from
 * @return SUCCESS or ERROR
 */
int8_t mavprint(uint8_t msg_buffer[], uint8_t msg_length, uint8_t output);

/**
 * @Function calc_pw(uint16_t raw_counts)
 * @param raw counts from the radio transmitter (11 bit unsigned int)
 * @return pulse width in microseconds
 * @brief converts the RC input into the equivalent pulsewidth output for servo
 * and ESC control
 * @author aahunter
 * @modified <Your Name>, <year>.<month>.<day> <hour> <pm/am> */
static int calc_pw(int raw_counts);

/**
 * @Function uint8_t check_mission_status(void);
 * @param none
 * @return mission mode 
 * @brief: evaluates RC signals and sets mission mode based on SWITCH D position
 * @author Aaron Hunter
 */
uint8_t check_mission_status(void);

/**
 * @Function set_control_output(uint8_t mode)
 * @param mode, mission type
 * @return none
 * @brief converts RC input signals to pulsewidth values and sets the actuators
 * (servos and ESCs) to those values
 * @author Aaron Hunter
 */
void set_control_output(uint8_t mode);


/**
 * @function Rover_quat2euler()
 * @param q A quaternion
 * @param euler a vector of euler angles in [psi, theta, roll] order
 */
void Rover_quat2euler(float q[MSZ], float euler[MSZ]);

/**
 * @function q_rot_v_q()
 * Rotate a vector from the inertial frame to the body frame
 * @param v_i, a 3space vector in the inertial frame
 * @param q an attitude quaternion
 * sets v_b to the rotated inertial vector in the body frame
 */
void q_rot_v_q(float v_i[MSZ], float q[QSZ], float v_b[MSZ]);

/**
 * @function update_odometry(void)
 * @brief: computes the addition to the vehicle location from encoder data
 * 
 */
void update_odometry(void);

/**
 * @function low_pass(x)
 * @param x, current measurement
 * @return filtered quantity
 */
float low_pass(float x);

/**
 * @function int8_t set_home();
 * @brief:  If GPS data is valid, set home position to current location
 * @return home_set, TRUE, or FALSE
 */
int8_t set_home(void);
/*******************************************************************************
 * FUNCTIONS                                                                   *
 ******************************************************************************/

/**
 * @function check_GPS_events(void)
 * @param none
 * @brief checks for GPS messages, parses, and stores data in module gps variable
 * @author Aaron Hunter
 */
void check_GPS_events(void) {
    static double X_tp[] = {0.0, 0.0, 0.0};
    if (GPS_is_msg_avail() == TRUE) {
        GPS_parse_stream();
    }
    if (GPS_is_data_avail() == TRUE) {
        GPS_get_data(&GPS_data);
    }
    /* update LTP*/
    /* calculate X_tp*/
    /* calculate LTP*/
    /*update X.state*/
}

/**
 * @function GPS2ECEF(float * X[], lon, lat, alt};
 * @parameter X: vector to store position in tangent plane
 * @parameter lon: longitude in degrees
 * @parameter lat: latitude in degrees
 * @parameter alt: altitude in meters above sea level
 * @brief converts GPS position into ECEF coordinates
 * @returns none
 */
void GPS2ECEF(double X[MSZ], double lon, double lat, double alt) {
    double N;
    double sin_lat;
    double sin_lon;
    double cos_lat;
    double cos_lon;

    lat = lat*deg2rad;
    lon = lon*deg2rad;
    sin_lat = sin(lat);
    cos_lat = cos(lat);
    sin_lon = sin(lon);
    cos_lon = cos(lon);
    N = Geo_a / sqrt(1 - Geo_e * Geo_e * sin_lat * sin_lat);
    X[0] = (alt + N) * cos_lat*cos_lon;
    X[1] = (alt + N) * cos_lat*sin_lon;
    X[2] = (alt + (1 - Geo_e * Geo_e) * N) * sin_lat;
}

/**
 * @function GPS2LTP(float X_LTP[MSZ], double X0[MSZ], double X[MSZ], lon, lat);
 * @parameter X_LTP: position in local tangent plane
 * @parameter X0: ECEF coordinate of home position
 * @paramter X: ECEF coordinates of current position
 * @parameter lon: longitude in degrees of current position
 * @parameter lat: latitude in degrees of current position
 * @returns none
 */
void GPS2LTP(float X_LTP[MSZ], double X0[MSZ], double X[MSZ], double lon, double lat) {
    float sin_lat;
    float sin_lon;
    float cos_lat;
    float cos_lon;
    float dX[MSZ];

    lat = lat*deg2rad;
    lon = lon*deg2rad;
    sin_lat = (float) sin(lat);
    cos_lat = (float) cos(lat);
    sin_lon = (float) sin(lon);
    cos_lon = (float) cos(lon);
    float R[MSZ][MSZ];
    R[0][0] = -sin_lon;
    R[0][1] = cos_lon; // 
    R[0][2] = 0.0;
    R[1][0] = -cos_lon*sin_lat;
    R[1][1] = -sin_lat*sin_lon;
    R[1][2] = cos_lat;
    R[2][0] = cos_lat*cos_lon;
    R[2][1] = cos_lat * sin_lon;
    R[2][2] = sin_lat;
    dX[0] = (float) (X[0] - X0[0]);
    dX[1] = (float) (X[1] - X0[1]);
    dX[2] = (float) (X[2] - X0[2]);
    lin_alg_m_v_mult(R, dX, X_LTP);
}

/**
 * @function check_IMU_events(void)
 * @param none
 * @brief detects when IMU SPI transaction completes and then publishes data over Mavlink
 * @author Aaron Hunter
 */
void check_IMU_events(void) {
    if (IMU_is_data_ready() == TRUE) {
        IMU_get_raw_data(&IMU_raw);
        IMU_get_norm_data(&IMU_scaled);

        acc_cal[0] = (float) IMU_scaled.acc.x;
        acc_cal[1] = (float) IMU_scaled.acc.y;
        acc_cal[2] = (float) IMU_scaled.acc.z;
        mag_cal[0] = (float) IMU_scaled.mag.x;
        mag_cal[1] = (float) IMU_scaled.mag.y;
        mag_cal[2] = (float) IMU_scaled.mag.z;
        /*scale gyro readings into rad/sec */
        gyro_cal[0] = (float) IMU_scaled.gyro.x * deg2rad;
        gyro_cal[1] = (float) IMU_scaled.gyro.y * deg2rad;
        gyro_cal[2] = (float) IMU_scaled.gyro.z * deg2rad;
    }
}

/**
 * @function check_RC_events(void)
 * @param none
 * @brief checks for RC messages and stores data in RC channel buffer
 * @author Aaron Hunter
 */
void check_RC_events() {
    if (RCRX_new_cmd_avail()) {
        RCRX_get_cmd(RC_channels);
    }
}

/**
 * @function check_radio_events(void)
 * @param none
 * @brief looks for messages sent over the radio serial port to OSAVC, parses
 * them and provides responses, if needed
 * @note currently only pushing information to usb-serial port
 * @author Aaron Hunter
 */
void check_radio_events(void) {
    uint8_t channel = MAVLINK_COMM_0;
    uint8_t msg_byte;
    uint16_t msg_length;
    uint8_t msg_buffer[BUFFER_SIZE];
    mavlink_message_t msg_rx;
    mavlink_status_t msg_rx_status;

    //MAVLink command structs
    mavlink_heartbeat_t heartbeat;
    mavlink_command_long_t command_qgc;
    mavlink_param_request_read_t param_read;

    if (Radio_data_available()) {
        msg_byte = Radio_get_char();
        if (mavlink_parse_char(channel, msg_byte, &msg_rx, &msg_rx_status)) {
            switch (msg_rx.msgid) {
                case MAVLINK_MSG_ID_HEARTBEAT:
                    mavlink_msg_heartbeat_decode(&msg_rx, &heartbeat);
                    if (heartbeat.type) {
                        msg_length = sprintf(msg_buffer, "heartbeat received type(%d)\r\n", heartbeat.type);
                        mavprint(msg_buffer, msg_length, RADIO);
                    }
                    break;
                case MAVLINK_MSG_ID_COMMAND_LONG:
                    mavlink_msg_command_long_decode(&msg_rx, &command_qgc);
                    msg_length = sprintf(msg_buffer, "Command ID %d received from Ground Control\r\n", command_qgc.command);
                    mavprint(msg_buffer, msg_length, RADIO);
                    break;
                case MAVLINK_MSG_ID_PARAM_REQUEST_READ:
                    mavlink_msg_param_request_read_decode(&msg_rx, &param_read);
                    msg_length = sprintf(msg_buffer, "Parameter request ID %s received from Ground Control\r\n", param_read.param_id);
                    mavprint(msg_buffer, msg_length, RADIO);
                    publish_parameter(param_read.param_id, USB);
                    break;
                default:
                    msg_length = sprintf(msg_buffer, "Received message with ID %d, sequence: %d from component %d of system %d\r\n",
                            msg_rx.msgid, msg_rx.seq, msg_rx.compid, msg_rx.sysid);
                    mavprint(msg_buffer, msg_length, RADIO);
                    break;
            }
        }
    }
}

/**
 * @function check_encoder_events(void)
 * @param none
 * @brief looks for finished data acquisition from the encoders
 * @note 
 * @author Aaron Hunter
 */
void check_encoder_events(void) {
    if (Encoder_is_data_ready()) {
        Encoder_get_data(enc);
    }
}

void check_USB_events(void) {
    uint8_t channel = MAVLINK_COMM_0;
    uint8_t msg_byte;
    uint16_t msg_length;
    uint8_t msg_buffer[BUFFER_SIZE];
    mavlink_message_t msg_rx;
    mavlink_status_t msg_rx_status;

    //MAVLink command structs
    mavlink_heartbeat_t heartbeat;
    mavlink_command_long_t command_qgc;
    mavlink_param_request_read_t param_read;

    if (msg_byte = get_char()) {
        if (mavlink_parse_char(channel, msg_byte, &msg_rx, &msg_rx_status)) {
            switch (msg_rx.msgid) {
                case MAVLINK_MSG_ID_HEARTBEAT:
                    mavlink_msg_heartbeat_decode(&msg_rx, &heartbeat);
                    if (heartbeat.type) {
                        msg_length = sprintf(msg_buffer, "heartbeat received type(%d)\r\n", heartbeat.type);
                        mavprint(msg_buffer, msg_length, RADIO);
                    }
                    break;
                case MAVLINK_MSG_ID_COMMAND_LONG:
                    mavlink_msg_command_long_decode(&msg_rx, &command_qgc);
                    msg_length = sprintf(msg_buffer, "Command ID %d received from Ground Control\r\n", command_qgc.command);
                    mavprint(msg_buffer, msg_length, RADIO);
                    break;
                case MAVLINK_MSG_ID_PARAM_REQUEST_READ:
                    mavlink_msg_param_request_read_decode(&msg_rx, &param_read);
                    msg_length = sprintf(msg_buffer, "Parameter request ID %s received from Ground Control\r\n", param_read.param_id);
                    mavprint(msg_buffer, msg_length, RADIO);
                    publish_parameter(param_read.param_id, USB);
                    break;
                default:
                    msg_length = sprintf(msg_buffer, "Received message with ID %d, sequence: %d from component %d of system %d\r\n",
                            msg_rx.msgid, msg_rx.seq, msg_rx.compid, msg_rx.sysid);
                    mavprint(msg_buffer, msg_length, RADIO);
                    break;
            }
        }
    }
}

/**
 * @function publish_GPS(void)
 * @param none
 * @brief invokes mavlink helper function to generate GPS message and sends to
 * radio serial port
 * @author Aaron Hunter
 */
void publish_GPS(uint8_t dest) {
    static uint8_t gps_fix = GPS_FIX_TYPE_NO_FIX;
    mavlink_message_t msg_tx;
    uint16_t msg_length;
    uint8_t msg_buffer[BUFFER_SIZE];
    //verify fix status
    if (GPS_has_fix() == TRUE) {
        gps_fix = GPS_FIX_TYPE_3D_FIX;
    } else {
        gps_fix = GPS_FIX_TYPE_NO_FIX;
    }
    mavlink_msg_gps_raw_int_pack(mavlink_system.sysid,
            mavlink_system.compid,
            &msg_tx,
            (uint64_t) Sys_timer_get_usec(),
            gps_fix,
            (int32_t) (GPS_data.lat * 10000000.0),
            (int32_t) (GPS_data.lon * 10000000.0),
            0, //altitude --can update GPS data if need this
            UINT_16_MAX, //hdop--currently don't care
            UINT_16_MAX, //vdop
            (uint16_t) (GPS_data.spd * knots_to_mps * 100.0), //need to verify units and convert from knots if so
            (uint16_t) (GPS_data.cog * 100.0), //cdeg TODO verify heading angle between 0 and 359.99
            255, //satellites visible again, currently don't care
            0, //alt ellipsoid
            0, //h position uncertainty
            0, //v position uncertainty
            0, //velocity uncertainty
            0, //heading uncertainty
            0 // yaw--GPS doesn't provide
            );
    msg_length = mavlink_msg_to_send_buffer(msg_buffer, &msg_tx);
    mavprint(msg_buffer, msg_length, dest);
}

/**
 * @function publish_IMU_data()
 * @param none
 * @brief reads module level IMU data and publishes over radio serial in Mavlink
 * @author Aaron Hunter
 */
void publish_IMU_data(uint8_t data_type, uint8_t dest) {
    mavlink_message_t msg_tx;
    uint16_t msg_length;
    uint8_t msg_buffer[BUFFER_SIZE];
    uint8_t IMU_id = 0;
    if (data_type == RAW) {
        mavlink_msg_raw_imu_pack(mavlink_system.sysid,
                mavlink_system.compid,
                &msg_tx,
                Sys_timer_get_usec(),
                (int16_t) IMU_raw.acc.x,
                (int16_t) IMU_raw.acc.y,
                (int16_t) IMU_raw.acc.z,
                (int16_t) IMU_raw.gyro.x,
                (int16_t) IMU_raw.gyro.y,
                (int16_t) IMU_raw.gyro.z,
                (int16_t) IMU_raw.mag.x,
                (int16_t) IMU_raw.mag.y,
                (int16_t) IMU_raw.mag.z,
                IMU_id,
                (int16_t) IMU_raw.temp
                );
    } else if (data_type == SCALED) {
        mavlink_msg_highres_imu_pack(mavlink_system.sysid,
                mavlink_system.compid,
                &msg_tx,
                Sys_timer_get_usec(),
                (float) IMU_scaled.acc.x,
                (float) IMU_scaled.acc.y,
                (float) IMU_scaled.acc.z,
                (float) IMU_scaled.gyro.x,
                (float) IMU_scaled.gyro.y,
                (float) IMU_scaled.gyro.z,
                (float) IMU_scaled.mag.x,
                (float) IMU_scaled.mag.y,
                (float) IMU_scaled.mag.z,
                0.0, //no pressure
                0.0, //no diff pressure
                0.0, //no pressure altitude
                (float) IMU_scaled.temp,
                0, //bitfields updated
                IMU_id
                );
    }
    msg_length = mavlink_msg_to_send_buffer(msg_buffer, &msg_tx);
    mavprint(msg_buffer, msg_length, dest);
}

/**
 * @Function publish_encoder_data()
 * @param none
 * @brief publishes motor data and steering angle data over MAVLink using 
 * rc_channels_scaled. This is a bit of a hack until I can generate my own message
 * @return none
 * @author Aaron Hunter
 */

/**
 * @function publish_RC_signals(void)
 * @param none
 * @brief scales raw RC signals into +/- 10000
 * @author Aaron Hunter
 */
void publish_RC_signals(void) {
    mavlink_message_t msg_tx;
    uint16_t msg_length;
    uint8_t msg_buffer[BUFFER_SIZE];
    uint16_t index = 0;
    uint8_t RC_port = 0; //first 8 channels 
    int16_t scaled_channels[CHANNELS];
    uint8_t rssi = 255; //unknown--may be able to extract from receiver
    for (index = 0; index < CHANNELS; index++) {
        scaled_channels[index] = (RC_channels[index] - RC_RX_MID_COUNTS) * RC_raw_fs_scale;
    }
    mavlink_msg_rc_channels_scaled_pack(mavlink_system.sysid,
            mavlink_system.compid,
            &msg_tx,
            Sys_timer_get_msec(),
            RC_port,
            scaled_channels[0],
            scaled_channels[1],
            scaled_channels[2],
            scaled_channels[3],
            scaled_channels[4],
            scaled_channels[5],
            scaled_channels[6],
            scaled_channels[7],
            rssi);
    msg_length = mavlink_msg_to_send_buffer(msg_buffer, &msg_tx);
    mavprint(msg_buffer, msg_length, USB);

}

/**
 * @function publish_RC_signals_raw(void)
 * @param none
 * @brief scales raw RC signals
 * @author Aaron Hunter
 */
void publish_RC_signals_raw(void) {
    mavlink_message_t msg_tx;
    uint16_t msg_length;
    uint8_t msg_buffer[BUFFER_SIZE];
    uint8_t RC_port = 0; //first 8 channels 
    uint8_t rssi = 255; //unknown--may be able to extract from receiver
    mavlink_msg_rc_channels_raw_pack(mavlink_system.sysid,
            mavlink_system.compid,
            &msg_tx,
            Sys_timer_get_msec(),
            RC_port,
            RC_channels[0],
            RC_channels[1],
            RC_channels[2],
            RC_channels[3],
            RC_channels[4],
            RC_channels[5],
            RC_channels[6],
            RC_channels[7],
            rssi);
    msg_length = mavlink_msg_to_send_buffer(msg_buffer, &msg_tx);
    mavprint(msg_buffer, msg_length, USB);
}

/**
 * @function publish_encoder_data(void)
 * @brief publish left and right encoder data as "RPM"
 * @note: uses index 0 = LEFT_MOTOR, 1 = RIGHT_MOTOR, 2 = HEADING
 * @note for steering servo (heading) we use the absolute position in radians,
 * velocities are published as raw differences in angles (radians)
 */
void publish_encoder_data(void) {
    mavlink_message_t msg_tx;
    uint16_t msg_length;
    uint8_t msg_buffer[BUFFER_SIZE];
    /* publish left motor raw omega*/
    mavlink_msg_raw_rpm_pack(mavlink_system.sysid,
            mavlink_system.compid,
            &msg_tx,
            LEFT_MOTOR,
            (float) enc[LEFT_MOTOR].omega * enc_ticks2radians
            );
    msg_length = mavlink_msg_to_send_buffer(msg_buffer, &msg_tx);
    mavprint(msg_buffer, msg_length, USB);
    /* publish right motor data*/
    mavlink_msg_raw_rpm_pack(mavlink_system.sysid,
            mavlink_system.compid,
            &msg_tx,
            RIGHT_MOTOR,
            (float) enc[RIGHT_MOTOR].omega * enc_ticks2radians
            );
    msg_length = mavlink_msg_to_send_buffer(msg_buffer, &msg_tx);
    mavprint(msg_buffer, msg_length, USB);
    /* publish heading angle in radians*/
    mavlink_msg_raw_rpm_pack(mavlink_system.sysid,
            mavlink_system.compid,
            &msg_tx,
            HEADING,
            X_new.delta
            );
    msg_length = mavlink_msg_to_send_buffer(msg_buffer, &msg_tx);
    mavprint(msg_buffer, msg_length, USB);
}

/**
 * @function publish_attitude(void)
 * @brief publishes the quaternion attitude in ENU format
 */
void publish_attitude(void) {
    mavlink_message_t msg_tx;
    uint16_t msg_length;
    uint8_t msg_buffer[BUFFER_SIZE];
    float repr_offset_q[QSZ] = {0, 0, 0, 0};
    mavlink_msg_attitude_quaternion_pack(mavlink_system.sysid,
            mavlink_system.compid,
            &msg_tx,
            Sys_timer_get_msec(),
            q[0],
            q[1],
            q[2],
            q[3],
            gyro_cal[0],
            gyro_cal[1],
            gyro_cal[2],
            repr_offset_q
            );
    msg_length = mavlink_msg_to_send_buffer(msg_buffer, &msg_tx);
    mavprint(msg_buffer, msg_length, USB);
}

/**
 * @function publish_position(void)
 * @brief publishes the rover state variables in local coordinates
 */
void publish_position(void) {
    mavlink_message_t msg_tx;
    uint16_t msg_length;
    uint8_t msg_buffer[BUFFER_SIZE];
    mavlink_msg_local_position_ned_pack(mavlink_system.sysid,
            mavlink_system.compid,
            &msg_tx,
            Sys_timer_get_msec(),
            X_new.x,
            X_new.y,
            0,
            X_new.vx,
            X_new.vy,
            0);
    msg_length = mavlink_msg_to_send_buffer(msg_buffer, &msg_tx);
    mavprint(msg_buffer, msg_length, USB);
}

/**
 * @Function publish_heartbeat(mav_output_type dest)
 * @param dest, either USB or RADIO
 * @brief publishes heartbeat message 
 * @return none
 * @author Aaron Hunter
 */
void publish_heartbeat(uint8_t dest) {
    mavlink_message_t msg_tx;
    uint16_t msg_length;
    uint8_t msg_buffer[BUFFER_SIZE];
    uint8_t mode = MAV_MODE_FLAG_MANUAL_INPUT_ENABLED | MAV_MODE_FLAG_SAFETY_ARMED;
    uint32_t custom = 0;
    uint8_t state = MAV_STATE_STANDBY;
    mavlink_msg_heartbeat_pack(mavlink_system.sysid
            , mavlink_system.compid,
            &msg_tx,
            MAV_TYPE_GROUND_ROVER, MAV_AUTOPILOT_GENERIC,
            mode,
            custom,
            state);
    msg_length = mavlink_msg_to_send_buffer(msg_buffer, &msg_tx);
    mavprint(msg_buffer, msg_length, dest);
}

/**
 * @Function publish_parameter(uint8_t param_id[16])
 * @param parameter ID
 * @brief invokes mavlink helper to send out stored parameter 
 * @author aaron hunter
 */
void publish_parameter(uint8_t param_id[16], uint8_t dest) {
    mavlink_message_t msg_tx;
    uint16_t msg_length;
    uint8_t msg_buffer[BUFFER_SIZE];
    uint16_t index = 0;
    float param_value = 320.0; // value of the requested parameter
    uint8_t param_type = MAV_PARAM_TYPE_INT16; // onboard mavlink parameter type
    uint16_t param_count = 1; // total number of onboard parameters
    uint16_t param_index = 1; //index of this value
    mavlink_msg_param_value_pack(mavlink_system.sysid,
            mavlink_system.compid,
            &msg_tx,
            param_id,
            param_value,
            param_type,
            param_count,
            param_index
            );
    msg_length = mavlink_msg_to_send_buffer(msg_buffer, &msg_tx);
    mavprint(msg_buffer, msg_length, USB);
}

/**
 * @Function mavprint(char msg_buffer[], int8_t msg_length, int8_t output);
 * @param msg_buffer, string of bytes to send to receiver
 * @param msg_length, length of msg_buffer
 * @param output, either USB or RADIO, which peripheral to send the message from
 * @return SUCCESS or ERROR
 */
int8_t mavprint(uint8_t msg_buffer[], uint8_t msg_length, uint8_t output) {
    uint8_t i;
    if (output == USB) {
        for (i = 0; i < msg_length; i++) {
            putchar(msg_buffer[i]);
        }
    } else if (output == RADIO) {
        for (i = 0; i < msg_length; i++) {
            Radio_put_char(msg_buffer[i]);
        }
    } else {
        return ERROR;
    }
    return SUCCESS;
}

/**
 * @Function calc_pw(uint16_t raw_counts)
 * @param raw counts from the radio transmitter (11 bit unsigned int)
 * @return pulse width in microseconds
 * @brief converts the RC input into the equivalent pulsewidth output for servo
 * and ESC control
 * @author aahunter
 * @modified <Your Name>, <year>.<month>.<day> <hour> <pm/am> */
static int calc_pw(int raw_counts) {
    const int denominator = (RC_RX_MAX_COUNTS - RC_RX_MIN_COUNTS);
    const int numerator = (RC_SERVO_MAX_PULSE - RC_SERVO_MIN_PULSE);
    int pulse_width; //servo output in microseconds

    pulse_width = (raw_counts - RC_RX_MID_COUNTS) * numerator; // scale to servo values
    pulse_width = pulse_width / denominator; // divide out counts
    pulse_width = pulse_width + RC_SERVO_CENTER_PULSE; // add in midpoint of servo pulse
    return pulse_width;
}

/**
 * @Function uint8_t check_mission_status(void);
 * @param none
 * @return none
 * @brief 
 * @author Aaron Hunter
 */
uint8_t check_mission_status(void) {
    int mode = MANUAL;
    char message[BUFFER_SIZE];
    uint8_t msg_len = 0;
    int index;
    int hash;
    int hash_check;
    const int tol = 10;
    int INTOL;

    /* get RC values*/
    hash = RC_channels[HASH];
    hash_check = (RC_channels[THR] >> 2) + (RC_channels[AIL] >> 2) + (RC_channels[ELE] >> 2) + (RC_channels[RUD] >> 2);
    if (abs(hash_check - hash) <= tol) {
        INTOL = TRUE;
        /* Check switch state*/
        /*if switch state == up*/
        if (RC_channels[SWITCH_A] == RC_RX_MIN_COUNTS) {
            /* Manual control enabled */
            mode = MANUAL;
        }/* if switch state == mid*/
        else if (RC_channels[SWITCH_A] == RC_RX_MID_COUNTS) {
            /* we're in cruise control*/
            mode = CRUISE;
        } else if (RC_channels[SWITCH_A] == RC_RX_MAX_COUNTS) {
            /* Autonomous mode enabled*/
            mode = AUTO;
        }
    } else {
        mode = BADRCVAL;
        INTOL = FALSE;
        msg_len = sprintf(message, "%d, %d, %d, %d, %d, %d, %d \r\n", RC_channels[THR], RC_channels[AIL], RC_channels[ELE], RC_channels[RUD], hash, hash_check, INTOL);
        for (index = 0; index < msg_len; index++) {
            Radio_put_char(message[index]);
        }
    }
    return mode;
}

/**
 * @Function set_control_output(void)
 * @param none
 * @return none
 * @brief 
 * @author Aaron Hunter
 */
void set_control_output(uint8_t mode) {
    static uint8_t error_count = 0;
    static float v_ref = 1.0;
    uint8_t error_limit = 10;
    int16_t v_cmd;
    int16_t heading_cmd;
    int16_t motor_trim = -15;
    float position[MSZ] = {0.0, 0.0, 0.0};
    float heading_vec_i[MSZ] = {0.0, 0.0, 0.0}; // vector to waypoint in inertial
    float heading_vec_b[MSZ] = {0.0, 0.0, 0.0}; // vector to waypoint in body frame
    float heading_meas;
    static float heading_ref = 0.0;
    static waypt_index = 0;
    static int8_t mission_active = TRUE;
    uint8_t tol = 1.0; // meters

    switch (mode) {
        case MANUAL:
        {
            /* reset mission status */
            mission_active = TRUE;
            PID_init(&v_PID); // reset PID controller if we switch into manual mode
            /* send commands to motor outputs*/
            RC_servo_set_pulse(calc_pw(RC_channels[ELE]), MOTOR_LEFT);
            RC_servo_set_pulse(calc_pw(RC_channels[ELE]), MOTOR_RIGHT);
            RC_servo_set_pulse(calc_pw(RC_channels[RUD]), STEERING_SERVO);
            error_limit = 0; // reset error counter
            break;
        }
        case CRUISE:
        {
            /* set velocity */
            PID_update(&v_PID, v_ref, X_new.v);
            v_cmd = (uint16_t) (v_PID.u) + RC_SERVO_CENTER_PULSE;
            RC_servo_set_pulse(v_cmd, MOTOR_LEFT);
            RC_servo_set_pulse(v_cmd, MOTOR_RIGHT);
            /* manual steering*/
            RC_servo_set_pulse(calc_pw(RC_channels[RUD]), STEERING_SERVO);
            error_limit = 0; // reset error counter
            break;
        }
        case AUTO:
        {
            /* update position */
            position[0] = X_new.x;
            position[1] = X_new.y;
            position[2] = 0.0;

            /* compute vector to waypoint */
            lin_alg_v_v_sub(&waypt[waypt_index][0], position, heading_vec_i);
            if (lin_alg_v_norm(heading_vec_i) < tol) {
                /*waypoint reached*/
                if (waypt_index < NUM_WAYPTS - 1) {
                    waypt_index++; // go to next waypoint 
                    lin_alg_v_v_sub(&waypt[waypt_index][0], position, heading_vec_i); //recompute heading
                } else {
                    mission_active = FALSE; // no more waypoints, the mission is complete
                }
            }
            if (mission_active) {
                /*set velocity */
                PID_update(&v_PID, v_ref, X_new.v);
                v_cmd = (uint16_t) (v_PID.u) + RC_SERVO_CENTER_PULSE;
                RC_servo_set_pulse(v_cmd, MOTOR_LEFT);
                RC_servo_set_pulse(v_cmd, MOTOR_RIGHT);

                /* rotate vector into body frame */
                q_rot_v_q(heading_vec_i, q, heading_vec_b);
                /* compute angle to waypoint */
                heading_meas = atan2f(heading_vec_b[1], heading_vec_b[0]);
                heading_meas = heading_meas * rad2deg; // convert to degrees
                /* compute control action */
                PID_update(&heading_PID, heading_ref, heading_meas);
                heading_cmd = (int16_t) (heading_PID.u) + RC_SERVO_CENTER_PULSE;
                /* apply control action */
                RC_servo_set_pulse(heading_cmd, STEERING_SERVO);
            } else {
                /*stop the car!*/
                RC_servo_set_pulse(calc_pw(RC_RX_MID_COUNTS + motor_trim), MOTOR_LEFT);
                RC_servo_set_pulse(calc_pw(RC_RX_MID_COUNTS + motor_trim), MOTOR_RIGHT);
                RC_servo_set_pulse(calc_pw(RC_RX_MID_COUNTS), STEERING_SERVO);
            }
            error_limit = 0; // reset error counter
            break;
        }
        case BADRCVAL:
            error_count++;
            if (error_count > error_limit) {
                /*stop the car!*/
                RC_servo_set_pulse(calc_pw(RC_RX_MID_COUNTS + motor_trim), MOTOR_LEFT);
                RC_servo_set_pulse(calc_pw(RC_RX_MID_COUNTS + motor_trim), MOTOR_RIGHT);
                RC_servo_set_pulse(calc_pw(RC_RX_MID_COUNTS), STEERING_SERVO);
            }
            break;
        default:
            break;
    }
}

/**
 * @function quat2euler()
 * @param q A quaternion
 * @param euler a vector of euler angles in [psi, theta, roll] order
 */
void Rover_quat2euler(float q[MSZ], float euler[MSZ]) {

    float q00 = q[0] * q[0];
    float q11 = q[1] * q[1];
    float q22 = q[2] * q[2];
    float q33 = q[3] * q[3];

    // psi
    euler[0] = atan2(2.0 * (q[1] * q[2] + q[0] * q[3]), ((q00 + q11 - q22 - q33)));
    // theta
    euler[1] = asin(2.0 * (q[0] * q[2] - q[1] * q[3]));
    // phi
    euler[2] = atan2(2.0 * (q[2] * q[3] + q[0] * q[1]), q00 - q11 - q22 + q33);
}

/**
 * @function q_rot_v_q()
 * Rotate a vector from the inertial frame to the body frame
 * @param v_i, a 3space vector in the inertial frame
 * @param q an attitude quaternion
 * sets v_b to the rotated inertial vector in the body frame
 */
void q_rot_v_q(float v_i[MSZ], float q[QSZ], float v_b[MSZ]) {

    float q_i[QSZ];
    float q_temp[QSZ];
    float q_conj[QSZ];
    float q_b[QSZ]; // container for inertial vector in body frame as pure quaternion

    // calculate conjugate of q 
    q_conj[0] = q[0];
    q_conj[1] = -q[1];
    q_conj[2] = -q[2];
    q_conj[3] = -q[3];

    //   convert v_i to a pure quaternion --> q_i
    q_i[0] = 0;
    q_i[1] = v_i[0];
    q_i[2] = v_i[1];
    q_i[3] = v_i[2];
    //   first quaternion product q_i by q --> q_temp
    lin_alg_q_mult(q_i, q, q_temp);
    //   second quaternion product q_conj by q_temp -->q_b
    lin_alg_q_mult(q_conj, q_temp, q_b);
    //    set v_b to imaginary part of q_b
    v_b[0] = q_b[1];
    v_b[1] = q_b[2];
    v_b[2] = q_b[3];
}

/**
 * @function update_odometry(void)
 * @brief: computes the addition to the vehicle location from encoder data
 * 
 */
void update_odometry(void) {
    float l = 0.174; // wheelbase in meters
    float r_w = .032; // wheel radius in meters
    float scale = 1.13;
    r_w = r_w*scale; // rough calibration test
    float R; // radius of vehicle path
    float dPsi; // change in heading angle of rover
    float Psi_new;
    float dx; // change in x position of rover
    float dy; // change in y position of rover
    float d_omega; // wheel rotation amount
    float v; // speed
    float delta; // steering angle
    float delta_scale = 0.6958; // theoretical linear fit
    const int16_t max_delta = 2730; // ~ 60 degree turn angle max in counts
    const int16_t TWO_PI_INT = 16383; // 2^14 -1
    int16_t delta_int;

    /* encoder is oriented in opposite orientation so we subtract the angle from
     the zero value instead of the other way around*/
    delta_int = heading_0 - enc[HEADING].next_theta;
    /* Handle wrap around issue*/
    if (delta_int < -max_delta) {
        delta_int = heading_0 - (enc[HEADING].next_theta - TWO_PI_INT);
    }
    /* Compute steering angle */
    delta = (float) (delta_int) * enc_ticks2radians * delta_scale;
    if (delta == 0.0) delta = 1e-17; // prevent divide by zero
    /* compute heading change dPsi in inertial frame */
    R = l / sin(delta);
    /* average the speed from the encoders */
    d_omega = (float) ((enc[LEFT_MOTOR].omega + enc[RIGHT_MOTOR].omega) >> 1) * enc_ticks2radians;
    /* compute raw velocity */
    v = d_omega * r_w * dt_inv; // vehicle speed [m/s]]
    v = low_pass(v); // low pass the raw velocity to smooth out encoder variations
    dPsi = v * dt / R; // heading change due to steering command delta
    Psi_new = X_old.psi + dPsi;
    /* limit Psi to +/- PI*/
    if (Psi_new > M_PI) {
        Psi_new = Psi_new - TWO_PI;
    }
    if (Psi_new < -M_PI) {

        Psi_new = Psi_new + TWO_PI;
    }
    /* compute change in position */
    dx = -R * sin(X_old.psi) + R * sin(Psi_new);
    dy = R * cos(X_old.psi) - R * cos(Psi_new);
    /* update state (X_new)*/
    X_new.x = X_old.x + dx;
    X_new.y = X_old.y + dy;
    X_new.psi = euler[0]; //use AHRS heading rather than odometry
    X_new.vx = dx*dt_inv;
    X_new.vy = dy*dt_inv;
    X_new.v = v;
    X_new.delta = delta;
    /* save previous state (X_old variable) */
    X_old.x = X_new.x;
    X_old.y = X_new.y;
    X_old.psi = X_new.psi;
    X_old.vx = X_new.vx;
    X_old.vy = X_new.vy;
    X_old.v = X_new.v;
    X_old.delta = X_new.delta;

}

/**
 * @function low_pass(x)
 * @param x, current measurement
 * @return filtered quantity
 */
float low_pass(float x) {
    static float y_prev = 0;
    float y_new;
    float alpha = 0.03;
    y_new = y_prev + alpha * (x - y_prev);
    y_prev = y_new;

    return (y_new);
}

/**
 * @function int8_t set_home();
 * @brief:  If GPS data is valid, set home position to current location
 * @return home_set, TRUE, or FALSE
 */
int8_t set_home(void) {
    if (GPS_data.lon != 0.0) {
        home[0] = GPS_data.lon; //x component
        home[1] = GPS_data.lat; // y component
        GPS2ECEF(&home_tp[0], home[0], home[1], 0.0);
        return TRUE;
    }
    return FALSE;
}

int main(void) {
    uint32_t start_time = 0;
    uint32_t cur_time = 0;
    uint32_t RC_timeout = 1000;
    uint32_t control_start_time = 0;
    uint32_t timer_start = 0;
    int32_t timer_end = 0;
    uint32_t publish_start_time = 0;
    uint32_t gps_start_time = 0;
    uint32_t heartbeat_start_time = 0;
    int8_t IMU_state = ERROR;
    int8_t IMU_retry = 5;
    uint32_t IMU_error = 0;
    uint8_t error_report = 50;
    uint8_t mission_mode = MANUAL;
    int8_t is_home_set = FALSE;

    /*radio variables*/
    char c;
    char message[BUFFER_SIZE];
    uint8_t msg_len = 0;

    //Initialization routines
    Board_init(); //board configuration
    Serial_init(); //start debug terminal 
    Encoder_init(); // start the encoders
    Radio_serial_init(); //start the radios
    GPS_init(); // initialize GPS 
    Sys_timer_init(); //start the system timer
    cur_time = Sys_timer_get_msec();
    start_time = cur_time;
    RCRX_init(); //initialize the radio control system
    /*wait until we get data from the RC controller*/
    while (cur_time - start_time < RC_timeout) {
        cur_time = Sys_timer_get_msec();
        if (RCRX_new_cmd_avail()) {
            RC_system_online = TRUE;
            break;
        }
    }
    if (RC_system_online == FALSE) {
        msg_len = sprintf(message, "RC system failed to connect!\r\n");
    } else {
        msg_len = sprintf(message, "RC system online.\r\n");
    }
    mavprint(message, msg_len, RADIO);

    /* With RC controller online we can set the servo PWM outputs*/
    RC_servo_init(ESC_BIDIRECTIONAL_TYPE, SERVO_PWM_1); // Left motor
    RC_servo_init(ESC_BIDIRECTIONAL_TYPE, SERVO_PWM_2); // right motor
    RC_servo_init(RC_SERVO_TYPE, SERVO_PWM_3); //steering servo

    /* initialize the IMU */
    IMU_state = IMU_init(IMU_SPI_MODE);
    if (IMU_state == ERROR && IMU_retry > 0) {
        IMU_state = IMU_init(IMU_SPI_MODE);
        //        printf("IMU failed init, retrying %d \r\n", IMU_retry);
        msg_len = sprintf(message, "IMU failed init, retrying %d \r\n", IMU_retry);
        mavprint(message, msg_len, RADIO);
        IMU_retry--;
    }

    /* initialize the PIDs*/
    PID_init(&v_PID);
    PID_init(&heading_PID);

    /* get zero angle heading*/
    Encoder_start_data_acq();
    while (Encoder_is_data_ready() == FALSE) {
        ; // wait for encoder response
    }
    Encoder_get_data(enc); // get encoder values
    heading_0 = enc[STEERING_SERVO].next_theta;

    msg_len = sprintf(message, "\r\nRover Manual Control App %s, %s \r\n", __DATE__, __TIME__);
    mavprint(message, msg_len, RADIO);
    /* load IMU calibrations */
    IMU_set_mag_cal(A_mag, b_mag);
    IMU_set_acc_cal(A_acc, b_acc);

    /* set filter gains and inertial guiding vectors for AHRS*/
    AHRS_set_filter_gains(kp_a, ki_a, kp_m, ki_m);
    AHRS_set_mag_inertial(m_i);

    cur_time = Sys_timer_get_msec();
    control_start_time = cur_time;
    publish_start_time = cur_time;
    heartbeat_start_time = cur_time;
    gps_start_time = cur_time;

    while (1) {
        //check for all events
        check_IMU_events(); //check for IMU data ready
        check_encoder_events(); // check for encoder data ready
        check_GPS_events(); //check and process incoming GPS messages
        check_radio_events(); //detect and process MAVLink incoming messages
        check_USB_events(); // look for MAVLink messages
        check_RC_events(); //check incoming RC commands
        cur_time = Sys_timer_get_msec();
        /* update control loop*/
        if (cur_time - control_start_time >= CONTROL_PERIOD) {
            control_start_time = cur_time; //reset control loop timer

            AHRS_update(acc_cal, mag_cal, gyro_cal, dt, q, gyro_bias);
            Rover_quat2euler(q, euler);
            update_odometry();
            mission_mode = check_mission_status();
            set_control_output(mission_mode); // set actuator outputs
            /*start next data acquisition round*/
            Encoder_start_data_acq(); // start encoder acquisition
            IMU_state = IMU_start_data_acq(); //initiate IMU measurement with SPI
            if (IMU_state == ERROR) { //last transaction didn't complete
                IMU_error++;
                if (IMU_error % error_report == 0) {
                    /* let's check frmerr bit*/
                    msg_len = sprintf(message, "IMU errors: %d, buf: %d\r\n", IMU_error, SPI1STATbits.SPIROV);
                    mavprint(message, msg_len, RADIO);
                    IMU_retry = 5;
                    IMU_state = IMU_init(IMU_SPI_MODE);
                    if (IMU_state == ERROR && IMU_retry > 0) {
                        IMU_state = IMU_init(IMU_SPI_MODE);
                        IMU_retry--;
                    }
                }
            }
            /* test time duration of control actions*/
            timer_end = Sys_timer_get_usec() - timer_start;
        }
        /* publish high speed sensors */
        if (cur_time - publish_start_time > PUBLISH_PERIOD) {
            publish_start_time = cur_time; //reset publishing timer
            if (pub_RC_signals == TRUE) {
                publish_RC_signals_raw();
            }
            if (pub_IMU == TRUE) {
                publish_IMU_data(SCALED, USB);
            }
            if (pub_encoders == TRUE) {
                publish_encoder_data();
            }
            if (pub_attitude == TRUE) {
                publish_attitude();
            }
            if (pub_position == TRUE) {
                publish_position();
            }
        }

        /* publish GPS */
        if (cur_time - gps_start_time > GPS_PERIOD) {
            gps_start_time = cur_time; //reset GPS timer
            if (pub_GPS == TRUE) {
                publish_GPS(USB);
            }
        }
        /* if period timer expires, publish the heartbeat message*/
        if (cur_time - heartbeat_start_time >= HEARTBEAT_PERIOD) {
            heartbeat_start_time = cur_time; //reset the timer
            publish_heartbeat(USB);
            /*check for GPS location lock*/
            if (is_home_set == FALSE) {
                is_home_set = set_home();
            }

            msg_len = sprintf(message, "x: %3.1f y: %3.1f psi: %3.1f vx: %3.1f vy: %3.1f v: %3.1f delta: %3.1f \r\n",
                    X_new.x, X_new.y, X_new.psi*rad2deg, X_new.vx, X_new.vy, X_new.v, X_new.delta * rad2deg);
            mavprint(message, msg_len, RADIO);
            timer_start = Sys_timer_get_usec();
            //            msg_len = sprintf(message, "Home: y=%3.6f x=%3.6f, GPS: lat: %3.6f, lon: %3.6f \r\n", home[1], home[0], GPS_data.lat, GPS_data.lon);
            //            mavprint(message, msg_len, RADIO);
            GPS2ECEF(&X_tp[0], GPS_data.lon, GPS_data.lat, 0.0);
            GPS2LTP(X_ltp, home_tp, X_tp, GPS_data.lon, GPS_data.lat);
            timer_end = Sys_timer_get_usec();
            msg_len = sprintf(message, "timer: %d;  LTP: y=%3.6f x=%3.6f, GPS: lat: %3.6f, lon: %3.6f \r\n",
                    timer_end-timer_start, X_ltp[1], X_ltp[0], GPS_data.lat, GPS_data.lon);
            mavprint(message, msg_len, RADIO);
            //            msg_len = sprintf(message, "status buffer SPIROV: %d\r\n", SPI1STATbits.SPIROV);
            //            mavprint(message, msg_len, RADIO);
        }
    }
    return (0);
}
