uccross/open-source-autonomous-vehicle-controller/(commit log)

2020-11-14 First contact with IMU
2020-11-15 Accelerometer data working, mag contacted but no data yet
2020-11-18 blocking IMU capability added
2020-11-19 ICM configured as I2C Master
2020-11-20 Working with interrupts
2020-11-21 non-blocking I2C working at 100kHz
2020-11-24 Fully working 400KHz interrupt driven
2020-11-30 blocking SPI implementation done
2020-12-01 non-blocking SPI reads working
2020-12-02 implemented low-pass filters and cleaned up the documentation
2020-12-04 SPI code ported from Unp32 project, almost working...
2020-12-04 fixed issue with persistent interrupt
2020-12-16 Added third encoder
2020-12-19 servo library added--working with a single servo
2020-12-19 Implemented multiple servos, switched to PWM mode rather than dual compare continuous mode
2020-12-26 servo commands calculated
2021-01-12 RC RX and RC servo libraries added
2021-01-12 Timer library implemented
2021-02-01 moved event and publish codes into functions and introduced event timers
2021-02-02 RC signals integrated, working on IMU--error with getting data
2021-02-02 fixed IMU bug
2021-02-02 added function to copy module encoder data to external struct
2021-02-03 added data_ready functionality for encoders
2021-02-03 Added encoders for the motors
2021-02-06 Implemented reset for IMU errors
2021-02-08 updated ISR and state machines for SPI devices so that flag is cleared adn data read prior to entry into state machine
2021-04-06 KiCAD files for interface shield board
    [OSAVC interface shield.sch]
2021-04-06 added KiCAD support files
    [OSAVC interface shield.kicad_pcb]
2021-04-28 Lidar tested with daugherboard
2021-05-24 fixed errors in layout
    [OSAVC interface shield.kicad_pcb, OSAVC interface shield.sch]
2021-05-29 new feature: IMU calibration script
2021-06-03 cleaned up python utilities for imu cal
2021-06-04 enhanced: python scripts for collecting and calibrating IMU data
2021-06-05 bug fix: IMU retry added to Mavlink Minimal, need to fix it in IMU lib
2021-06-07 bug fix: scaling error in mag
    [imu.py]
2021-06-15 Finished EEPROM2 library, blocking driver code
2021-06-18 Added dorveaux fixed-lag implementation
    [dorveaux_fixed_lag.py, generate_points.py]
2021-06-20 Added initial batch before RLS and recovery of calibration matrices from implicit parameters
2021-06-22 Save and plot running errors
    [recursive_least_squares.py]
2021-06-22 Testing calibration with a sudden change in parameters
2021-06-28 Changed expression for matrix A, added batch dorveaux code and added plotting functions
    [points_calib__2021-06-26-17-12-03.csv, points_calib__2021-06-26-17-45-21.csv, points_calib__2021-06-26-19-23-29.csv, points_raw__2021-06-26-17-12-03.csv, points_raw__2021-06-26-17-45-21.csv, points_raw__2021-06-26-19-23-29.csv]
2021-06-28 Removed test sets
    [points_calib__2021-06-26-17-12-03.csv, points_calib__2021-06-26-17-45-21.csv, points_raw__2021-06-26-17-12-03.csv, points_raw__2021-06-26-17-45-21.csv]
2021-06-28 Removed test csvs
    [points_calib__2021-06-26-19-23-29.csv, points_raw__2021-06-26-19-23-29.csv]
2021-06-30 PCB fix, changed steering to left stick on passthrough mode
    [OSAVC interface shield.kicad_pcb]
2021-07-02 Added skeleton code for full calibration
2021-07-06 Added gyro calibration (RLS-based) code
2021-07-07 fixed point calibration of IMU working
    [imu.py, mav_test.py]
2021-07-07 Added skeleton for mavlink and changed acc-mag based gyro angle prediction to GPS
2021-07-08 Added getter and setter functions for calibration values and made private methods static
2021-07-14 Added ahrs static filters
2021-07-20 IMU: added high resolution message; I/O board: minor fixes and added pullup resistors
    [OSAVC interface shield.kicad_pcb, OSAVC interface shield.sch]
2021-07-26 Added exception handling for outliers
    [points_calib.csv, points_raw.csv]
2021-07-28 Bug fixes in plot_stats and switched to SI unit raw data
    [calib_all_sensors.py, plot_stats.py, recursive_least_squares.py, test_utils.py]
2021-07-30 added tolerance based outlier pruning
    [calib_all_sensors.py, recursive_least_squares.py]
2021-07-31 python csv datalogging script and mavlink minimal updated for rc operation
    [OSAVC.kicad_pcb, OSAVC.sch]
2021-08-03 Added frame per second snippet
2021-08-08 Added intermediate step of batch calibration params (for tests)
2021-08-10 Fixed major bug: denoemalization of bias
    [calib_all_sensors.py, recursive_least_squares.py, utils.py]
2021-08-13 Added test2 and params (untuned) for remaining static filters
2021-08-15 Modified ahrs test 3 to test all filters against a reference filter
2021-08-18 Tuned ahrs parameters and minor bug fixes
    [filters.py, recursive_least_squares.py]
2021-08-19 added docstrings for ahrs filter tests
2021-08-27 initial commit adding solidworks model
    [DJI_Flame_Wheel_F450.SLDASM, DJI_Flame_Wheel_F450_Arm.SLDPRT, DJI_Flame_Wheel_F450_High_Landing_Gear.SLDPRT, DJI_Flame_Wheel_F450_PowerDistribution.SLDPRT, DJI_Flame_Wheel_F450_TopPCB.SLDPRT, Mount_Lidar_V1_base.sldprt, Mount_Lidar_V1_fixture.sldprt, Mount_Max32_V1.sldprt]
2021-09-10 finished 3D model design
    [BLDC_A2212_13T_1000KV.SLDPRT, BLDC_A2212_13T_1000KV_Assemly.SLDASM, BLDC_A2212_13T_1000KV_PropCollar.SLDPRT, BLDC_A2212_13T_1000KV_PropNut.SLDPRT, BLDC_A2212_13T_1000KV_PropThread.SLDPRT, DJI_Flame_Wheel_F450.SLDASM, DJI_Flame_Wheel_F450_Arm.SLDPRT, DJI_Flame_Wheel_F450_High_Landing_Gear.SLDPRT]
2021-10-06 New hardware schematic complete, bug fix for rc_rx, increase baud rate of uart1
    [IO.sch, Microprocessor.sch, OSAVC.sch, OSAVC_pwr.sch]
2022-01-11 rev 1.1 OSAVC completed
    [IMU_data_060321.csv, IO.sch, Microprocessor.sch, OSAVC.csv, OSAVC.kicad_pcb, OSAVC_pwr.sch, gyro_bias_data.csv, gyro_rotation_data.csv]
2022-01-11 Added back the mounting holes in rev1.1 OSAVC
    [IO.sch, OSAVC.kicad_pcb]
2022-01-11 grounded mounting holes
    [IO.sch, OSAVC.kicad_pcb]
2022-02-04 bug in mavlink minimal fixed
    [OSAVC.kicad_pcb]
2022-02-08 moved printf statements into debug mode only
2022-02-09 Increased control frequency to reduce errors in encoders
2022-02-16 updated rcrx, minimal, and low level python
    [logfile.csv]
2022-02-19 deleted superfluous printf()
2022-02-23 fixing companion computer snafu
    [OSAVC_web_server.py]
2022-02-24 Update RCRX for all switches Added all channels to RCRX, implementing all physical switches and decoding entire byte stream.
2022-05-02 updated python code
    [AGV_sensor_dat.csv, log_20220222-162205_test.csv, log_20220223-122544.csv, log_20220223-122622.csv, log_20220223-122721.csv, log_20220223-122935.csv, log_20220223-123201.csv, mag_unwrapped.csv]
2022-05-04 white sequence generated for motor testing
2022-05-17 Battery voltage initial version
2022-07-20 updated IMU code
2022-07-21 reverted IMU code to floats, added tumble test for data collection
2022-07-25 Updating to SW2021
    [BLDC_A2212_13T_1000KV.SLDPRT, BLDC_A2212_13T_1000KV_Assemly.SLDASM, BLDC_A2212_13T_1000KV_PropCollar.SLDPRT, BLDC_A2212_13T_1000KV_PropNut.SLDPRT, BLDC_A2212_13T_1000KV_PropThread.SLDPRT, DJI_Flame_Wheel_F450.SLDASM, DJI_Flame_Wheel_F450_Arm.SLDPRT, DJI_Flame_Wheel_F450_High_Landing_Gear.SLDPRT]
2022-08-01 Adding stabilization platform parts
    [DJI_Flame_Wheel_F450_PowerDistribution.SLDPRT, Mount_Controller.SLDPRT, Mount_FrSky_R-XSR_Tiny_16.sldprt, Quadcopter_DJI_Flame_Wheel_F450.SLDASM]
2022-08-04 implemented hash feature to detect failed RC commands
    [quad_main.c]
2022-08-05 Fixed main code bug and updated calibration matrix values
2022-08-09 Added radio telemetry, RC_RX confirmation before servo init
2022-08-09 AHRS tweak for speed, bug fixing rover_passthrough
    [rover_main.c]
2022-08-09 Updated quad_main.c to fix boot issue
    [quad_main.c, rover_main.c]
2022-08-11 updated passthrough apps to incorporate changes to servo library
2022-08-11 Added mechanical parts
    [Chassis_upper.stp, Pi_tray.stp, gps_shelf_leg.stp, micro_holder.stp, sensor_shelf.stp]
2022-08-16 PID controller implemented. No derivative filtering yet.
2022-08-18 Adding hybrid sensor mechanical files
    [Arducam B0332.stp, Arducam_B0332.SLDPRT, Board_AS5047D.SLDPRT, Chassis_upper.SLDPRT, Chassis_upper.stp, Hybrid_sensor.SLDASM, LIDAR-Lite_V3HP_Garmin.SLDPRT, Magnet_AS5047D.SLDPRT]
2022-08-18 Fixing assembly error
    [Hybrid_sensor.SLDASM, Mount_Hybrid_sensor.SLDPRT]
2022-08-21 Adding 3D print files for hybrid sensor
    [Chassis_upper.SLDPRT, Hex_Standoffs.SLDPRT, Hex_standoff_75mm.SLDPRT, Hybrid_sensor.SLDASM, Hybrid_sensor_Rover_mount.SLDPRT, LIDAR-Lite_V3HP_Garmin.SLDPRT, MG996R SBORKA.SLDASM, Mount_Hybrid_sensor-Camera.SLDPRT]
2022-08-23 updated Dorveaux calibration
    [tumble_1.csv]
2022-08-24 gyro stabilization app generated and tested
2022-08-29 minor change to gyro_main
2022-09-02 Quadrotor gyro stabilization developed and tested
2022-11-02 Updated AHRS to provide quaternion attitude and gyro biases rather than euler angles
2022-11-03 Implemented heading control, but issue with PID library remains
    [h_ctrl_main.c]
2022-11-08 Added encoders to rover
2022-11-09 Updated rover_main with odometry
2022-11-14 Fixed RCRX dropout issue, and implemented position, attitude, and encoder mavlink messages. Needs testing!
    [rover_main.c]
2022-11-15 Testing odometry at reduced transmission rates (20Hz)
2022-11-17 Fixed PID error!
2022-12-21 cleaning up dev
    [logfile.csv]
2022-12-27 Incorporated velocity control in GNC
    [logfile.csv]
2022-12-27 Single waypoint navigation using odometry and AHRS working
2022-12-28 Enabled SPI error interrupt--fixed IMU errors; added extra waypoints to missions
    [GNC_main.c]
2022-12-29 Added second error clearing to IMU and implemented LTP coordinates from GPS into Rover_GNC
    [GNC_main.c]
2023-01-29 Enabled UART error interrupts for GPS driver
2023-01-29 Added error conditions to SPI2 interrupt
2023-07-13 Adding KiCad OSAVC 3D model
    [OSAVC.kicad_pcb]
2023-07-18 Adding CAD files for prototype
    [Axis_bar.SLDPRT, BLDC_A2212_13T_1000KV.SLDPRT, BLDC_A2212_13T_1000KV_MountPlate.SLDPRT, BLDC_A2212_13T_1000KV_PropCollar.SLDPRT, BLDC_A2212_13T_1000KV_PropNut.SLDPRT, BLDC_A2212_13T_1000KV_PropThread.SLDPRT, BLDC_A2212_13T_1000KV_Rotator.SLDPRT, BLDC_A2212_13T_1000KV_Stator.SLDPRT]
2023-07-23 Fix equations.txt assembly settings
    [Balancing_bot-Base.SLDASM, Balancing_bot-Link1.SLDASM, Bottom_plate.SLDPRT, MDF_Base.SLDPRT, Main_support_back.SLDPRT, Main_support_front.SLDPRT, Main_support_middle.SLDPRT, Top_plate.SLDPRT]
2023-07-27 Changing middle support to 3D printed parts
    [Axis_bar.SLDPRT, Balancing_bot-Base.SLDASM, Balancing_bot-Link1.SLDASM, Bearing_6mm.SLDPRT, Bearing_holder_back.SLDPRT, Bearing_holder_front.SLDPRT, Board_AS5047D.SLDPRT, C_0603_1608Metric.SLDPRT]
2023-07-28 Replacing middle support for 3D printed parts.
    [BLDC_A2212_13T_1000KV.SLDPRT, BLDC_A2212_13T_1000KV_PropCollar.SLDPRT, BLDC_A2212_13T_1000KV_PropNut.SLDPRT, BLDC_A2212_13T_1000KV_PropThread.SLDPRT, BLDC_A2212_13T_1000KV_Rotator.SLDPRT, BLDC_A2212_13T_1000KV_Stator.SLDPRT, Balancing_bot-Base.SLDASM, Bearing_holder_back.SLDPRT]
2023-07-28 Adding lasercut files.
    [00_Lasercut_MDF.DXF, 01_Lasercut_MDF.DXF, Lasercut_MDF.SLDDRW, Lasercut_acrylic_.DXF, Lasercut_acrylic_.SLDDRW]
2023-08-13 Balance Bot prototype added
